gustavowd/FreePMU/Documents/F769-pinout1.jpg

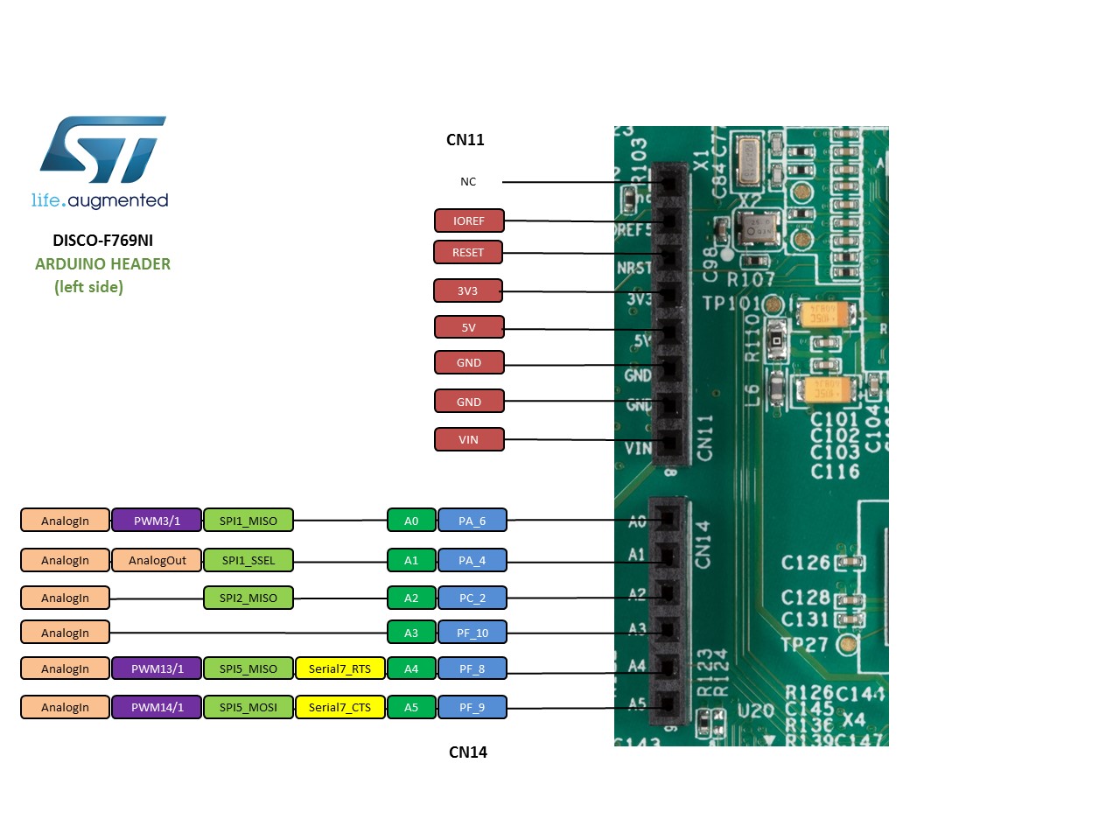
Documents/F769-pinout1.jpg
