gustavowd/FreePMU/Documents/F769-pinout2.jpg

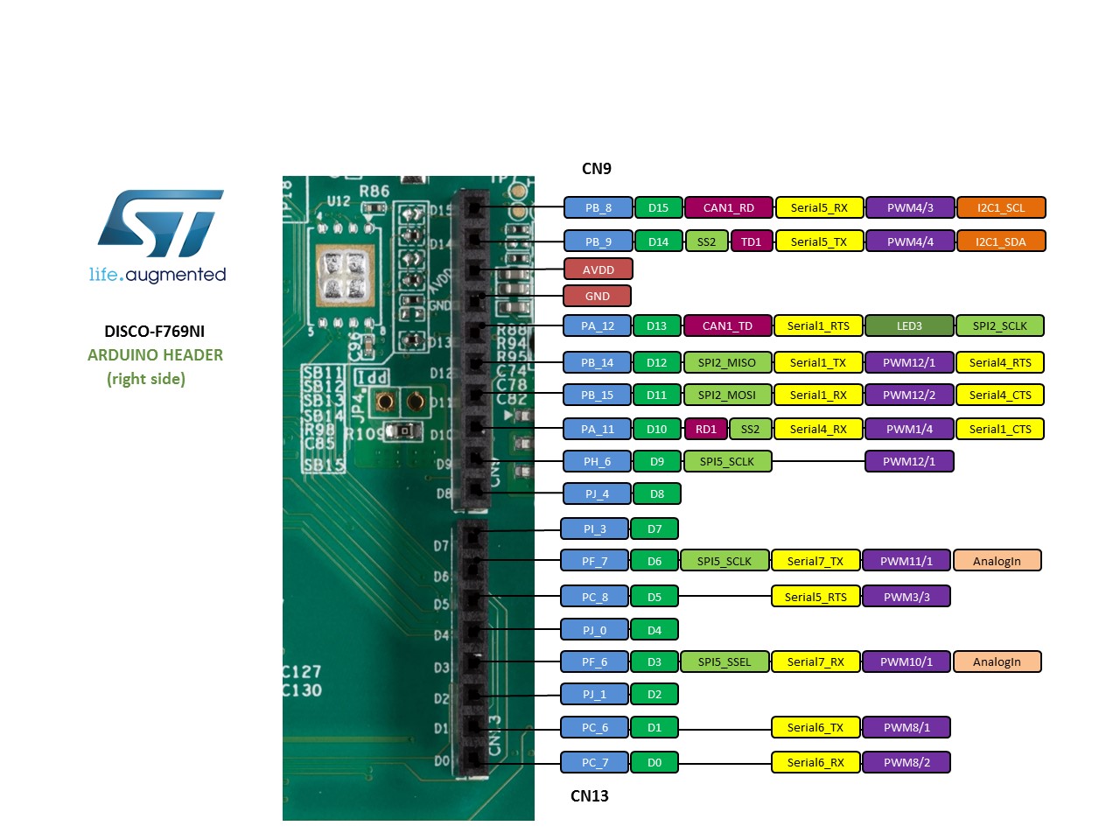
Documents/F769-pinout2.jpg
