gustavowd/FreePMU/Documents/GPS-pinout.jpg

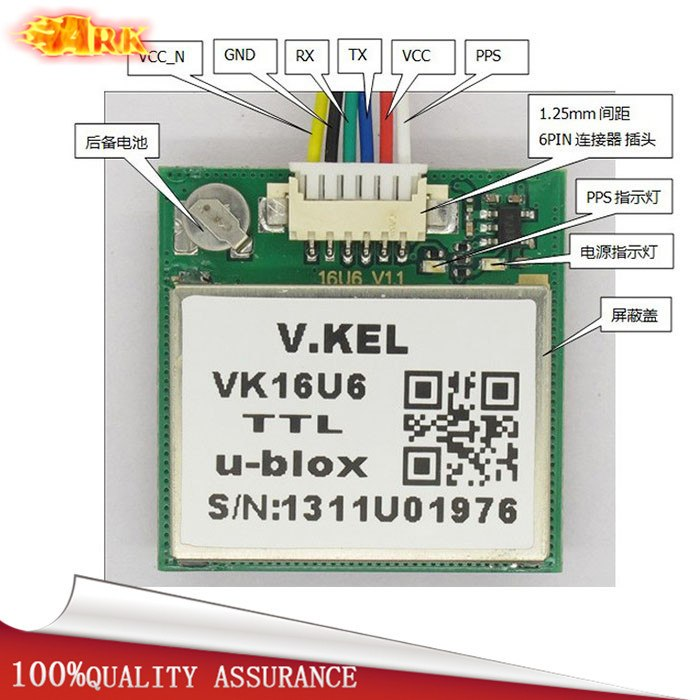
Documents/GPS-pinout.jpg
