gustavowd/FreePMU/Documents/pinout.png

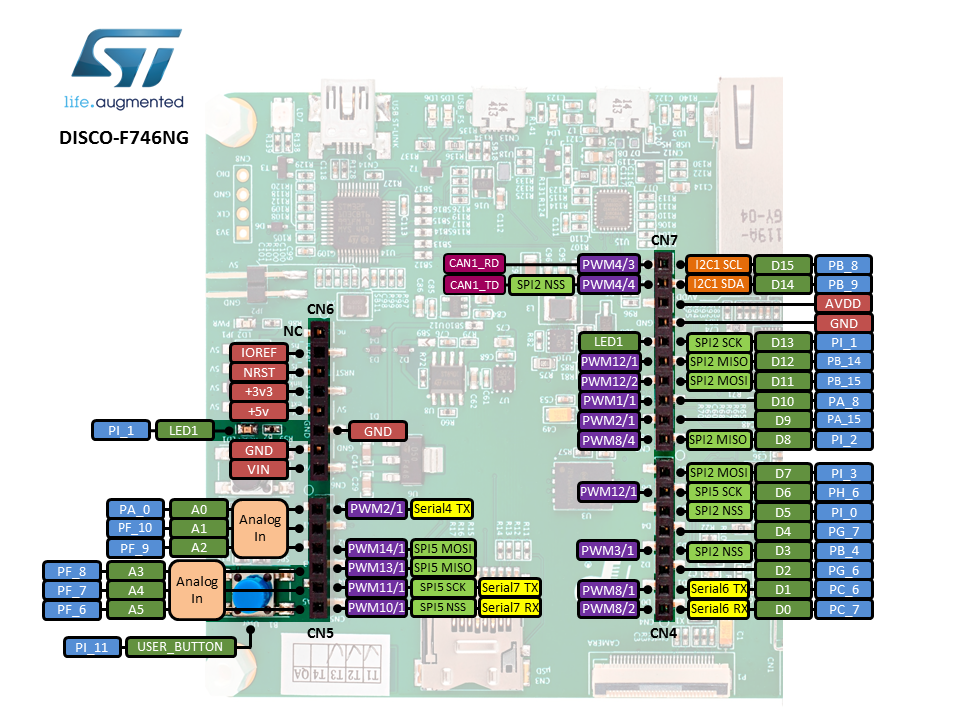
Documents/pinout.png
