gustavowd/FreePMU/Images/prototype.jpg

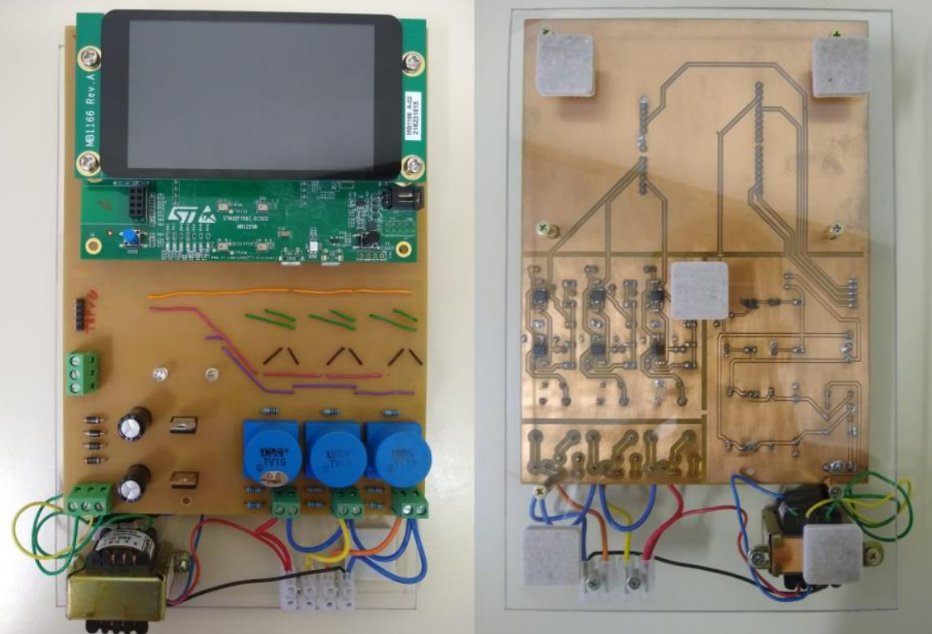
Images/prototype.jpg
