gustavowd/FreePMU/ProjetoEmbWizard/grid_a.bmp

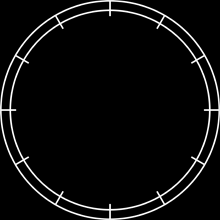
ProjetoEmbWizard/grid_a.bmp
