gustavowd/FreePMU/(threads)

Thread 3 (2022-02-03):

Add a UI switch to turn on/off the sampling rate correction

miguelmoreto, 2022-02-03:
In the Settings screen, it should be useful to add a switch to turn on or off the auto-adjustment of the sampling frequency according to the measured system frequency.  In the current version, this setting is a #define.
