gustavowd/FreePMU/PCB/microPMU-PCB-components.pdf

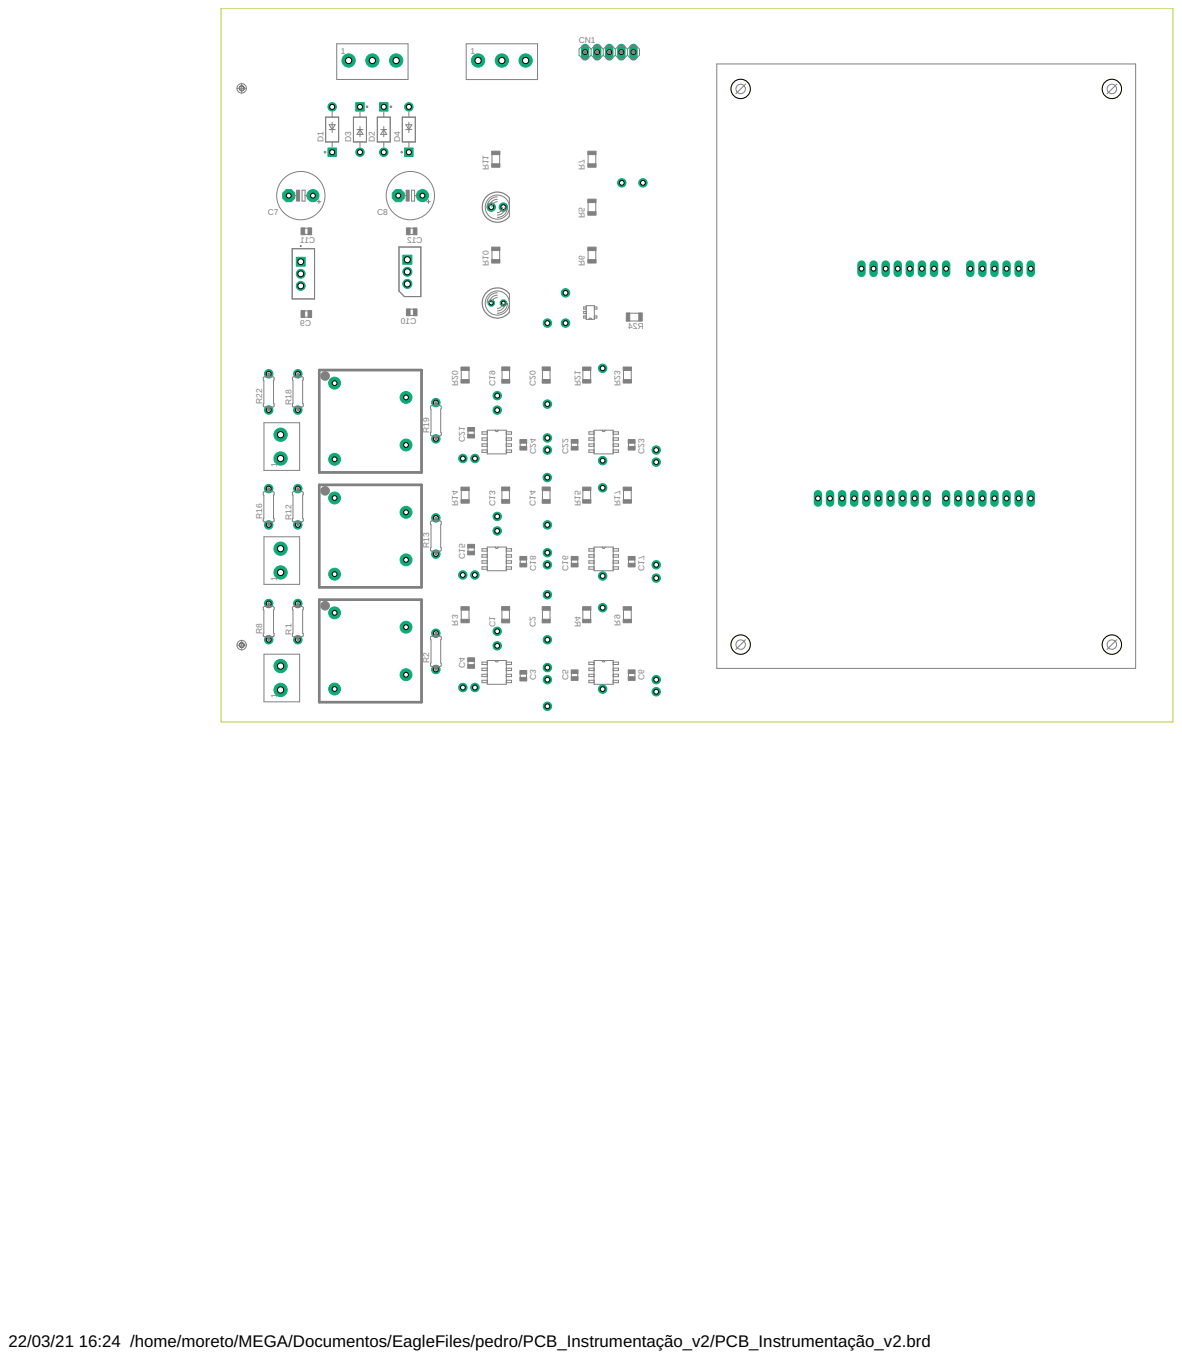
[picture p10: page 1]

22/03/21 16:24 /home/moreto/MEGA/Documentos/EagleFiles/pedro/PCB_Instrumentação_v2/PCB_Instrumentação_v2.brd
