gustavowd/FreePMU/PCB/microPMU-schematic.pdf

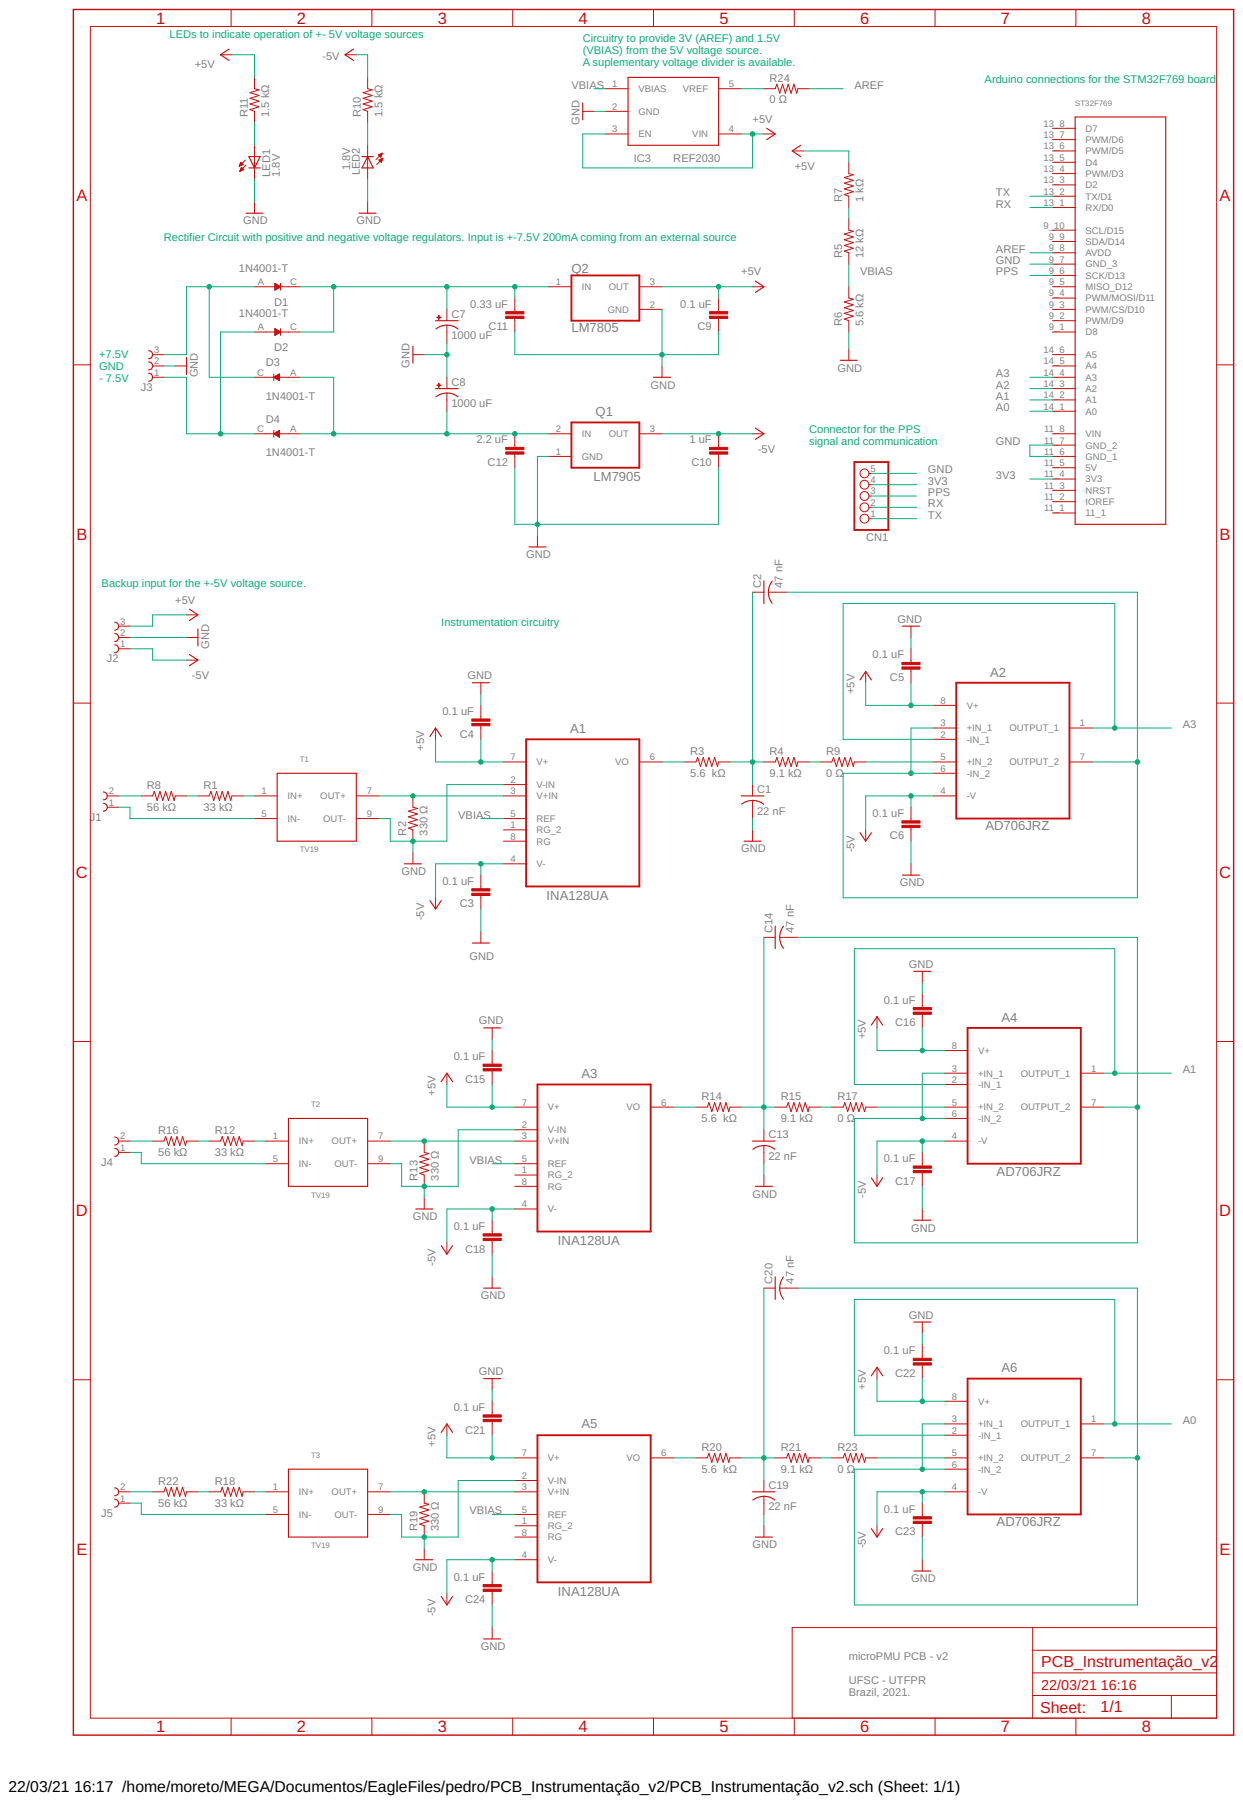
[picture p11: page 1]

LEDs to indicate operation of +- 5V voltage sources

Circuitry to provide 3V (AREF) and 1.5V

Rectifier Circuit with positive and negative voltage regulators. Input is +-7.5V 200mA coming from an external source

Backup input for the +-5V voltage source.

microPMU PCB - v2 UFSC - UTFPR Brazil, 2021.

Sheet: 1/1

22/03/21 16:17 /home/moreto/MEGA/Documentos/EagleFiles/pedro/PCB_Instrumentação_v2/PCB_Instrumentação_v2.sch (Sheet: 1/1)
