gustavowd/FreePMU/PCB/microPMU-PCB-all.pdf

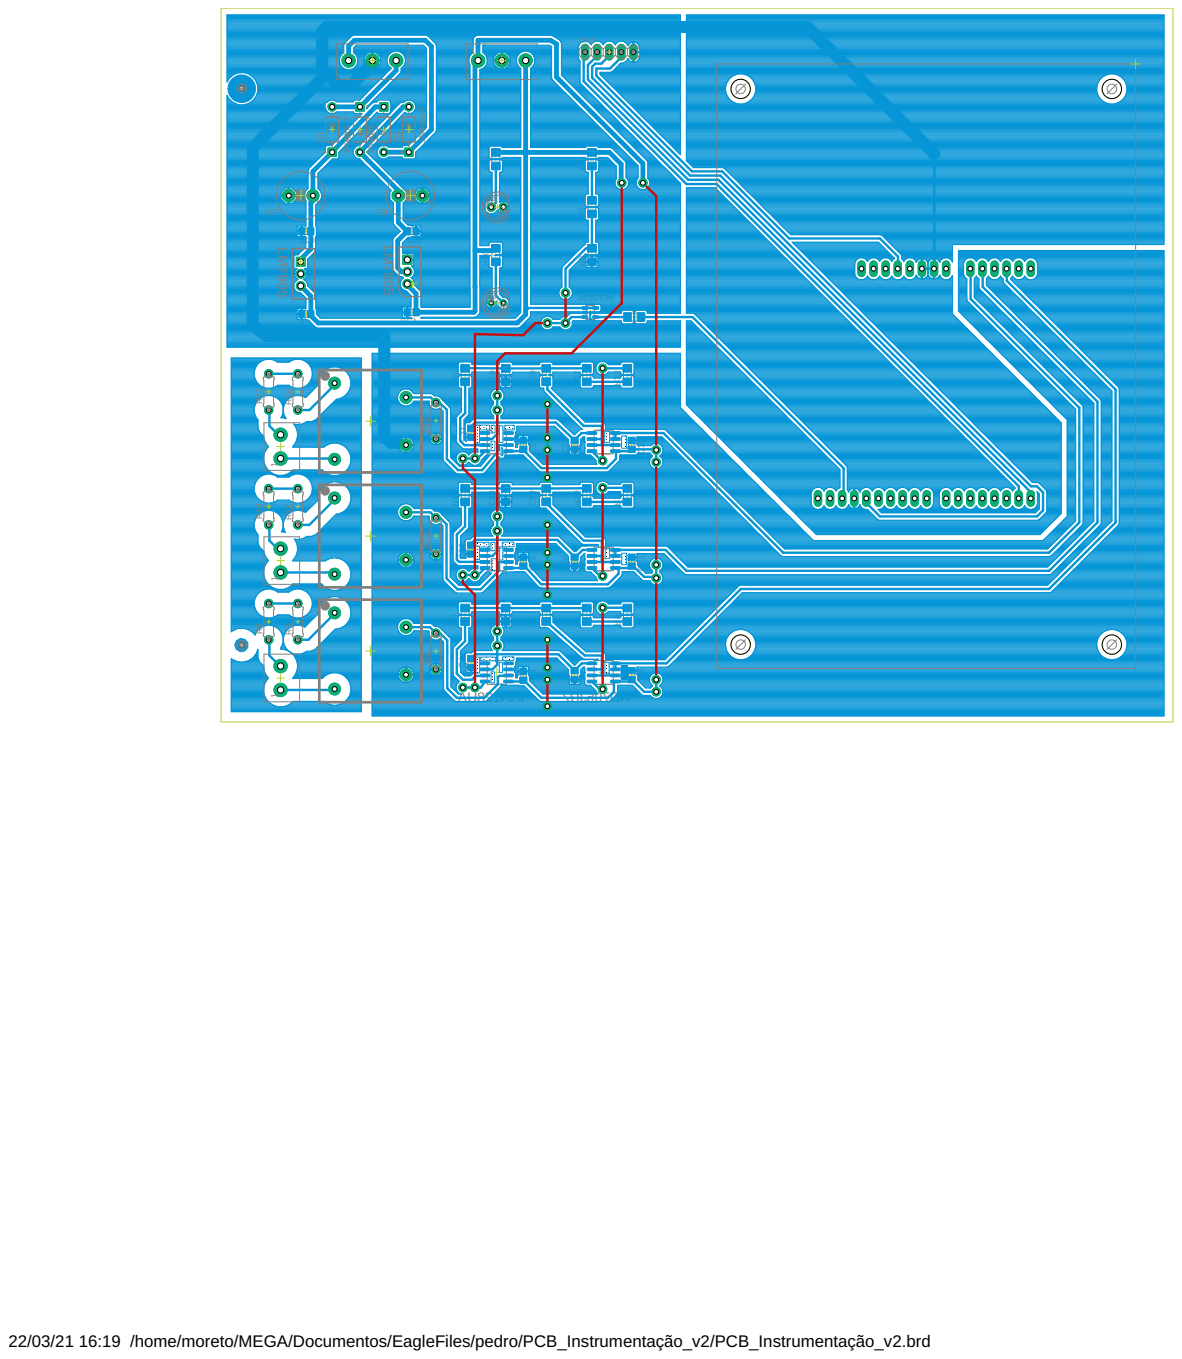
[picture p12: page 1]

22/03/21 16:19 /home/moreto/MEGA/Documentos/EagleFiles/pedro/PCB_Instrumentação_v2/PCB_Instrumentação_v2.brd
