gustavowd/FreePMU/PCB/microPMU-PCB-botton.pdf

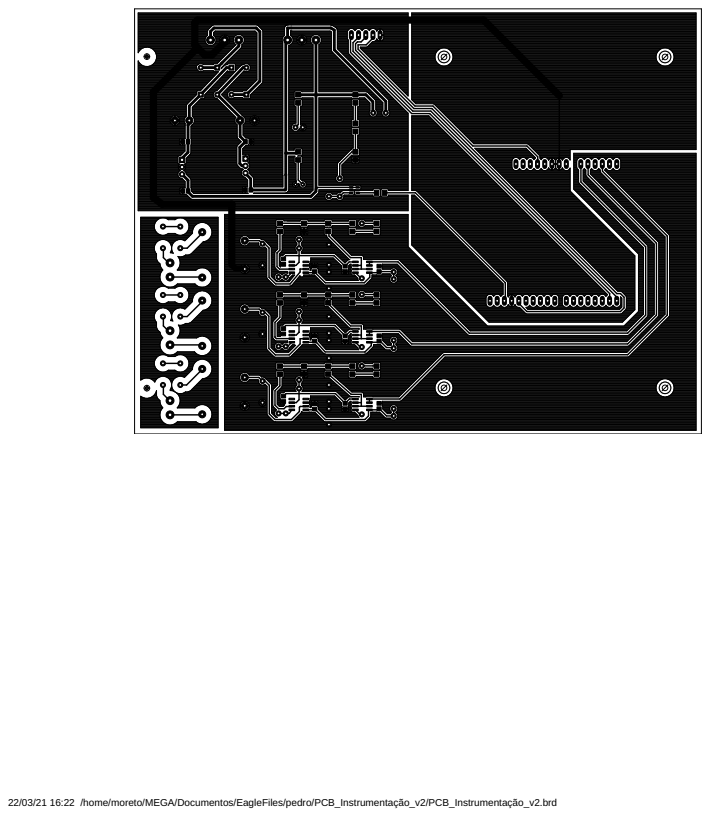
[picture p13: page 1]

22/03/21 16:22 /home/moreto/MEGA/Documentos/EagleFiles/pedro/PCB_Instrumentação_v2/PCB_Instrumentação_v2.brd
