gustavowd/FreePMU/PCB/PCB_Instrumentação_v2.brd

## EAGLE design PCB/PCB_Instrumentação_v2.brd (2021-03-22)

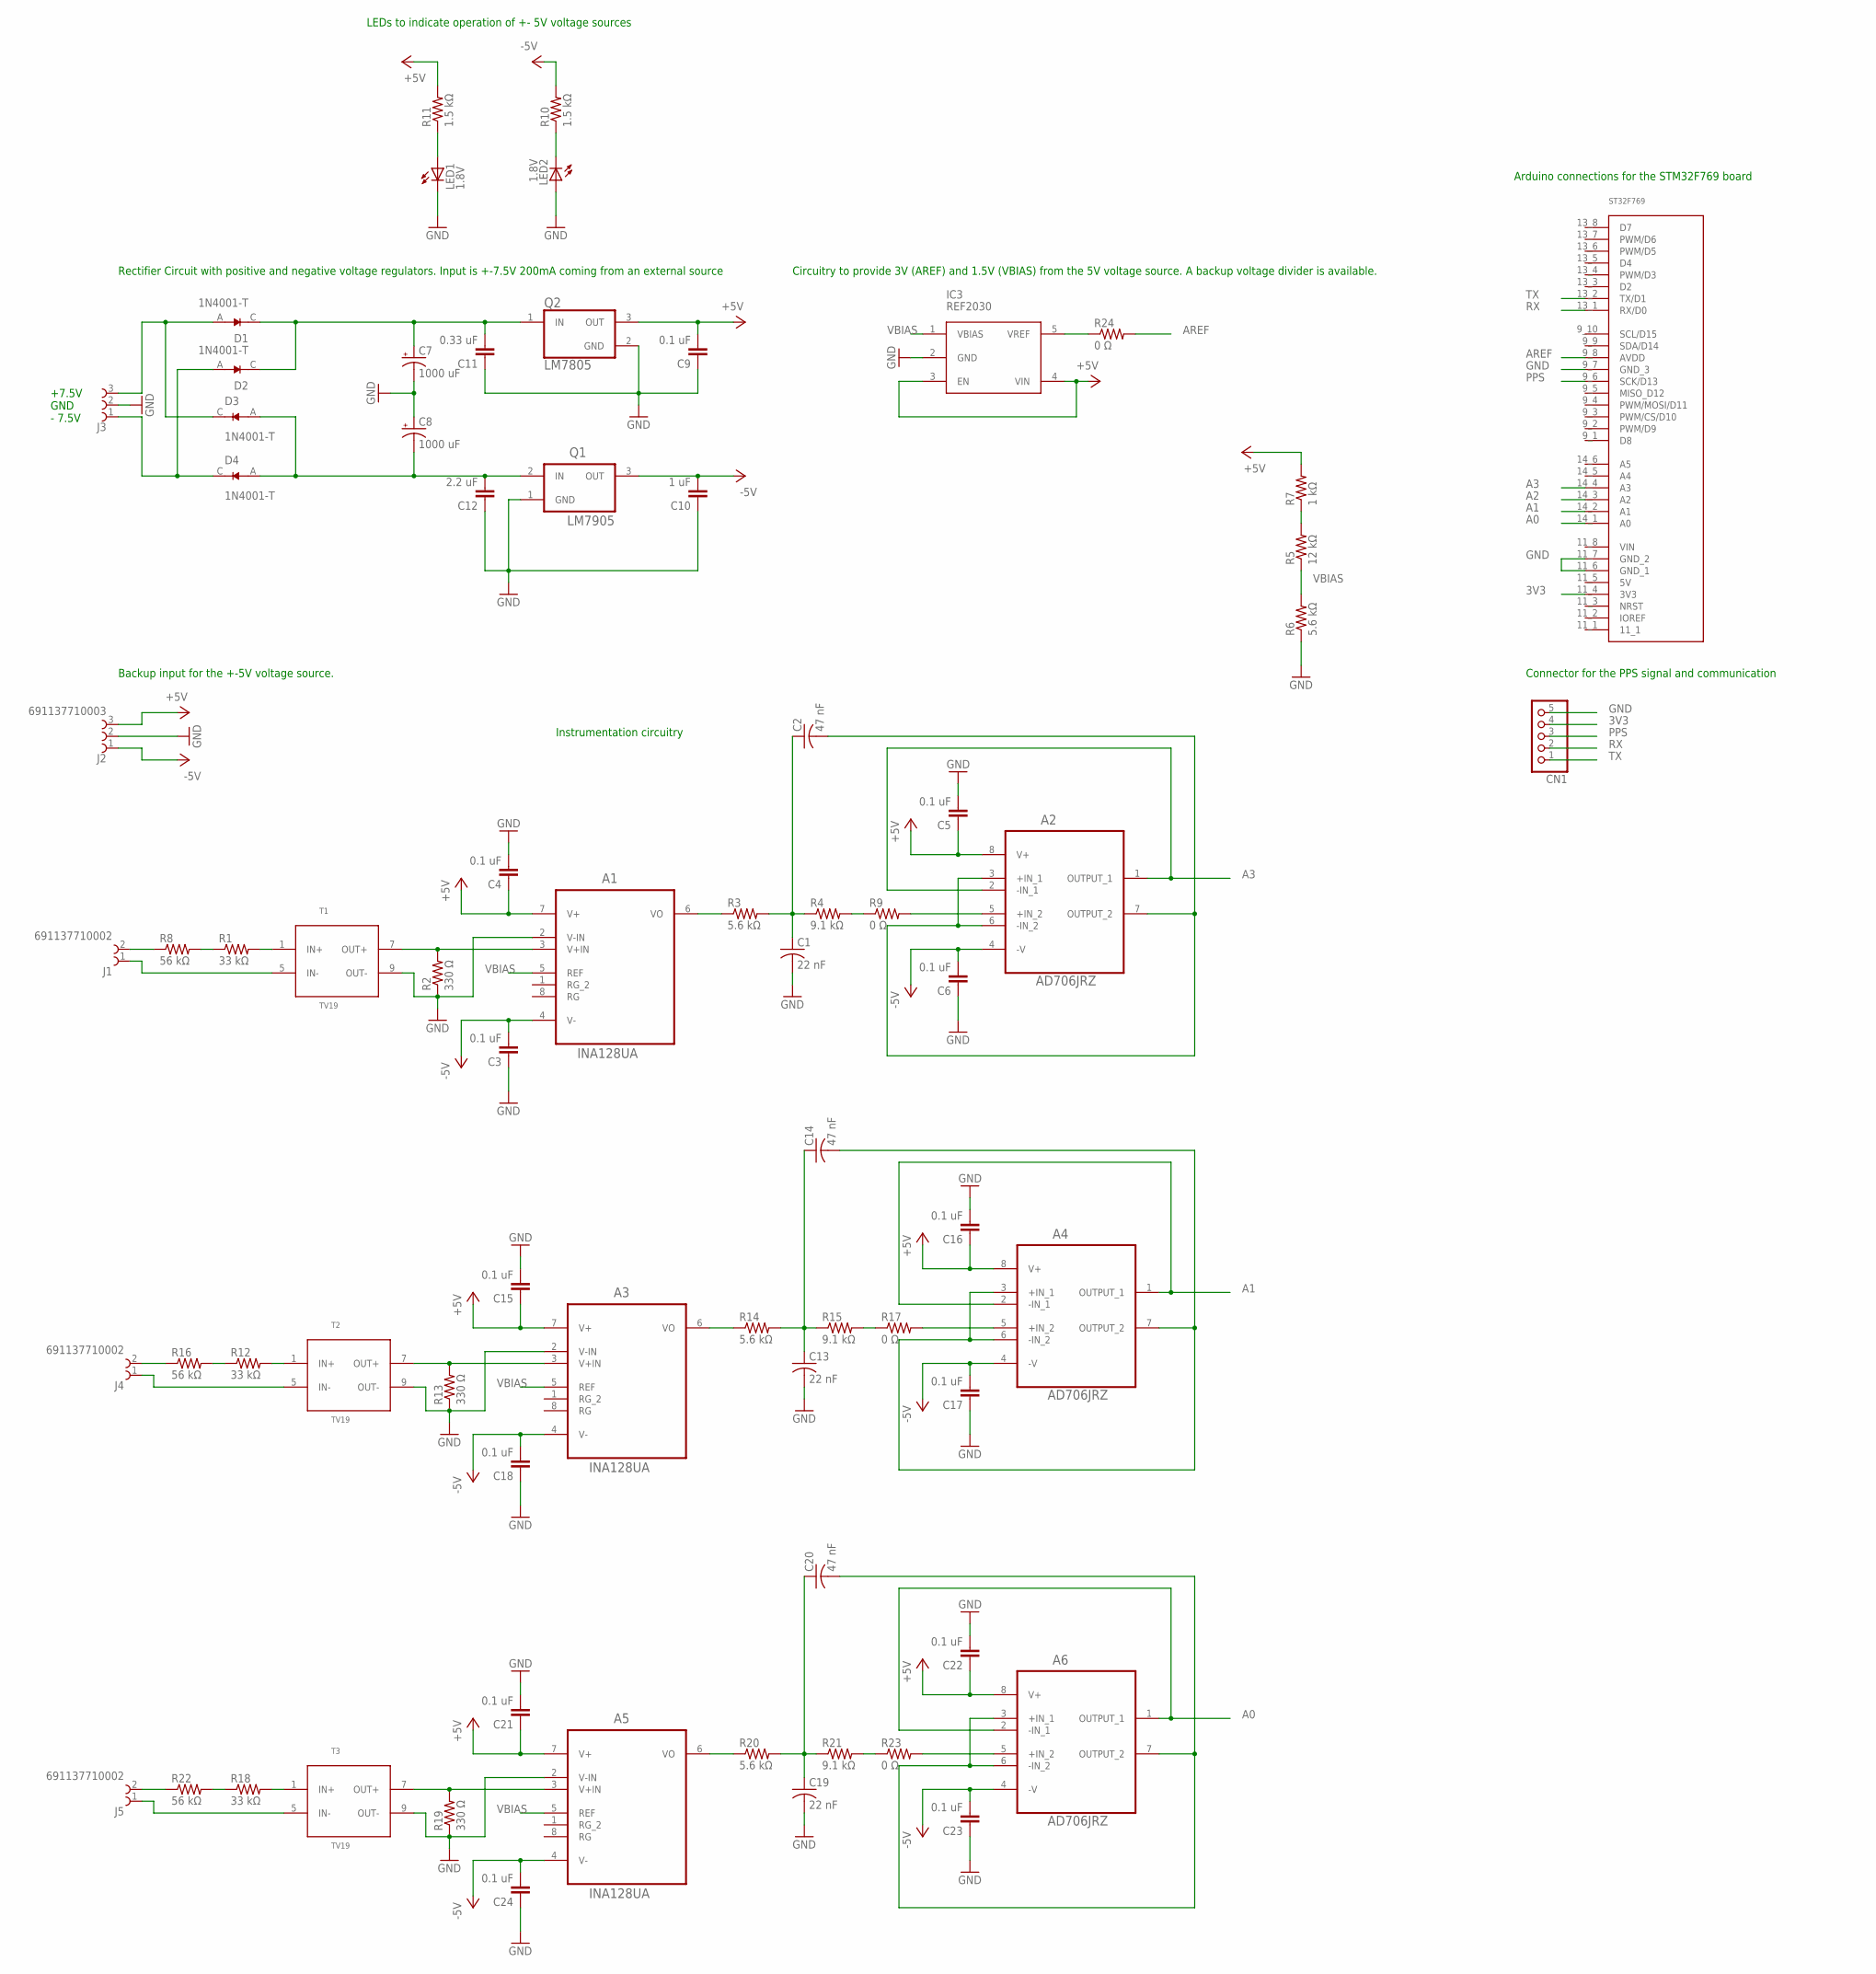
[picture p15: schematic PCB_Instrumentação_v2.sch]

Parts:
A1, A3, A5: INA128UA; SOIC127P600X175-8N
A2, A4, A6: AD706JRZ; SOIC127P600X175-8N
C1, C13, C19: 22 nF; C1206
C2, C14, C20: 47 nF; C1206
C3, C4, C5, C6, C9, C15, C16, C17, C18, C21, C22, C23, C24: 0.1 uF; C0805
C7, C8: 1000 uF; E5-10,5
C10: 1 uF; C0805
C11: 0.33 uF; C0805
C12: 2.2 uF; C0805
CN1: PINHD-1X5; 1X05
D1, D2, D3, D4: 1N4001-T; DIOAD953W69L521D272
IC3: REF2030; TSOT-23_S5
J1, J4, J5: 691137710002
J2, J3: 691137710003
LED1, LED2: 1.8V; LED5MM
Q1: LM7905; TO254P450X1020X1935-3P
Q2: LM7805; TO254P1054X470X2600-3
R1, R12, R18: 33 kΩ; 0207/7
R2, R13, R19: 330 Ω; 0207/7
R3, R6, R14, R20: 5.6 kΩ; R1206
R4, R15, R21: 9.1 kΩ; R1206
R5: 12 kΩ; R1206
R7: 1 kΩ; R1206
R8, R16, R22: 56 kΩ; 0207/7
R9, R17, R23, R24: 0 Ω; R1206
R10, R11: 1.5 kΩ; R1206
T1, T2, T3: TV19
U$1: ST32F769

Connections:
3V3: CN1.4, U$1.11_4 (3V3)
+5V: A1.7 (V+), A2.8 (V+), A3.7 (V+), A4.8 (V+), A5.7 (V+), A6.8 (V+), C4.1, C5.1, C9.2, C15.1, C16.1, C21.1, C22.1, IC3.3 (EN), IC3.4 (VIN), J2.3, Q2.3 (OUT), R7.2, R11.2
-5V: A1.4 (V-), A2.4 (-V), A3.4 (V-), A4.4 (-V), A5.4 (V-), A6.4 (-V), C3.2, C6.2, C10.2, C17.2, C18.2, C23.2, C24.2, J2.1, Q1.3 (OUT), R10.2
A0: A6.1 (OUTPUT_1), A6.2 (-IN_1), U$1.14_1 (A0)
A1: A4.1 (OUTPUT_1), A4.2 (-IN_1), U$1.14_2 (A1)
A2: U$1.14_3 (A2)
A3: A2.1 (OUTPUT_1), A2.2 (-IN_1), U$1.14_4 (A3)
AREF: R24.2, U$1.9_8 (AVDD)
GND: A1.2 (V-IN), A3.2 (V-IN), A5.2 (V-IN), C1.2, C3.1, C4.2, C5.2, C6.1, C7.-, C8.+, C9.1, C10.1, C11.1, C12.1, C13.2, C15.2, C16.2, C17.1, C18.1, C19.2, C21.2, C22.2, C23.1, C24.1, CN1.5, IC3.2 (GND), J2.2, J3.2, LED1.K (C), LED2.A, Q1.1 (GND), Q2.2 (GND), R2.1, R6.1, R13.1, R19.1, T1.9 (OUT-), T2.9 (OUT-), T3.9 (OUT-), U$1.9_7 (GND_3), U$1.11_6 (GND_1), U$1.11_7 (GND_2)
unnamed: R1.2, T1.1 (IN+)
unnamed: A1.3 (V+IN), R2.2, T1.7 (OUT+)
unnamed: A1.6 (VO), R3.1
unnamed: C1.1, C2.1, R3.2, R4.1
unnamed: R4.2, R9.1
unnamed: A2.3 (+IN_1), A2.6 (-IN_2), A2.7 (OUTPUT_2), C2.2
unnamed: R5.2, R7.1
unnamed: J1.2, R8.1
unnamed: J1.1, T1.5 (IN-)
unnamed: R1.1, R8.2
unnamed: C7.+, C11.2, D1.C, D2.C, Q2.1 (IN)
unnamed: C8.-, C12.2, D3.A, D4.A, Q1.2 (IN)
unnamed: D2.A, D4.C, J3.1
unnamed: D1.A, D3.C, J3.3
unnamed: A2.5 (+IN_2), R9.2
unnamed: LED1.A, R11.1
unnamed: LED2.K (C), R10.1
unnamed: R12.2, T2.1 (IN+)
unnamed: A3.3 (V+IN), R13.2, T2.7 (OUT+)
unnamed: A3.6 (VO), R14.1
unnamed: C13.1, C14.1, R14.2, R15.1
unnamed: A4.3 (+IN_1), A4.6 (-IN_2), A4.7 (OUTPUT_2), C14.2
unnamed: J4.1, T2.5 (IN-)
unnamed: J4.2, R16.1
unnamed: R12.1, R16.2
unnamed: R15.2, R17.1
unnamed: A4.5 (+IN_2), R17.2
unnamed: R18.2, T3.1 (IN+)
unnamed: A5.3 (V+IN), R19.2, T3.7 (OUT+)
unnamed: A5.6 (VO), R20.1
unnamed: C19.1, C20.1, R20.2, R21.1
unnamed: A6.3 (+IN_1), A6.6 (-IN_2), A6.7 (OUTPUT_2), C20.2
unnamed: J5.1, T3.5 (IN-)
unnamed: J5.2, R22.1
unnamed: R18.1, R22.2
unnamed: R21.2, R23.1
unnamed: A6.5 (+IN_2), R23.2
unnamed: IC3.5 (VREF), R24.1
PPS: CN1.3, U$1.9_6 (SCK/D13)
RX: CN1.2, U$1.13_1 (RX/D0)
TX: CN1.1, U$1.13_2 (TX/D1)
VBIAS: A1.5 (REF), A3.5 (REF), A5.5 (REF), IC3.1 (VBIAS), R5.1, R6.2

Notes on the sheet:
LEDs to indicate operation of +- 5V voltage sources
Rectifier Circuit with positive and negative voltage regulators. Input is +-7.5V 200mA coming from an external source
Circuitry to provide 3V (AREF) and 1.5V (VBIAS) from the 5V voltage source. A backup voltage divider is available.
Arduino connections for the STM32F769 board
Backup input for the +-5V voltage source.
Connector for the PPS signal and communication
Instrumentation circuitry
+7.5V GND - 7.5V

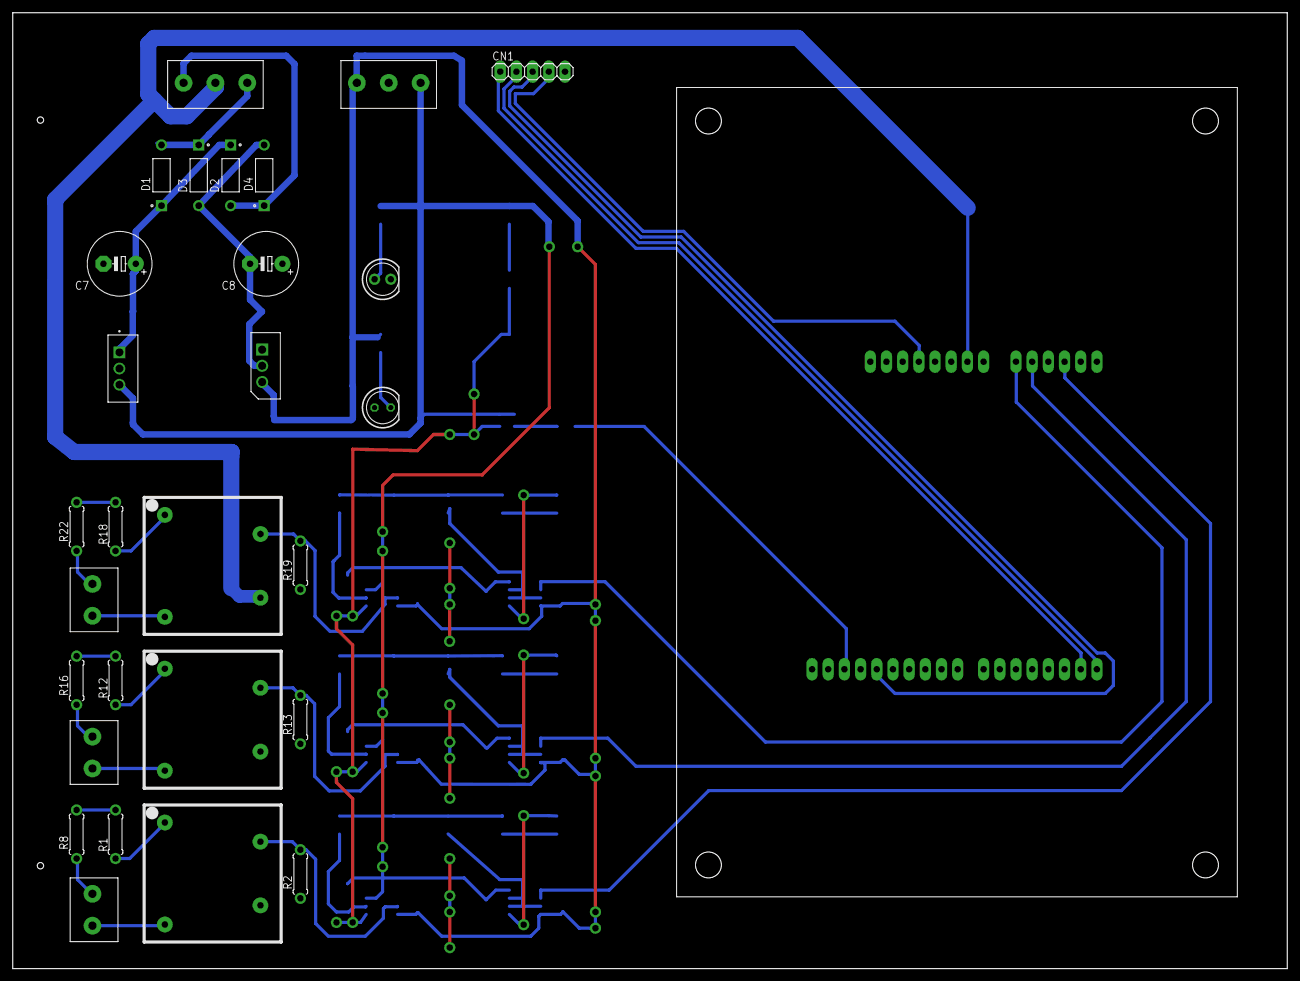
[picture p16: board PCB_Instrumentação_v2.brd from above]

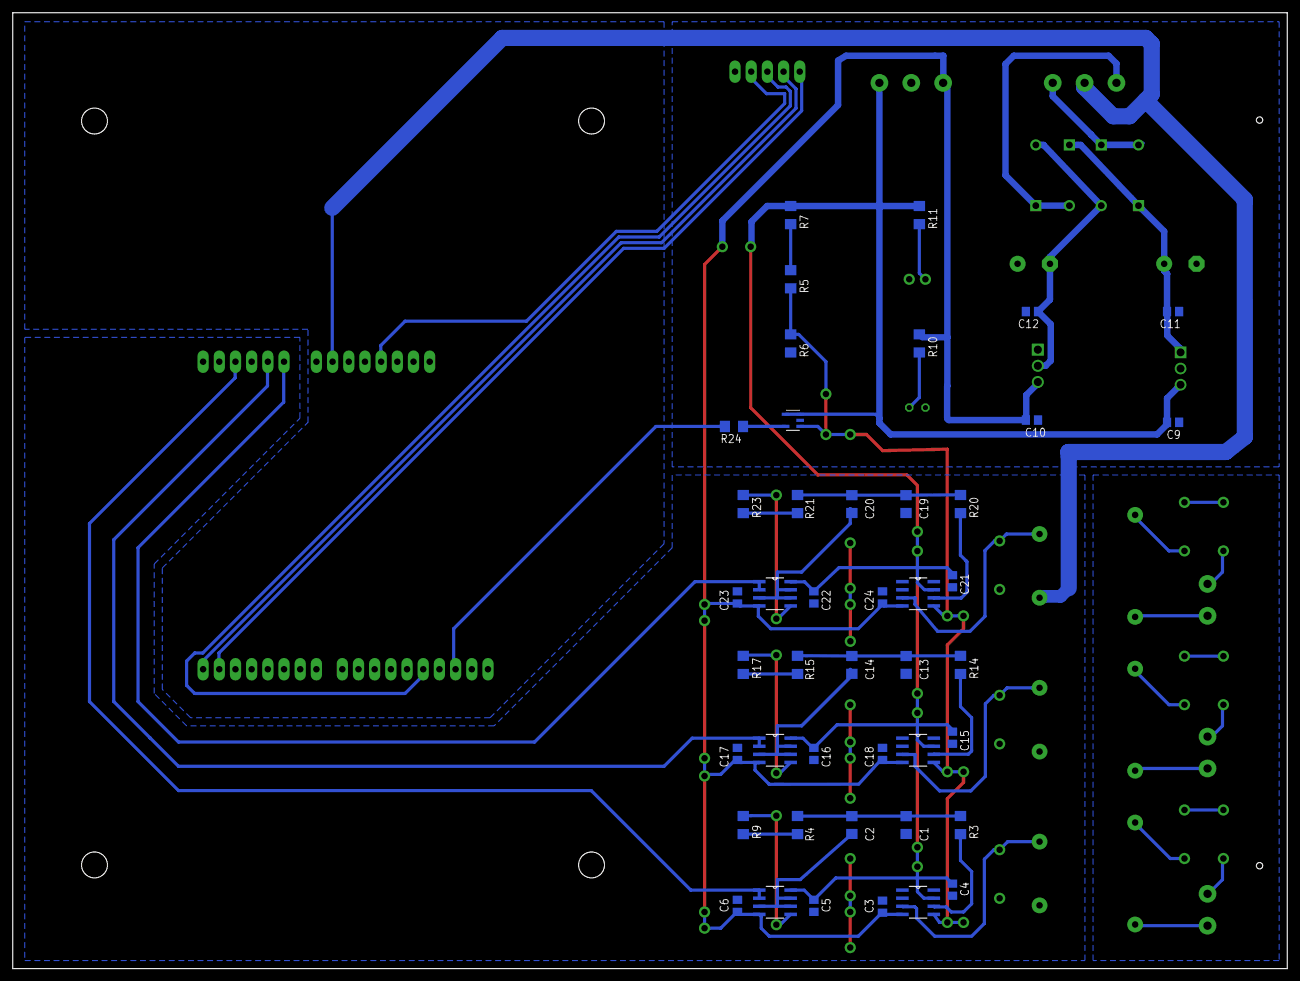
[picture p17: board PCB_Instrumentação_v2.brd from below]

Board: 2 copper layers, 200.0 x 150.0 mm, 73 parts (44 on the bottom side), 50 nets.
