gustavowd/FreePMU/STM32F769_EWizard/Inc/main.h

#define U8    unsigned char
#define I8    signed char
#define U16   unsigned short
#define I16   signed short
#define U32   unsigned
#define I32   int
#define U32   unsigned long
#define I32   signed long
#define PMUID	0x0001
#define NOMINAL_FREQ 60
#define NOMINAL_VOLTAGE 127
#define ENABLE_HARMONICS 1
#define OVERSAMPLING 1
#define GPS_BAUDRATE 115200
#define SIMULATED_GPS 0
#define FRACAO_DE_SEGUNDO_INIT 0
#define FRACAO_DE_SEGUNDO 0x00008235  //Fração de segundo 0,03333
#define LIMITE_FRACAO_DE_SEGUNDO 0xEC00B
#define FRACAO_DE_SEGUNDO 0x00009C40  // Fração de segundo = 0,04
#define LIMITE_FRACAO_DE_SEGUNDO 0xEA600
#define PEAK_GAIN	(float)2.0
#define RMS_GAIN	(float)1.414213562
#define PEAK_OR_RMS	RMS_GAIN
#define TCP_PMU 0
#define UDP_PMU 1
#define TRANSPORT_PROTOCOL TCP_PMU
#define CORR_HTIM1 1
#define NORM_GAIN_127V_R	(float)3.048178533
#define NORM_GAIN_127V_S	(float)3.031196288
#define NORM_GAIN_127V_T	(float)3.047962608
#define NORM_GAIN_220V_R	(float)1.759630335
#define NORM_GAIN_220V_S	(float)1.749826948
#define NORM_GAIN_220V_T	(float)1.759505687
#define MAG_GAIN_R			(float)42.3832
#define MAG_GAIN_S			(float)42.4718
#define MAG_GAIN_T			(float)42.45794
#define FIT_MAG_GAIN_A_R	(float)-0.0016362996
#define FIT_MAG_GAIN_B_R	(float)6.4330443785
#define FIT_MAG_GAIN_C_R	(float)0.0658874232
#define FIT_MAG_GAIN_D_R	(float)0.0351025233
#define FIT_MAG_GAIN_A_S	(float)0.0009628812
#define FIT_MAG_GAIN_B_S	(float)6.3757106266
#define FIT_MAG_GAIN_C_S	(float)0.0686457110
#define FIT_MAG_GAIN_D_S	(float)0.0299965117
#define FIT_MAG_GAIN_A_T	(float)0.0004282697
#define FIT_MAG_GAIN_B_T	(float)6.4019875313
#define FIT_MAG_GAIN_C_T	(float)0.0981472053
#define FIT_MAG_GAIN_D_T	(float)0.0467723654
#define FIT_PHASE_GAIN_A_R	(float)60.256916502
#define FIT_PHASE_GAIN_B_R	(float)0.1863745932
#define FIT_PHASE_GAIN_C_R	(float)0.0076768782
#define FIT_PHASE_GAIN_A_S	(float)60.273407182
#define FIT_PHASE_GAIN_B_S	(float)0.2463213789
#define FIT_PHASE_GAIN_C_S	(float)0.0144579474
#define FIT_PHASE_GAIN_A_T	(float)60.271458135
#define FIT_PHASE_GAIN_B_T	(float)0.1695834628
#define FIT_PHASE_GAIN_C_T	(float)0.0045740754
#define FIT_FREQ_GAIN_A_R		(float)-2.5770186918
#define FIT_FREQ_GAIN_B_R		(float)0.0521374904
#define FIT_FREQ_GAIN_A_S		(float)-2.6741303661
#define FIT_FREQ_GAIN_B_S		(float)0.0537621928
#define FIT_FREQ_GAIN_A_T		(float)-2.3885333996
#define FIT_FREQ_GAIN_B_T		(float)0.0485053178
