gustavowd/FreePMU/STM32F769_EWizard/Src/EmbeddedWizardApp/Core.c

/*******************************************************************************
*
* E M B E D D E D   W I Z A R D   P R O J E C T
*
*                                                Copyright (c) TARA Systems GmbH
*                                    written by Paul Banach and Manfred Schweyer
*
********************************************************************************
*
* This file was generated automatically by Embedded Wizard Studio.
*
* Please do not make any modifications of this file! The modifications are lost
* when the file is generated again by Embedded Wizard Studio!
*
* The template of this heading text can be found in the file 'head.ewt' in the
* directory 'Platforms' of your Embedded Wizard installation directory. If you
* wish to adapt this text, please copy the template file 'head.ewt' into your
* project directory and edit the copy only. Please avoid any modifications of
* the original template file!
*
* Version  : 9.00
* Profile  : STM32F769
* Platform : STM.STM32.RGB565
*
*******************************************************************************/

#include "ewlocale.h"
#include "_ApplicationAplic.h"
#include "_CoreCursorEvent.h"
#include "_CoreCursorGrabEvent.h"
#include "_CoreCursorHit.h"
#include "_CoreDialogContext.h"
#include "_CoreDragEvent.h"
#include "_CoreEvent.h"
#include "_CoreGroup.h"
#include "_CoreKeyEvent.h"
#include "_CoreKeyPressHandler.h"
#include "_CoreLayoutContext.h"
#include "_CoreLayoutLineContext.h"
#include "_CoreLayoutQuadContext.h"
#include "_CoreLineView.h"
#include "_CoreModalContext.h"
#include "_CoreOutline.h"
#include "_CoreQuadView.h"
#include "_CoreRectView.h"
#include "_CoreResource.h"
#include "_CoreRoot.h"
#include "_CoreSimpleTouchHandler.h"
#include "_CoreSystemEvent.h"
#include "_CoreSystemEventHandler.h"
#include "_CoreSystemEventTask.h"
#include "_CoreTask.h"
#include "_CoreTaskQueue.h"
#include "_CoreTimer.h"
#include "_CoreView.h"
#include "_CoreWipeTouchHandler.h"
#include "_GraphicsCanvas.h"
#include "_ResourcesBitmap.h"
#include "Core.h"

/* Compressed strings for the language 'Default'. */
static const unsigned int _StringsDefault0[] =
{
  0x000002E6, /* ratio 50.13 % */
  0xB8005500, 0x00000452, 0x00D0002A, 0x04000328, 0xD2003B00, 0xA770042C, 0x00320021,
  0x639C4CDE, 0x00464DD1, 0x998A2C74, 0xC7A3E6C8, 0x6A431633, 0xA1521874, 0x510E8E44,
  0x0758F9CA, 0x00831C00, 0x082C0C2C, 0x8747C9C0, 0xAC322510, 0x8027F2C8, 0x86390C99,
  0x0C60030C, 0x3B383580, 0x256834EC, 0x56A244E2, 0xA8F00261, 0x8943A431, 0x04BA8B1E,
  0x4D2655A0, 0x4C25389B, 0xE83469ED, 0x994694D5, 0x7068C462, 0x42AADAC3, 0x5A645A29,
  0xB9002912, 0x0458F200, 0x59A2D7BB, 0x1A6F358D, 0xCA56B1A4, 0x6735A744, 0x91089472,
  0x0FADD7E1, 0x292802FF, 0x90D32311, 0x88022F96, 0x6164F56C, 0x4F2921A7, 0xF4589874,
  0x034DD5E7, 0xD0C92EC7, 0x6B2C4E05, 0xBD0C2A11, 0x2860A264, 0x05923747, 0x47B34480,
  0x5F83B48C, 0x0DB0CAD6, 0xE70C9180, 0xB0E8C44E, 0xA596C4A2, 0x38FD870B, 0x9063CD52,
  0x7D7A3F1D, 0x4A30913E, 0xCE191887, 0xA2DD1D54, 0x9D1AE099, 0xD1F21C3B, 0xF7000EAF,
  0x8D1FC08F, 0x1C41B6D6, 0x982705B9, 0x14AD7079, 0x391E531B, 0x0E4950C5, 0x53145531,
  0x10E5411C, 0x0439E057, 0x012666DD, 0x45811280, 0x4BDD8819, 0x1FC1C516, 0x14313543,
  0x04234E02, 0x9880D338, 0x819E079D, 0x6224790C, 0xF6162389, 0x821270E0, 0x266C5D67,
  0x4063E4E2, 0x00000000
};

/* Constant values used in this 'C' module only. */
static const XPoint _Const0000 = { 0, 0 };
static const XRect _Const0001 = {{ 0, 0 }, { 0, 0 }};
static const XStringRes _Const0002 = { _StringsDefault0, 0x0003 };
static const XStringRes _Const0003 = { _StringsDefault0, 0x002D };
static const XStringRes _Const0004 = { _StringsDefault0, 0x0043 };
static const XStringRes _Const0005 = { _StringsDefault0, 0x0060 };
static const XStringRes _Const0006 = { _StringsDefault0, 0x0072 };
static const XColor _Const0007 = { 0x00, 0x00, 0x00, 0x00 };
static const XStringRes _Const0008 = { _StringsDefault0, 0x008D };
static const XStringRes _Const0009 = { _StringsDefault0, 0x00C1 };
static const XStringRes _Const000A = { _StringsDefault0, 0x0119 };
static const XStringRes _Const000B = { _StringsDefault0, 0x0151 };

#ifndef EW_DONT_CHECK_INDEX
  /* This function is used to check the indices when accessing an array.
     If you don't want this verification add the define EW_DONT_CHECK_INDEX
     to your Makefile or project settings. */
  static int EwCheckIndex( int aIndex, int aRange, const char* aFile, int aLine )
  {
    if (( aIndex < 0 ) || ( aIndex >= aRange ))
    {
      EwPrint( "[FATAL ERROR in %s:%d] Array index %d out of bounds %d",
                aFile, aLine, aIndex, aRange );
      EwPanic();
    }
    return aIndex;
  }

  #define EwCheckIndex( aIndex, aRange ) \
    EwCheckIndex( aIndex, aRange, __FILE__, __LINE__ )
#else
  #define EwCheckIndex( aIndex, aRange ) aIndex
#endif

/* Global constant containing the preferred size of the screen in pixel. */
const XPoint EwScreenSize = { 800, 480 };

/* Global constant containing the main application class. */
const XClass EwApplicationClass = EW_CLASS( ApplicationAplic );

/* Global constant containing the user defined application title. */
const char* EwApplicationTitle = "";

/* Initializer for the class 'Core::View' */
void CoreView__Init( CoreView _this, XObject aLink, XHandle aArg )
{
  /* At first initialize the super class ... */
  XObject__Init( &_this->_Super, aLink, aArg );

  /* Setup the VMT pointer */
  _this->_VMT = EW_CLASS( CoreView );

  /* ... and initialize objects, variables, properties, etc. */
  _this->viewState = CoreViewStateAlphaBlended | CoreViewStateFastReshape | CoreViewStateVisible;
  _this->Layout = CoreLayoutAlignToLeft | CoreLayoutAlignToTop;
}

/* Re-Initializer for the class 'Core::View' */
void CoreView__ReInit( CoreView _this )
{
  /* At first re-initialize the super class ... */
  XObject__ReInit( &_this->_Super );
}

/* Finalizer method for the class 'Core::View' */
void CoreView__Done( CoreView _this )
{
  /* Finalize this class */
  _this->_VMT = EW_CLASS( CoreView );

  /* Don't forget to deinitialize the super class ... */
  XObject__Done( &_this->_Super );
}

/* Garbage Collector method for the class 'Core::View' */
void CoreView__Mark( CoreView _this )
{
  EwMarkObject( _this->next );
  EwMarkObject( _this->prev );
  EwMarkObject( _this->Owner );
  EwMarkObject( _this->layoutContext );

  /* Give the super class a chance to mark its objects and references */
  XObject__Mark( &_this->_Super );
}

/* 'C' function for method : 'Core::View.initLayoutContext()' */
void CoreView_initLayoutContext( CoreView _this, XRect aBounds, CoreOutline aOutline )
{
  /* Dummy expressions to avoid the 'C' warning 'unused argument'. */
  EW_UNUSED_ARG( _this );
  EW_UNUSED_ARG( aOutline );
  EW_UNUSED_ARG( aBounds );
}

/* Wrapper function for the virtual method : 'Core::View.initLayoutContext()' */
void CoreView__initLayoutContext( void* _this, XRect aBounds, CoreOutline aOutline )
{
  ((CoreView)_this)->_VMT->initLayoutContext((CoreView)_this, aBounds, aOutline );
}

/* 'C' function for method : 'Core::View.OnSetLayout()' */
void CoreView_OnSetLayout( CoreView _this, XSet value )
{
  XSet delta = value ^ _this->Layout;

  if ( !delta )
    return;

  _this->Layout = value;

  if (( _this->layoutContext != 0 ) && !(( _this->viewState & CoreViewStateEmbedded 
      ) == CoreViewStateEmbedded ))
  {
    _this->Owner->Super2.viewState = _this->Owner->Super2.viewState | ( CoreViewStatePendingLayout 
    | CoreViewStateUpdateLayout );
    EwPostSignal( EwNewSlot( _this->Owner, CoreGroup_updateComponent ), ((XObject)_this 
      ));
    CoreGroup__InvalidateArea( _this->Owner, EwGetRectORect( _this->Owner->Super1.Bounds 
    ));
  }

  if (( _this->layoutContext != 0 ) && (( _this->viewState & CoreViewStateEmbedded 
      ) == CoreViewStateEmbedded ))
  {
    _this->layoutContext->outline->Super2.viewState = _this->layoutContext->outline->Super2.viewState 
    | CoreViewStateUpdateLayout;
    _this->Owner->Super2.viewState = _this->Owner->Super2.viewState | CoreViewStatePendingLayout;
    EwPostSignal( EwNewSlot( _this->Owner, CoreGroup_updateComponent ), ((XObject)_this 
      ));
  }
}

/* The method GetRoot() delivers the application object, this view belongs to. The 
   application object represents the entire screen of the GUI application. Thus 
   in the views hierarchy, the application object serves as the root view.
   This method can fail and return null if the view still doesn't belong to any 
   owner group. */
CoreRoot CoreView_GetRoot( CoreView _this )
{
  CoreGroup grp = _this->Owner;

  while ( grp != 0 )
  {
    CoreRoot root = EwCastObject( grp, CoreRoot );

    if ( root != 0 )
      return root;

    grp = grp->Super2.Owner;
  }

  return 0;
}

/* Wrapper function for the virtual method : 'Core::View.GetRoot()' */
CoreRoot CoreView__GetRoot( void* _this )
{
  return ((CoreView)_this)->_VMT->GetRoot((CoreView)_this );
}

/* The method Draw() is invoked automatically if parts of the view should be redrawn 
   on the screen. This can occur when e.g. the view has been moved or the appearance 
   of the view has changed before.
   Draw() is invoked automatically by the framework, you never will need to invoke 
   this method directly. However you can request an invocation of this method by 
   calling the method InvalidateArea() of the views @Owner. Usually this is also 
   unnecessary unless you are developing your own view.
   The passed parameters determine the drawing destination aCanvas and the area 
   to redraw aClip in the coordinate space of the canvas. The parameter aOffset 
   contains the displacement between the origin of the views owner and the origin 
   of the canvas. You will need it to convert views coordinates into these of the 
   canvas.
   The parameter aOpacity contains the opacity descended from this view's @Owner. 
   It lies in range 0 .. 255. If the view implements its own 'Opacity', 'Color', 
   etc. properties, the Draw() method should calculate the resulting real opacity 
   by mixing the values of these properties with the one passed in aOpacity parameter.
   The parameter aBlend contains the blending mode descended from this view's @Owner. 
   It determines, whether the view should be drawn with alpha-blending active or 
   not. If aBlend is false, the outputs of the view should overwrite the corresponding 
   pixel in the drawing destination aCanvas. If aBlend is true, the outputs should 
   be mixed with the pixel already stored in aCanvas. For this purpose all Graphics 
   Engine functions provide a parameter to specify the mode for the respective drawing 
   operation. If the view implements its own 'Blend' property, the Draw() method 
   should calculate the resulting real blend mode by using logical AND operation 
   of the value of the property and the one passed in aBlend parameter. */
void CoreView_Draw( CoreView _this, GraphicsCanvas aCanvas, XRect aClip, XPoint 
  aOffset, XInt32 aOpacity, XBool aBlend )
{
  /* Dummy expressions to avoid the 'C' warning 'unused argument'. */
  EW_UNUSED_ARG( _this );
  EW_UNUSED_ARG( aBlend );
  EW_UNUSED_ARG( aOpacity );
  EW_UNUSED_ARG( aOffset );
  EW_UNUSED_ARG( aClip );
  EW_UNUSED_ARG( aCanvas );
}

/* Wrapper function for the virtual method : 'Core::View.Draw()' */
void CoreView__Draw( void* _this, GraphicsCanvas aCanvas, XRect aClip, XPoint aOffset, 
  XInt32 aOpacity, XBool aBlend )
{
  ((CoreView)_this)->_VMT->Draw((CoreView)_this, aCanvas, aClip, aOffset, aOpacity
  , aBlend );
}

/* The method HandleEvent() is invoked automatically if the view has received an 
   event. For example, touching the view on the touch screen can cause the view 
   to receive a Core::CursorEvent event. Within this method the view can evaluate 
   the event and react to it.
   Whether the event has been handled by the view or not is determined by the return 
   value. To sign an event as handled HandleEvent() should return a valid object 
   (e.g. 'this'). If the event has not been handled, 'null' should be returned.
   Depending on the kind of the event, the framework can continue dispatching of 
   still unhandled events. For example, keyboard events (Core::KeyEvent class) are 
   automatically delivered to the superior @Owner of the receiver view if this view 
   has ignored the event.
   HandleEvent() is invoked automatically by the framework, so you never should 
   need to invoke it directly. However you can prepare and post new events by using 
   the methods DispatchEvent() and BroadcastEvent() of the application class Core::Root. */
XObject CoreView_HandleEvent( CoreView _this, CoreEvent aEvent )
{
  /* Dummy expressions to avoid the 'C' warning 'unused argument'. */
  EW_UNUSED_ARG( _this );
  EW_UNUSED_ARG( aEvent );

  return 0;
}

/* Wrapper function for the virtual method : 'Core::View.HandleEvent()' */
XObject CoreView__HandleEvent( void* _this, CoreEvent aEvent )
{
  return ((CoreView)_this)->_VMT->HandleEvent((CoreView)_this, aEvent );
}

/* The method CursorHitTest() is invoked automatically in order to determine whether 
   the view is interested in the receipt of cursor events or not. This method will 
   be invoked immediately after the user has tapped the visible area of the view. 
   If the view is not interested in the cursor event, the framework repeats this 
   procedure for the next behind view until a willing view has been found or all 
   views are evaluated.
   In the implementation of the method the view can evaluate the passed aArea parameter. 
   It determines the place where the user has tapped the view with his fingertip 
   expressed in the coordinates of the views @Owner. The method can test e.g. whether 
   the tapped area does intersect any touchable areas within the view, etc. The 
   affected finger is identified in the parameter aFinger. The first finger (or 
   the first mouse device button) has the number 0.
   The parameter aStrikeCount determines how many times the same area has been tapped 
   in series. This is useful to detect series of multiple touches, e.g. in case 
   of the double click, aStrikeCount == 2.
   The parameter aDedicatedView, if it is not 'null', restricts the event to be 
   handled by this view only. If aDedicatedView == null, no special restriction 
   exists.
   This method is also invoked if during an existing grab cycle the current target 
   view has decided to resign and deflect the cursor events to another view. This 
   is usually the case after the user has performed a gesture the current target 
   view is not interested to process. Thereupon, the system looks for another view 
   willing to take over the cursor event processing after the performed gesture. 
   Which gesture has caused the operation, is specified in the parameter aRetargetReason.
   If the view is willing to process the event, the method should create, initialize 
   and return a new Core::CursorHit object. This object identify the willing view. 
   Otherwise the method should return 'null'.
   CursorHitTest() is invoked automatically by the framework, so you never should 
   need to invoke it directly. This method is predetermined for the hit-test only. 
   The proper processing of events should take place in the @HandleEvent() method 
   by reacting to Core::CursorEvent and Core::DragEvent events. */
CoreCursorHit CoreView_CursorHitTest( CoreView _this, XRect aArea, XInt32 aFinger, 
  XInt32 aStrikeCount, CoreView aDedicatedView, XSet aRetargetReason )
{
  /* Dummy expressions to avoid the 'C' warning 'unused argument'. */
  EW_UNUSED_ARG( _this );
  EW_UNUSED_ARG( aRetargetReason );
  EW_UNUSED_ARG( aDedicatedView );
  EW_UNUSED_ARG( aStrikeCount );
  EW_UNUSED_ARG( aFinger );
  EW_UNUSED_ARG( aArea );

  return 0;
}

/* Wrapper function for the virtual method : 'Core::View.CursorHitTest()' */
CoreCursorHit CoreView__CursorHitTest( void* _this, XRect aArea, XInt32 aFinger, 
  XInt32 aStrikeCount, CoreView aDedicatedView, XSet aRetargetReason )
{
  return ((CoreView)_this)->_VMT->CursorHitTest((CoreView)_this, aArea, aFinger, 
  aStrikeCount, aDedicatedView, aRetargetReason );
}

/* The method ArrangeView() is invoked automatically if the superior @Owner group 
   needs to re-arrange its views. For example, the changing of the owners size can 
   cause the enclosed views to adapt their position and size, so all views still 
   fit within the new owners area. This method provides the core functionality for 
   the automatic GUI layout mechanism.
   The arrangement is controlled primarily by the @Layout property of the view. 
   It specifies a set of alignment constraints and determines whether the view can 
   change its size. The bounds area where the view should be arranged, is passed 
   in the parameter aBounds. This is usually the current area of the views owner.
   The parameter aFormation defines the desired arrangement mode. Depending on the 
   value of this parameter, the views can be arranged in rows or columns. If aFormation 
   == Core::Formation.None, no automatic row/column arrangement is performed and 
   the view is moved and scaled only to fit inside the aBounds area.
   ArrangeView() is invoked automatically by the framework, so you never should 
   need to invoke it directly.
   The method returns the size of the view after it has been arranged. */
XPoint CoreView_ArrangeView( CoreView _this, XRect aBounds, XEnum aFormation )
{
  /* Dummy expressions to avoid the 'C' warning 'unused argument'. */
  EW_UNUSED_ARG( _this );
  EW_UNUSED_ARG( aFormation );
  EW_UNUSED_ARG( aBounds );

  return _Const0000;
}

/* Wrapper function for the virtual method : 'Core::View.ArrangeView()' */
XPoint CoreView__ArrangeView( void* _this, XRect aBounds, XEnum aFormation )
{
  return ((CoreView)_this)->_VMT->ArrangeView((CoreView)_this, aBounds, aFormation );
}

/* The method MoveView() changes the position of the view by adding the value aOffset 
   to all corners of the view. For example, in case of a line view the value is 
   added to the both line end points.
   The parameter aFastMove serves for the optimization purpose. If it is 'true', 
   the corners are modified without performing any updates of the view and without 
   redrawing the screen. This is useful, when you wish to move or arrange a lot 
   of views at once. In this case it's up to you to request the finally screen update. 
   To do this you can use the method InvalidateArea() of the views @Owner.
   In the case aFastMove == false, the operation automatically requests the screen 
   redraw of the view areas before and after the movement. You don't need to take 
   care about it. */
void CoreView_MoveView( CoreView _this, XPoint aOffset, XBool aFastMove )
{
  /* Dummy expressions to avoid the 'C' warning 'unused argument'. */
  EW_UNUSED_ARG( _this );
  EW_UNUSED_ARG( aFastMove );
  EW_UNUSED_ARG( aOffset );
}

/* Wrapper function for the virtual method : 'Core::View.MoveView()' */
void CoreView__MoveView( void* _this, XPoint aOffset, XBool aFastMove )
{
  ((CoreView)_this)->_VMT->MoveView((CoreView)_this, aOffset, aFastMove );
}

/* The method GetExtent() returns the position and the size of the view relative 
   to the origin of its @Owner. In case of views with a non rectangular shape the 
   method returns the rectangular boundary area enclosing the entire shape. */
XRect CoreView_GetExtent( CoreView _this )
{
  /* Dummy expressions to avoid the 'C' warning 'unused argument'. */
  EW_UNUSED_ARG( _this );

  return _Const0001;
}

/* Wrapper function for the virtual method : 'Core::View.GetExtent()' */
XRect CoreView__GetExtent( void* _this )
{
  return ((CoreView)_this)->_VMT->GetExtent((CoreView)_this );
}

/* The method ChangeViewState() modifies the current state of the view. The state 
   is a set of switches determining whether a view is visible, whether it can react 
   to user inputs or whether it is just performing some update operations, etc.
   The modification is controlled by the the both parameters. The first aSetState 
   contains the switches to activate within the view state. The second aClearState 
   determines all switches to disable.
   Depending on the state alteration the method will perform different operations, 
   e.g. in response to the clearing of the visible state, the method will request 
   a screen redraw to make disappear the view from the screen.
   ChangeViewState() is invoked automatically by the framework, so you never should 
   need to invoke it directly. All relevant states are available as properties e.g. 
   the property Visible in derived classes reflects the visible state of the view. */
void CoreView_ChangeViewState( CoreView _this, XSet aSetState, XSet aClearState )
{
  XSet newState;
  XSet deltaState;

  if ((( _this->viewState & CoreViewStateIsOutline ) == CoreViewStateIsOutline ))
    aSetState = aSetState & ~CoreViewStateEmbedded;

  newState = ( _this->viewState & ~aClearState ) | aSetState;
  deltaState = newState ^ _this->viewState;
  _this->viewState = newState;

  if (( _this->Owner != 0 ) && !!( deltaState & ( CoreViewStateEnabled | CoreViewStateFocusable 
      )))
  {
    XBool focusable = (( _this->viewState & ( CoreViewStateEnabled | CoreViewStateFocusable 
      )) == ( CoreViewStateEnabled | CoreViewStateFocusable ));

    if ( focusable && ( _this->Owner->Focus == 0 ))
      CoreGroup__OnSetFocus( _this->Owner, _this );

    if ( !focusable && ( _this->Owner->Focus == _this ))
      CoreGroup__OnSetFocus( _this->Owner, CoreGroup_FindSiblingView( _this->Owner, 
      _this, CoreViewStateEnabled | CoreViewStateFocusable ));
  }

  if (( _this->Owner != 0 ) && !!( deltaState & ( CoreViewStateAlphaBlended | CoreViewStateEmbedded 
      | CoreViewStateVisible )))
    CoreGroup__InvalidateArea( _this->Owner, CoreView__GetExtent( _this ));

  if ((( _this->layoutContext != 0 ) && (( newState & CoreViewStateEmbedded ) == 
      CoreViewStateEmbedded )) && (( deltaState & CoreViewStateVisible ) == CoreViewStateVisible 
      ))
  {
    _this->viewState = _this->viewState | CoreViewStateRequestLayout;
    _this->Owner->Super2.viewState = _this->Owner->Super2.viewState | CoreViewStatePendingLayout;
    EwPostSignal( EwNewSlot( _this->Owner, CoreGroup_updateComponent ), ((XObject)_this 
      ));
  }

  if (( _this->Owner != 0 ) && (( deltaState & CoreViewStateEmbedded ) == CoreViewStateEmbedded 
      ))
  {
    _this->layoutContext = 0;
    _this->viewState = _this->viewState | CoreViewStateRequestLayout;
    _this->Owner->Super2.viewState = _this->Owner->Super2.viewState | CoreViewStatePendingLayout;
    EwPostSignal( EwNewSlot( _this->Owner, CoreGroup_updateComponent ), ((XObject)_this 
      ));
  }
}

/* Wrapper function for the virtual method : 'Core::View.ChangeViewState()' */
void CoreView__ChangeViewState( void* _this, XSet aSetState, XSet aClearState )
{
  ((CoreView)_this)->_VMT->ChangeViewState((CoreView)_this, aSetState, aClearState );
}

/* Variants derived from the class : 'Core::View' */
EW_DEFINE_CLASS_VARIANTS( CoreView )
EW_END_OF_CLASS_VARIANTS( CoreView )

/* Virtual Method Table (VMT) for the class : 'Core::View' */
EW_DEFINE_CLASS( CoreView, XObject, "Core::View" )
  CoreView_initLayoutContext,
  CoreView_GetRoot,
  CoreView_Draw,
  CoreView_HandleEvent,
  CoreView_CursorHitTest,
  CoreView_ArrangeView,
  CoreView_MoveView,
  CoreView_GetExtent,
  CoreView_ChangeViewState,
EW_END_OF_CLASS( CoreView )

/* Initializer for the class 'Core::LineView' */
void CoreLineView__Init( CoreLineView _this, XObject aLink, XHandle aArg )
{
  /* At first initialize the super class ... */
  CoreView__Init( &_this->_Super, aLink, aArg );

  /* Setup the VMT pointer */
  _this->_VMT = EW_CLASS( CoreLineView );

  /* ... and initialize objects, variables, properties, etc. */
}

/* Re-Initializer for the class 'Core::LineView' */
void CoreLineView__ReInit( CoreLineView _this )
{
  /* At first re-initialize the super class ... */
  CoreView__ReInit( &_this->_Super );
}

/* Finalizer method for the class 'Core::LineView' */
void CoreLineView__Done( CoreLineView _this )
{
  /* Finalize this class */
  _this->_VMT = EW_CLASS( CoreLineView );

  /* Don't forget to deinitialize the super class ... */
  CoreView__Done( &_this->_Super );
}

/* Garbage Collector method for the class 'Core::LineView' */
void CoreLineView__Mark( CoreLineView _this )
{
  /* Give the super class a chance to mark its objects and references */
  CoreView__Mark( &_this->_Super );
}

/* 'C' function for method : 'Core::LineView.initLayoutContext()' */
void CoreLineView_initLayoutContext( CoreLineView _this, XRect aBounds, CoreOutline 
  aOutline )
{
  CoreLayoutLineContext context = EwNewObject( CoreLayoutLineContext, 0 );

  _this->Super1.layoutContext = 0;
  context->Super1.extent = CoreLineView_getExtent( _this );
  context->Super1.bounds = aBounds;
  context->Super1.outline = aOutline;
  context->point1 = _this->Point1;
  context->point2 = _this->Point2;
  _this->Super1.layoutContext = ((CoreLayoutContext)context );
}

/* The method ArrangeView() is invoked automatically if the superior @Owner group 
   needs to re-arrange its views. For example, the changing of the owners size can 
   cause the enclosed views to adapt their position and size, so all views still 
   fit within the new owners area. This method provides the core functionality for 
   the automatic GUI layout mechanism.
   The arrangement is controlled primarily by the @Layout property of the view. 
   It specifies a set of alignment constraints and determines whether the view can 
   change its size. The bounds area where the view should be arranged, is passed 
   in the parameter aBounds. This is usually the current area of the views owner.
   The parameter aFormation defines the desired arrangement mode. Depending on the 
   value of this parameter, the views can be arranged in rows or columns. If aFormation 
   == Core::Formation.None, no automatic row/column arrangement is performed and 
   the view is moved and scaled only to fit inside the aBounds area.
   ArrangeView() is invoked automatically by the framework, so you never should 
   need to invoke it directly.
   The method returns the size of the view after it has been arranged. */
XPoint CoreLineView_ArrangeView( CoreLineView _this, XRect aBounds, XEnum aFormation )
{
  XSet layout = _this->Super1.Layout;
  CoreLayoutLineContext context = EwCastObject( _this->Super1.layoutContext, CoreLayoutLineContext 
    );
  XInt32 x1 = context->Super1.extent.Point1.X;
  XInt32 y1 = context->Super1.extent.Point1.Y;
  XInt32 x2 = context->Super1.extent.Point2.X;
  XInt32 y2 = context->Super1.extent.Point2.Y;
  XPoint dstSize = EwGetRectSize( aBounds );
  XInt32 w = x2 - x1;
  XInt32 h = y2 - y1;
  XInt32 tmp;

  if ( aFormation == CoreFormationNone )
  {
    XPoint srcSize = EwGetRectSize( context->Super1.bounds );
    x1 = x1 - context->Super1.bounds.Point1.X;
    y1 = y1 - context->Super1.bounds.Point1.Y;

    if ( srcSize.X != dstSize.X )
    {
      XBool alignToLeft = (( layout & CoreLayoutAlignToLeft ) == CoreLayoutAlignToLeft 
        );
      XBool alignToRight = (( layout & CoreLayoutAlignToRight ) == CoreLayoutAlignToRight 
        );
      XBool resizeHorz = (( layout & CoreLayoutResizeHorz ) == CoreLayoutResizeHorz 
        );

      if ( !alignToLeft && ( resizeHorz || !alignToRight ))
        x1 = ( x1 * dstSize.X ) / srcSize.X;

      if ( !alignToRight && ( resizeHorz || !alignToLeft ))
      {
        x2 = x2 - context->Super1.bounds.Point1.X;
        x2 = ( x2 * dstSize.X ) / srcSize.X;
        x2 = x2 - dstSize.X;
      }
      else
        x2 = x2 - context->Super1.bounds.Point2.X;

      x1 = x1 + aBounds.Point1.X;
      x2 = x2 + aBounds.Point2.X;

      if ( !resizeHorz )
      {
        if ( alignToLeft && !alignToRight )
          x2 = x1 + w;
        else
          if ( !alignToLeft && alignToRight )
            x1 = x2 - w;
          else
          {
            x1 = x1 + ((( x2 - x1 ) - w ) / 2 );
            x2 = x1 + w;
          }
      }
    }
    else
    {
      x2 = x2 - context->Super1.bounds.Point2.X;
      x1 = x1 + aBounds.Point1.X;
      x2 = x2 + aBounds.Point2.X;
    }

    if ( srcSize.Y != dstSize.Y )
    {
      XBool alignToTop = (( layout & CoreLayoutAlignToTop ) == CoreLayoutAlignToTop 
        );
      XBool alignToBottom = (( layout & CoreLayoutAlignToBottom ) == CoreLayoutAlignToBottom 
        );
      XBool resizeVert = (( layout & CoreLayoutResizeVert ) == CoreLayoutResizeVert 
        );

      if ( !alignToTop && ( resizeVert || !alignToBottom ))
        y1 = ( y1 * dstSize.Y ) / srcSize.Y;

      if ( !alignToBottom && ( resizeVert || !alignToTop ))
      {
        y2 = y2 - context->Super1.bounds.Point1.Y;
        y2 = ( y2 * dstSize.Y ) / srcSize.Y;
        y2 = y2 - dstSize.Y;
      }
      else
        y2 = y2 - context->Super1.bounds.Point2.Y;

      y1 = y1 + aBounds.Point1.Y;
      y2 = y2 + aBounds.Point2.Y;

      if ( !resizeVert )
      {
        if ( alignToTop && !alignToBottom )
          y2 = y1 + h;
        else
          if ( !alignToTop && alignToBottom )
            y1 = y2 - h;
          else
          {
            y1 = y1 + ((( y2 - y1 ) - h ) / 2 );
            y2 = y1 + h;
          }
      }
    }
    else
    {
      y2 = y2 - context->Super1.bounds.Point2.Y;
      y1 = y1 + aBounds.Point1.Y;
      y2 = y2 + aBounds.Point2.Y;
    }
  }
  else
  {
    switch ( aFormation )
    {
      case CoreFormationLeftToRight :
      {
        x1 = aBounds.Point1.X;
        x2 = x1 + w;
      }
      break;

      case CoreFormationRightToLeft :
      {
        x2 = aBounds.Point2.X;
        x1 = x2 - w;
      }
      break;

      case CoreFormationTopToBottom :
      {
        y1 = aBounds.Point1.Y;
        y2 = y1 + h;
      }
      break;

      case CoreFormationBottomToTop :
      {
        y2 = aBounds.Point2.Y;
        y1 = y2 - h;
      }
      break;

      default : 
        ;
    }

    if (( aFormation == CoreFormationLeftToRight ) || ( aFormation == CoreFormationRightToLeft 
        ))
    {
      XBool alignToTop = (( layout & CoreLayoutAlignToTop ) == CoreLayoutAlignToTop 
        );
      XBool alignToBottom = (( layout & CoreLayoutAlignToBottom ) == CoreLayoutAlignToBottom 
        );
      XBool resizeVert = (( layout & CoreLayoutResizeVert ) == CoreLayoutResizeVert 
        );

      if ( resizeVert )
      {
        y1 = aBounds.Point1.Y;
        y2 = aBounds.Point2.Y;
      }
      else
        if ( alignToTop && !alignToBottom )
        {
          y1 = aBounds.Point1.Y;
          y2 = y1 + h;
        }
        else
          if ( alignToBottom && !alignToTop )
          {
            y2 = aBounds.Point2.Y;
            y1 = y2 - h;
          }
          else
          {
            y1 = aBounds.Point1.Y + (( EwGetRectH( aBounds ) - h ) / 2 );
            y2 = y1 + h;
          }
    }

    if (( aFormation == CoreFormationTopToBottom ) || ( aFormation == CoreFormationBottomToTop 
        ))
    {
      XBool alignToLeft = (( layout & CoreLayoutAlignToLeft ) == CoreLayoutAlignToLeft 
        );
      XBool alignToRight = (( layout & CoreLayoutAlignToRight ) == CoreLayoutAlignToRight 
        );
      XBool resizeHorz = (( layout & CoreLayoutResizeHorz ) == CoreLayoutResizeHorz 
        );

      if ( resizeHorz )
      {
        x1 = aBounds.Point1.X;
        x2 = aBounds.Point2.X;
      }
      else
        if ( alignToLeft && !alignToRight )
        {
          x1 = aBounds.Point1.X;
          x2 = x1 + w;
        }
        else
          if ( alignToRight && !alignToLeft )
          {
            x2 = aBounds.Point2.X;
            x1 = x2 - w;
          }
          else
          {
            x1 = aBounds.Point1.X + (( EwGetRectW( aBounds ) - w ) / 2 );
            x2 = x1 + w;
          }
    }
  }

  context->Super1.isEmpty = (XBool)(( x1 >= x2 ) || ( y1 >= y2 ));
  w = x2 - x1;
  h = y2 - y1;

  if ( context->point2.X < context->point1.X )
  {
    tmp = x1;
    x1 = x2 - 1;
    x2 = tmp - 1;
  }

  if ( context->point2.Y < context->point1.Y )
  {
    tmp = y1;
    y1 = y2 - 1;
    y2 = tmp - 1;
  }

  if (( x2 - x1 ) == 1 )
    x2 = x1;

  if (( y2 - y1 ) == 1 )
    y2 = y1;

  if ((( _this->Super1.viewState & CoreViewStateFastReshape ) == CoreViewStateFastReshape 
      ))
  {
    _this->Point1 = EwNewPoint( x1, y1 );
    _this->Point2 = EwNewPoint( x2, y2 );
  }
  else
  {
    CoreLineView_OnSetPoint1( _this, EwNewPoint( x1, y1 ));
    CoreLineView_OnSetPoint2( _this, EwNewPoint( x2, y2 ));
    _this->Super1.layoutContext = ((CoreLayoutContext)context );
  }

  return EwNewPoint( w, h );
}

/* The method MoveView() changes the position of the view by adding the value aOffset 
   to all corners of the view. For example, in case of a line view the value is 
   added to the both line end points.
   The parameter aFastMove serves for the optimization purpose. If it is 'true', 
   the corners are modified without performing any updates of the view and without 
   redrawing the screen. This is useful, when you wish to move or arrange a lot 
   of views at once. In this case it's up to you to request the finally screen update. 
   To do this you can use the method InvalidateArea() of the views @Owner.
   In the case aFastMove == false, the operation automatically requests the screen 
   redraw of the view areas before and after the movement. You don't need to take 
   care about it. */
void CoreLineView_MoveView( CoreLineView _this, XPoint aOffset, XBool aFastMove )
{
  if ( aFastMove )
  {
    _this->Point1 = EwMovePointPos( _this->Point1, aOffset );
    _this->Point2 = EwMovePointPos( _this->Point2, aOffset );
  }
  else
  {
    CoreLineView_OnSetPoint1( _this, EwMovePointPos( _this->Point1, aOffset ));
    CoreLineView_OnSetPoint2( _this, EwMovePointPos( _this->Point2, aOffset ));
  }
}

/* The method GetExtent() returns the position and the size of the view relative 
   to the origin of its @Owner. In case of views with a non rectangular shape the 
   method returns the rectangular boundary area enclosing the entire shape. */
XRect CoreLineView_GetExtent( CoreLineView _this )
{
  if (( _this->Super1.layoutContext != 0 ) && _this->Super1.layoutContext->isEmpty )
    return _Const0001;

  return CoreLineView_getExtent( _this );
}

/* 'C' function for method : 'Core::LineView.getExtent()' */
XRect CoreLineView_getExtent( CoreLineView _this )
{
  XInt32 x1 = _this->Point1.X;
  XInt32 y1 = _this->Point1.Y;
  XInt32 x2 = _this->Point2.X;
  XInt32 y2 = _this->Point2.Y;
  XInt32 w = x2 - x1;
  XInt32 h = y2 - y1;
  XInt32 tmp;

  if ( w < 0 )
    w = -w;

  if ( h < 0 )
    h = -h;

  if ( w >= h )
  {
    if ( x2 > x1 )
      x2 = x2 - 1;

    if ( x2 < x1 )
      x2 = x2 + 1;
  }

  if ( h >= w )
  {
    if ( y2 > y1 )
      y2 = y2 - 1;

    if ( y2 < y1 )
      y2 = y2 + 1;
  }

  if ( x2 < x1 )
  {
    tmp = x1;
    x1 = x2;
    x2 = tmp;
  }

  if ( y2 < y1 )
  {
    tmp = y1;
    y1 = y2;
    y2 = tmp;
  }

  return EwNewRect( x1, y1, x2 + 1, y2 + 1 );
}

/* Wrapper function for the non virtual method : 'Core::LineView.getExtent()' */
XRect CoreLineView__getExtent( void* _this )
{
  return CoreLineView_getExtent((CoreLineView)_this );
}

/* 'C' function for method : 'Core::LineView.OnSetPoint2()' */
void CoreLineView_OnSetPoint2( CoreLineView _this, XPoint value )
{
  if ( !EwCompPoint( value, _this->Point2 ))
    return;

  if (( _this->Super1.Owner != 0 ) && (( _this->Super1.viewState & CoreViewStateVisible 
      ) == CoreViewStateVisible ))
    CoreGroup__InvalidateArea( _this->Super1.Owner, CoreView__GetExtent( _this ));

  _this->Super1.layoutContext = 0;
  _this->Point2 = value;

  if (( _this->Super1.Owner != 0 ) && (( _this->Super1.viewState & CoreViewStateVisible 
      ) == CoreViewStateVisible ))
    CoreGroup__InvalidateArea( _this->Super1.Owner, CoreView__GetExtent( _this ));

  if ((( _this->Super1.Owner != 0 ) && (( _this->Super1.viewState & CoreViewStateEmbedded 
      ) == CoreViewStateEmbedded )) && !(( _this->Super1.Owner->Super2.viewState 
      & CoreViewStateUpdatingLayout ) == CoreViewStateUpdatingLayout ))
  {
    _this->Super1.viewState = _this->Super1.viewState | CoreViewStateRequestLayout;
    _this->Super1.Owner->Super2.viewState = _this->Super1.Owner->Super2.viewState 
    | CoreViewStatePendingLayout;
    EwPostSignal( EwNewSlot( _this->Super1.Owner, CoreGroup_updateComponent ), ((XObject)_this 
      ));
  }
}

/* 'C' function for method : 'Core::LineView.OnSetPoint1()' */
void CoreLineView_OnSetPoint1( CoreLineView _this, XPoint value )
{
  if ( !EwCompPoint( value, _this->Point1 ))
    return;

  if (( _this->Super1.Owner != 0 ) && (( _this->Super1.viewState & CoreViewStateVisible 
      ) == CoreViewStateVisible ))
    CoreGroup__InvalidateArea( _this->Super1.Owner, CoreView__GetExtent( _this ));

  _this->Super1.layoutContext = 0;
  _this->Point1 = value;

  if (( _this->Super1.Owner != 0 ) && (( _this->Super1.viewState & CoreViewStateVisible 
      ) == CoreViewStateVisible ))
    CoreGroup__InvalidateArea( _this->Super1.Owner, CoreView__GetExtent( _this ));

  if ((( _this->Super1.Owner != 0 ) && (( _this->Super1.viewState & CoreViewStateEmbedded 
      ) == CoreViewStateEmbedded )) && !(( _this->Super1.Owner->Super2.viewState 
      & CoreViewStateUpdatingLayout ) == CoreViewStateUpdatingLayout ))
  {
    _this->Super1.viewState = _this->Super1.viewState | CoreViewStateRequestLayout;
    _this->Super1.Owner->Super2.viewState = _this->Super1.Owner->Super2.viewState 
    | CoreViewStatePendingLayout;
    EwPostSignal( EwNewSlot( _this->Super1.Owner, CoreGroup_updateComponent ), ((XObject)_this 
      ));
  }
}

/* Variants derived from the class : 'Core::LineView' */
EW_DEFINE_CLASS_VARIANTS( CoreLineView )
EW_END_OF_CLASS_VARIANTS( CoreLineView )

/* Virtual Method Table (VMT) for the class : 'Core::LineView' */
EW_DEFINE_CLASS( CoreLineView, CoreView, "Core::LineView" )
  CoreLineView_initLayoutContext,
  CoreView_GetRoot,
  CoreView_Draw,
  CoreView_HandleEvent,
  CoreView_CursorHitTest,
  CoreLineView_ArrangeView,
  CoreLineView_MoveView,
  CoreLineView_GetExtent,
  CoreView_ChangeViewState,
EW_END_OF_CLASS( CoreLineView )

/* Initializer for the class 'Core::QuadView' */
void CoreQuadView__Init( CoreQuadView _this, XObject aLink, XHandle aArg )
{
  /* At first initialize the super class ... */
  CoreView__Init( &_this->_Super, aLink, aArg );

  /* Setup the VMT pointer */
  _this->_VMT = EW_CLASS( CoreQuadView );

  /* ... and initialize objects, variables, properties, etc. */
}

/* Re-Initializer for the class 'Core::QuadView' */
void CoreQuadView__ReInit( CoreQuadView _this )
{
  /* At first re-initialize the super class ... */
  CoreView__ReInit( &_this->_Super );
}

/* Finalizer method for the class 'Core::QuadView' */
void CoreQuadView__Done( CoreQuadView _this )
{
  /* Finalize this class */
  _this->_VMT = EW_CLASS( CoreQuadView );

  /* Don't forget to deinitialize the super class ... */
  CoreView__Done( &_this->_Super );
}

/* Garbage Collector method for the class 'Core::QuadView' */
void CoreQuadView__Mark( CoreQuadView _this )
{
  /* Give the super class a chance to mark its objects and references */
  CoreView__Mark( &_this->_Super );
}

/* 'C' function for method : 'Core::QuadView.initLayoutContext()' */
void CoreQuadView_initLayoutContext( CoreQuadView _this, XRect aBounds, CoreOutline 
  aOutline )
{
  CoreLayoutQuadContext context = EwNewObject( CoreLayoutQuadContext, 0 );

  _this->Super1.layoutContext = 0;
  context->Super1.extent = CoreView__GetExtent( _this );
  context->Super1.bounds = aBounds;
  context->Super1.outline = aOutline;
  context->point1 = _this->Point1;
  context->point2 = _this->Point2;
  context->point3 = _this->Point3;
  context->point4 = _this->Point4;
  _this->Super1.layoutContext = ((CoreLayoutContext)context );
}

/* The method ArrangeView() is invoked automatically if the superior @Owner group 
   needs to re-arrange its views. For example, the changing of the owners size can 
   cause the enclosed views to adapt their position and size, so all views still 
   fit within the new owners area. This method provides the core functionality for 
   the automatic GUI layout mechanism.
   The arrangement is controlled primarily by the @Layout property of the view. 
   It specifies a set of alignment constraints and determines whether the view can 
   change its size. The bounds area where the view should be arranged, is passed 
   in the parameter aBounds. This is usually the current area of the views owner.
   The parameter aFormation defines the desired arrangement mode. Depending on the 
   value of this parameter, the views can be arranged in rows or columns. If aFormation 
   == Core::Formation.None, no automatic row/column arrangement is performed and 
   the view is moved and scaled only to fit inside the aBounds area.
   ArrangeView() is invoked automatically by the framework, so you never should 
   need to invoke it directly.
   The method returns the size of the view after it has been arranged. */
XPoint CoreQuadView_ArrangeView( CoreQuadView _this, XRect aBounds, XEnum aFormation )
{
  XSet layout = _this->Super1.Layout;
  CoreLayoutQuadContext context = EwCastObject( _this->Super1.layoutContext, CoreLayoutQuadContext 
    );
  XInt32 x1 = context->Super1.extent.Point1.X;
  XInt32 y1 = context->Super1.extent.Point1.Y;
  XInt32 x2 = context->Super1.extent.Point2.X;
  XInt32 y2 = context->Super1.extent.Point2.Y;
  XPoint dstSize = EwGetRectSize( aBounds );
  XInt32 w = x2 - x1;
  XInt32 h = y2 - y1;
  XInt32 ex;
  XInt32 ey;
  XInt32 ew;
  XInt32 eh;

  if ( aFormation == CoreFormationNone )
  {
    XPoint srcSize = EwGetRectSize( context->Super1.bounds );
    x1 = x1 - context->Super1.bounds.Point1.X;
    y1 = y1 - context->Super1.bounds.Point1.Y;

    if ( srcSize.X != dstSize.X )
    {
      XBool alignToLeft = (( layout & CoreLayoutAlignToLeft ) == CoreLayoutAlignToLeft 
        );
      XBool alignToRight = (( layout & CoreLayoutAlignToRight ) == CoreLayoutAlignToRight 
        );
      XBool resizeHorz = (( layout & CoreLayoutResizeHorz ) == CoreLayoutResizeHorz 
        );

      if ( !alignToLeft && ( resizeHorz || !alignToRight ))
        x1 = ( x1 * dstSize.X ) / srcSize.X;

      if ( !alignToRight && ( resizeHorz || !alignToLeft ))
      {
        x2 = x2 - context->Super1.bounds.Point1.X;
        x2 = ( x2 * dstSize.X ) / srcSize.X;
        x2 = x2 - dstSize.X;
      }
      else
        x2 = x2 - context->Super1.bounds.Point2.X;

      x1 = x1 + aBounds.Point1.X;
      x2 = x2 + aBounds.Point2.X;

      if ( !resizeHorz )
      {
        if ( alignToLeft && !alignToRight )
          x2 = x1 + w;
        else
          if ( !alignToLeft && alignToRight )
            x1 = x2 - w;
          else
          {
            x1 = x1 + ((( x2 - x1 ) - w ) / 2 );
            x2 = x1 + w;
          }
      }
    }
    else
    {
      x2 = x2 - context->Super1.bounds.Point2.X;
      x1 = x1 + aBounds.Point1.X;
      x2 = x2 + aBounds.Point2.X;
    }

    if ( srcSize.Y != dstSize.Y )
    {
      XBool alignToTop = (( layout & CoreLayoutAlignToTop ) == CoreLayoutAlignToTop 
        );
      XBool alignToBottom = (( layout & CoreLayoutAlignToBottom ) == CoreLayoutAlignToBottom 
        );
      XBool resizeVert = (( layout & CoreLayoutResizeVert ) == CoreLayoutResizeVert 
        );

      if ( !alignToTop && ( resizeVert || !alignToBottom ))
        y1 = ( y1 * dstSize.Y ) / srcSize.Y;

      if ( !alignToBottom && ( resizeVert || !alignToTop ))
      {
        y2 = y2 - context->Super1.bounds.Point1.Y;
        y2 = ( y2 * dstSize.Y ) / srcSize.Y;
        y2 = y2 - dstSize.Y;
      }
      else
        y2 = y2 - context->Super1.bounds.Point2.Y;

      y1 = y1 + aBounds.Point1.Y;
      y2 = y2 + aBounds.Point2.Y;

      if ( !resizeVert )
      {
        if ( alignToTop && !alignToBottom )
          y2 = y1 + h;
        else
          if ( !alignToTop && alignToBottom )
            y1 = y2 - h;
          else
          {
            y1 = y1 + ((( y2 - y1 ) - h ) / 2 );
            y2 = y1 + h;
          }
      }
    }
    else
    {
      y2 = y2 - context->Super1.bounds.Point2.Y;
      y1 = y1 + aBounds.Point1.Y;
      y2 = y2 + aBounds.Point2.Y;
    }
  }
  else
  {
    switch ( aFormation )
    {
      case CoreFormationLeftToRight :
      {
        x1 = aBounds.Point1.X;
        x2 = x1 + w;
      }
      break;

      case CoreFormationRightToLeft :
      {
        x2 = aBounds.Point2.X;
        x1 = x2 - w;
      }
      break;

      case CoreFormationTopToBottom :
      {
        y1 = aBounds.Point1.Y;
        y2 = y1 + h;
      }
      break;

      case CoreFormationBottomToTop :
      {
        y2 = aBounds.Point2.Y;
        y1 = y2 - h;
      }
      break;

      default : 
        ;
    }

    if (( aFormation == CoreFormationLeftToRight ) || ( aFormation == CoreFormationRightToLeft 
        ))
    {
      XBool alignToTop = (( layout & CoreLayoutAlignToTop ) == CoreLayoutAlignToTop 
        );
      XBool alignToBottom = (( layout & CoreLayoutAlignToBottom ) == CoreLayoutAlignToBottom 
        );
      XBool resizeVert = (( layout & CoreLayoutResizeVert ) == CoreLayoutResizeVert 
        );

      if ( resizeVert )
      {
        y1 = aBounds.Point1.Y;
        y2 = aBounds.Point2.Y;
      }
      else
        if ( alignToTop && !alignToBottom )
        {
          y1 = aBounds.Point1.Y;
          y2 = y1 + h;
        }
        else
          if ( alignToBottom && !alignToTop )
          {
            y2 = aBounds.Point2.Y;
            y1 = y2 - h;
          }
          else
          {
            y1 = aBounds.Point1.Y + (( EwGetRectH( aBounds ) - h ) / 2 );
            y2 = y1 + h;
          }
    }

    if (( aFormation == CoreFormationTopToBottom ) || ( aFormation == CoreFormationBottomToTop 
        ))
    {
      XBool alignToLeft = (( layout & CoreLayoutAlignToLeft ) == CoreLayoutAlignToLeft 
        );
      XBool alignToRight = (( layout & CoreLayoutAlignToRight ) == CoreLayoutAlignToRight 
        );
      XBool resizeHorz = (( layout & CoreLayoutResizeHorz ) == CoreLayoutResizeHorz 
        );

      if ( resizeHorz )
      {
        x1 = aBounds.Point1.X;
        x2 = aBounds.Point2.X;
      }
      else
        if ( alignToLeft && !alignToRight )
        {
          x1 = aBounds.Point1.X;
          x2 = x1 + w;
        }
        else
          if ( alignToRight && !alignToLeft )
          {
            x2 = aBounds.Point2.X;
            x1 = x2 - w;
          }
          else
          {
            x1 = aBounds.Point1.X + (( EwGetRectW( aBounds ) - w ) / 2 );
            x2 = x1 + w;
          }
    }
  }

  context->Super1.isEmpty = (XBool)(( x1 >= x2 ) || ( y1 >= y2 ));
  w = ( x2 - x1 ) - 1;
  h = ( y2 - y1 ) - 1;
  ex = context->Super1.extent.Point1.X;
  ey = context->Super1.extent.Point1.Y;
  ew = ( context->Super1.extent.Point2.X - ex ) - 1;
  eh = ( context->Super1.extent.Point2.Y - ey ) - 1;

  if ( ew == 0 )
    ew = 1;

  if ( eh == 0 )
    eh = 1;

  if ((( _this->Super1.viewState & CoreViewStateFastReshape ) == CoreViewStateFastReshape 
      ))
  {
    _this->Point1 = EwNewPoint( x1 + ((( context->point1.X - ex ) * w ) / ew ), 
    y1 + ((( context->point1.Y - ey ) * h ) / eh ));
    _this->Point2 = EwNewPoint( x1 + ((( context->point2.X - ex ) * w ) / ew ), 
    y1 + ((( context->point2.Y - ey ) * h ) / eh ));
    _this->Point3 = EwNewPoint( x1 + ((( context->point3.X - ex ) * w ) / ew ), 
    y1 + ((( context->point3.Y - ey ) * h ) / eh ));
    _this->Point4 = EwNewPoint( x1 + ((( context->point4.X - ex ) * w ) / ew ), 
    y1 + ((( context->point4.Y - ey ) * h ) / eh ));
  }
  else
  {
    CoreQuadView__OnSetPoint1( _this, EwNewPoint( x1 + ((( context->point1.X - ex 
    ) * w ) / ew ), y1 + ((( context->point1.Y - ey ) * h ) / eh )));
    CoreQuadView__OnSetPoint2( _this, EwNewPoint( x1 + ((( context->point2.X - ex 
    ) * w ) / ew ), y1 + ((( context->point2.Y - ey ) * h ) / eh )));
    CoreQuadView__OnSetPoint3( _this, EwNewPoint( x1 + ((( context->point3.X - ex 
    ) * w ) / ew ), y1 + ((( context->point3.Y - ey ) * h ) / eh )));
    CoreQuadView__OnSetPoint4( _this, EwNewPoint( x1 + ((( context->point4.X - ex 
    ) * w ) / ew ), y1 + ((( context->point4.Y - ey ) * h ) / eh )));
    _this->Super1.layoutContext = ((CoreLayoutContext)context );
  }

  return EwNewPoint( w + 1, h + 1 );
}

/* The method MoveView() changes the position of the view by adding the value aOffset 
   to all corners of the view. For example, in case of a line view the value is 
   added to the both line end points.
   The parameter aFastMove serves for the optimization purpose. If it is 'true', 
   the corners are modified without performing any updates of the view and without 
   redrawing the screen. This is useful, when you wish to move or arrange a lot 
   of views at once. In this case it's up to you to request the finally screen update. 
   To do this you can use the method InvalidateArea() of the views @Owner.
   In the case aFastMove == false, the operation automatically requests the screen 
   redraw of the view areas before and after the movement. You don't need to take 
   care about it. */
void CoreQuadView_MoveView( CoreQuadView _this, XPoint aOffset, XBool aFastMove )
{
  if ( aFastMove )
  {
    _this->Point1 = EwMovePointPos( _this->Point1, aOffset );
    _this->Point2 = EwMovePointPos( _this->Point2, aOffset );
    _this->Point3 = EwMovePointPos( _this->Point3, aOffset );
    _this->Point4 = EwMovePointPos( _this->Point4, aOffset );
  }
  else
  {
    CoreQuadView__OnSetPoint1( _this, EwMovePointPos( _this->Point1, aOffset ));
    CoreQuadView__OnSetPoint2( _this, EwMovePointPos( _this->Point2, aOffset ));
    CoreQuadView__OnSetPoint3( _this, EwMovePointPos( _this->Point3, aOffset ));
    CoreQuadView__OnSetPoint4( _this, EwMovePointPos( _this->Point4, aOffset ));
  }
}

/* The method GetExtent() returns the position and the size of the view relative 
   to the origin of its @Owner. In case of views with a non rectangular shape the 
   method returns the rectangular boundary area enclosing the entire shape. */
XRect CoreQuadView_GetExtent( CoreQuadView _this )
{
  XInt32 x1;
  XInt32 y1;
  XInt32 x2;
  XInt32 y2;

  if (( _this->Super1.layoutContext != 0 ) && _this->Super1.layoutContext->isEmpty )
    return _Const0001;

  x1 = _this->Point1.X;
  y1 = _this->Point1.Y;
  x2 = _this->Point3.X;
  y2 = _this->Point3.Y;

  if (((( _this->Point4.X != x1 ) || ( _this->Point2.Y != y1 )) || ( _this->Point2.X 
      != x2 )) || ( _this->Point4.Y != y2 ))
  {
    if ( _this->Point2.X < x1 )
      x1 = _this->Point2.X;

    if ( _this->Point3.X < x1 )
      x1 = _this->Point3.X;

    if ( _this->Point4.X < x1 )
      x1 = _this->Point4.X;

    if ( _this->Point2.Y < y1 )
      y1 = _this->Point2.Y;

    if ( _this->Point3.Y < y1 )
      y1 = _this->Point3.Y;

    if ( _this->Point4.Y < y1 )
      y1 = _this->Point4.Y;

    if ( _this->Point1.X > x2 )
      x2 = _this->Point1.X;

    if ( _this->Point2.X > x2 )
      x2 = _this->Point2.X;

    if ( _this->Point4.X > x2 )
      x2 = _this->Point4.X;

    if ( _this->Point1.Y > y2 )
      y2 = _this->Point1.Y;

    if ( _this->Point2.Y > y2 )
      y2 = _this->Point2.Y;

    if ( _this->Point4.Y > y2 )
      y2 = _this->Point4.Y;
  }
  else
  {
    XInt32 tmp;

    if ( x2 < x1 )
    {
      tmp = x1;
      x1 = x2;
      x2 = tmp;
    }

    if ( y2 < y1 )
    {
      tmp = y1;
      y1 = y2;
      y2 = tmp;
    }
  }

  return EwNewRect( x1, y1, x2 + 1, y2 + 1 );
}

/* 'C' function for method : 'Core::QuadView.OnSetPoint4()' */
void CoreQuadView_OnSetPoint4( CoreQuadView _this, XPoint value )
{
  if ( !EwCompPoint( value, _this->Point4 ))
    return;

  if (( _this->Super1.Owner != 0 ) && (( _this->Super1.viewState & CoreViewStateVisible 
      ) == CoreViewStateVisible ))
    CoreGroup__InvalidateArea( _this->Super1.Owner, CoreView__GetExtent( _this ));

  _this->Super1.layoutContext = 0;
  _this->Point4 = value;

  if (( _this->Super1.Owner != 0 ) && (( _this->Super1.viewState & CoreViewStateVisible 
      ) == CoreViewStateVisible ))
    CoreGroup__InvalidateArea( _this->Super1.Owner, CoreView__GetExtent( _this ));

  if ((( _this->Super1.Owner != 0 ) && (( _this->Super1.viewState & CoreViewStateEmbedded 
      ) == CoreViewStateEmbedded )) && !(( _this->Super1.Owner->Super2.viewState 
      & CoreViewStateUpdatingLayout ) == CoreViewStateUpdatingLayout ))
  {
    _this->Super1.viewState = _this->Super1.viewState | CoreViewStateRequestLayout;
    _this->Super1.Owner->Super2.viewState = _this->Super1.Owner->Super2.viewState 
    | CoreViewStatePendingLayout;
    EwPostSignal( EwNewSlot( _this->Super1.Owner, CoreGroup_updateComponent ), ((XObject)_this 
      ));
  }
}

/* Wrapper function for the virtual method : 'Core::QuadView.OnSetPoint4()' */
void CoreQuadView__OnSetPoint4( void* _this, XPoint value )
{
  ((CoreQuadView)_this)->_VMT->OnSetPoint4((CoreQuadView)_this, value );
}

/* 'C' function for method : 'Core::QuadView.OnSetPoint3()' */
void CoreQuadView_OnSetPoint3( CoreQuadView _this, XPoint value )
{
  if ( !EwCompPoint( value, _this->Point3 ))
    return;

  if (( _this->Super1.Owner != 0 ) && (( _this->Super1.viewState & CoreViewStateVisible 
      ) == CoreViewStateVisible ))
    CoreGroup__InvalidateArea( _this->Super1.Owner, CoreView__GetExtent( _this ));

  _this->Super1.layoutContext = 0;
  _this->Point3 = value;

  if (( _this->Super1.Owner != 0 ) && (( _this->Super1.viewState & CoreViewStateVisible 
      ) == CoreViewStateVisible ))
    CoreGroup__InvalidateArea( _this->Super1.Owner, CoreView__GetExtent( _this ));

  if ((( _this->Super1.Owner != 0 ) && (( _this->Super1.viewState & CoreViewStateEmbedded 
      ) == CoreViewStateEmbedded )) && !(( _this->Super1.Owner->Super2.viewState 
      & CoreViewStateUpdatingLayout ) == CoreViewStateUpdatingLayout ))
  {
    _this->Super1.viewState = _this->Super1.viewState | CoreViewStateRequestLayout;
    _this->Super1.Owner->Super2.viewState = _this->Super1.Owner->Super2.viewState 
    | CoreViewStatePendingLayout;
    EwPostSignal( EwNewSlot( _this->Super1.Owner, CoreGroup_updateComponent ), ((XObject)_this 
      ));
  }
}

/* Wrapper function for the virtual method : 'Core::QuadView.OnSetPoint3()' */
void CoreQuadView__OnSetPoint3( void* _this, XPoint value )
{
  ((CoreQuadView)_this)->_VMT->OnSetPoint3((CoreQuadView)_this, value );
}

/* 'C' function for method : 'Core::QuadView.OnSetPoint2()' */
void CoreQuadView_OnSetPoint2( CoreQuadView _this, XPoint value )
{
  if ( !EwCompPoint( value, _this->Point2 ))
    return;

  if (( _this->Super1.Owner != 0 ) && (( _this->Super1.viewState & CoreViewStateVisible 
      ) == CoreViewStateVisible ))
    CoreGroup__InvalidateArea( _this->Super1.Owner, CoreView__GetExtent( _this ));

  _this->Super1.layoutContext = 0;
  _this->Point2 = value;

  if (( _this->Super1.Owner != 0 ) && (( _this->Super1.viewState & CoreViewStateVisible 
      ) == CoreViewStateVisible ))
    CoreGroup__InvalidateArea( _this->Super1.Owner, CoreView__GetExtent( _this ));

  if ((( _this->Super1.Owner != 0 ) && (( _this->Super1.viewState & CoreViewStateEmbedded 
      ) == CoreViewStateEmbedded )) && !(( _this->Super1.Owner->Super2.viewState 
      & CoreViewStateUpdatingLayout ) == CoreViewStateUpdatingLayout ))
  {
    _this->Super1.viewState = _this->Super1.viewState | CoreViewStateRequestLayout;
    _this->Super1.Owner->Super2.viewState = _this->Super1.Owner->Super2.viewState 
    | CoreViewStatePendingLayout;
    EwPostSignal( EwNewSlot( _this->Super1.Owner, CoreGroup_updateComponent ), ((XObject)_this 
      ));
  }
}

/* Wrapper function for the virtual method : 'Core::QuadView.OnSetPoint2()' */
void CoreQuadView__OnSetPoint2( void* _this, XPoint value )
{
  ((CoreQuadView)_this)->_VMT->OnSetPoint2((CoreQuadView)_this, value );
}

/* 'C' function for method : 'Core::QuadView.OnSetPoint1()' */
void CoreQuadView_OnSetPoint1( CoreQuadView _this, XPoint value )
{
  if ( !EwCompPoint( value, _this->Point1 ))
    return;

  if (( _this->Super1.Owner != 0 ) && (( _this->Super1.viewState & CoreViewStateVisible 
      ) == CoreViewStateVisible ))
    CoreGroup__InvalidateArea( _this->Super1.Owner, CoreView__GetExtent( _this ));

  _this->Super1.layoutContext = 0;
  _this->Point1 = value;

  if (( _this->Super1.Owner != 0 ) && (( _this->Super1.viewState & CoreViewStateVisible 
      ) == CoreViewStateVisible ))
    CoreGroup__InvalidateArea( _this->Super1.Owner, CoreView__GetExtent( _this ));

  if ((( _this->Super1.Owner != 0 ) && (( _this->Super1.viewState & CoreViewStateEmbedded 
      ) == CoreViewStateEmbedded )) && !(( _this->Super1.Owner->Super2.viewState 
      & CoreViewStateUpdatingLayout ) == CoreViewStateUpdatingLayout ))
  {
    _this->Super1.viewState = _this->Super1.viewState | CoreViewStateRequestLayout;
    _this->Super1.Owner->Super2.viewState = _this->Super1.Owner->Super2.viewState 
    | CoreViewStatePendingLayout;
    EwPostSignal( EwNewSlot( _this->Super1.Owner, CoreGroup_updateComponent ), ((XObject)_this 
      ));
  }
}

/* Wrapper function for the virtual method : 'Core::QuadView.OnSetPoint1()' */
void CoreQuadView__OnSetPoint1( void* _this, XPoint value )
{
  ((CoreQuadView)_this)->_VMT->OnSetPoint1((CoreQuadView)_this, value );
}

/* The method IsPointInside() verifies whether the specified position aPoint lies 
   within the quad and returns 'true' if this is the case. If aPoint lies outside 
   the quad, the method returns 'false'. */
XBool CoreQuadView_IsPointInside( CoreQuadView _this, XPoint aPoint )
{
  XPoint points[ 4 ];
  XInt32 i = 0;
  XInt32 j = 3;
  XBool inside1 = 0;
  XBool inside2 = 0;

  points[ 0 ] = _this->Point1;
  points[ 1 ] = _this->Point2;
  points[ 2 ] = _this->Point3;
  points[ 3 ] = _this->Point4;

  while ( i < 4 )
  {
    XInt32 vert1X = points[ EwCheckIndex( i, 4 )].X;
    XInt32 vert1Y = points[ EwCheckIndex( i, 4 )].Y;
    XInt32 vert2X = points[ EwCheckIndex( j, 4 )].X;
    XInt32 vert2Y = points[ EwCheckIndex( j, 4 )].Y;

    if ((( vert1Y > aPoint.Y ) != ( vert2Y > aPoint.Y )) || (( vert1Y < aPoint.Y 
        ) != ( vert2Y < aPoint.Y )))
    {
      XInt32 x = ((( vert2X - vert1X ) * ( aPoint.Y - vert1Y )) / ( vert2Y - vert1Y 
        )) + vert1X;

      if ( aPoint.X > x )
        inside1 = (XBool)!inside1;

      if ( aPoint.X < x )
        inside2 = (XBool)!inside2;
    }

    j = i;
    i = i + 1;
  }

  return (XBool)( inside1 || inside2 );
}

/* The method HasRectShape() evaluates the shape of the quad and returns 'true' 
   if the quad has the shape of a rectangle. Otherwise 'false' is returned. */
XBool CoreQuadView_HasRectShape( CoreQuadView _this )
{
  return (XBool)((((( _this->Point1.X == _this->Point4.X ) && ( _this->Point2.X 
    == _this->Point3.X )) && ( _this->Point1.Y == _this->Point2.Y )) && ( _this->Point3.Y 
    == _this->Point4.Y )) || (((( _this->Point1.X == _this->Point2.X ) && ( _this->Point3.X 
    == _this->Point4.X )) && ( _this->Point1.Y == _this->Point4.Y )) && ( _this->Point2.Y 
    == _this->Point3.Y )));
}

/* Variants derived from the class : 'Core::QuadView' */
EW_DEFINE_CLASS_VARIANTS( CoreQuadView )
EW_END_OF_CLASS_VARIANTS( CoreQuadView )

/* Virtual Method Table (VMT) for the class : 'Core::QuadView' */
EW_DEFINE_CLASS( CoreQuadView, CoreView, "Core::QuadView" )
  CoreQuadView_initLayoutContext,
  CoreView_GetRoot,
  CoreView_Draw,
  CoreView_HandleEvent,
  CoreView_CursorHitTest,
  CoreQuadView_ArrangeView,
  CoreQuadView_MoveView,
  CoreQuadView_GetExtent,
  CoreView_ChangeViewState,
  CoreQuadView_OnSetPoint4,
  CoreQuadView_OnSetPoint3,
  CoreQuadView_OnSetPoint2,
  CoreQuadView_OnSetPoint1,
EW_END_OF_CLASS( CoreQuadView )

/* Initializer for the class 'Core::RectView' */
void CoreRectView__Init( CoreRectView _this, XObject aLink, XHandle aArg )
{
  /* At first initialize the super class ... */
  CoreView__Init( &_this->_Super, aLink, aArg );

  /* Setup the VMT pointer */
  _this->_VMT = EW_CLASS( CoreRectView );

  /* ... and initialize objects, variables, properties, etc. */
}

/* Re-Initializer for the class 'Core::RectView' */
void CoreRectView__ReInit( CoreRectView _this )
{
  /* At first re-initialize the super class ... */
  CoreView__ReInit( &_this->_Super );
}

/* Finalizer method for the class 'Core::RectView' */
void CoreRectView__Done( CoreRectView _this )
{
  /* Finalize this class */
  _this->_VMT = EW_CLASS( CoreRectView );

  /* Don't forget to deinitialize the super class ... */
  CoreView__Done( &_this->_Super );
}

/* Garbage Collector method for the class 'Core::RectView' */
void CoreRectView__Mark( CoreRectView _this )
{
  /* Give the super class a chance to mark its objects and references */
  CoreView__Mark( &_this->_Super );
}

/* 'C' function for method : 'Core::RectView.initLayoutContext()' */
void CoreRectView_initLayoutContext( CoreRectView _this, XRect aBounds, CoreOutline 
  aOutline )
{
  CoreLayoutContext context = EwNewObject( CoreLayoutContext, 0 );

  context->extent = _this->Bounds;
  context->bounds = aBounds;
  context->outline = aOutline;
  _this->Super1.layoutContext = context;
}

/* The method ArrangeView() is invoked automatically if the superior @Owner group 
   needs to re-arrange its views. For example, the changing of the owners size can 
   cause the enclosed views to adapt their position and size, so all views still 
   fit within the new owners area. This method provides the core functionality for 
   the automatic GUI layout mechanism.
   The arrangement is controlled primarily by the @Layout property of the view. 
   It specifies a set of alignment constraints and determines whether the view can 
   change its size. The bounds area where the view should be arranged, is passed 
   in the parameter aBounds. This is usually the current area of the views owner.
   The parameter aFormation defines the desired arrangement mode. Depending on the 
   value of this parameter, the views can be arranged in rows or columns. If aFormation 
   == Core::Formation.None, no automatic row/column arrangement is performed and 
   the view is moved and scaled only to fit inside the aBounds area.
   ArrangeView() is invoked automatically by the framework, so you never should 
   need to invoke it directly.
   The method returns the size of the view after it has been arranged. */
XPoint CoreRectView_ArrangeView( CoreRectView _this, XRect aBounds, XEnum aFormation )
{
  XSet layout = _this->Super1.Layout;
  CoreLayoutContext context = _this->Super1.layoutContext;
  XInt32 x1 = context->extent.Point1.X;
  XInt32 y1 = context->extent.Point1.Y;
  XInt32 x2 = context->extent.Point2.X;
  XInt32 y2 = context->extent.Point2.Y;
  XPoint dstSize = EwGetRectSize( aBounds );
  XInt32 w = x2 - x1;
  XInt32 h = y2 - y1;

  if ( aFormation == CoreFormationNone )
  {
    XPoint srcSize = EwGetRectSize( context->bounds );
    x1 = x1 - context->bounds.Point1.X;
    y1 = y1 - context->bounds.Point1.Y;

    if ( srcSize.X != dstSize.X )
    {
      XBool alignToLeft = (( layout & CoreLayoutAlignToLeft ) == CoreLayoutAlignToLeft 
        );
      XBool alignToRight = (( layout & CoreLayoutAlignToRight ) == CoreLayoutAlignToRight 
        );
      XBool resizeHorz = (( layout & CoreLayoutResizeHorz ) == CoreLayoutResizeHorz 
        );

      if ( !alignToLeft && ( resizeHorz || !alignToRight ))
        x1 = ( x1 * dstSize.X ) / srcSize.X;

      if ( !alignToRight && ( resizeHorz || !alignToLeft ))
      {
        x2 = x2 - context->bounds.Point1.X;
        x2 = ( x2 * dstSize.X ) / srcSize.X;
        x2 = x2 - dstSize.X;
      }
      else
        x2 = x2 - context->bounds.Point2.X;

      x1 = x1 + aBounds.Point1.X;
      x2 = x2 + aBounds.Point2.X;

      if ( !resizeHorz )
      {
        if ( alignToLeft && !alignToRight )
          x2 = x1 + w;
        else
          if ( !alignToLeft && alignToRight )
            x1 = x2 - w;
          else
          {
            x1 = x1 + ((( x2 - x1 ) - w ) / 2 );
            x2 = x1 + w;
          }
      }
    }
    else
    {
      x2 = x2 - context->bounds.Point2.X;
      x1 = x1 + aBounds.Point1.X;
      x2 = x2 + aBounds.Point2.X;
    }

    if ( srcSize.Y != dstSize.Y )
    {
      XBool alignToTop = (( layout & CoreLayoutAlignToTop ) == CoreLayoutAlignToTop 
        );
      XBool alignToBottom = (( layout & CoreLayoutAlignToBottom ) == CoreLayoutAlignToBottom 
        );
      XBool resizeVert = (( layout & CoreLayoutResizeVert ) == CoreLayoutResizeVert 
        );

      if ( !alignToTop && ( resizeVert || !alignToBottom ))
        y1 = ( y1 * dstSize.Y ) / srcSize.Y;

      if ( !alignToBottom && ( resizeVert || !alignToTop ))
      {
        y2 = y2 - context->bounds.Point1.Y;
        y2 = ( y2 * dstSize.Y ) / srcSize.Y;
        y2 = y2 - dstSize.Y;
      }
      else
        y2 = y2 - context->bounds.Point2.Y;

      y1 = y1 + aBounds.Point1.Y;
      y2 = y2 + aBounds.Point2.Y;

      if ( !resizeVert )
      {
        if ( alignToTop && !alignToBottom )
          y2 = y1 + h;
        else
          if ( !alignToTop && alignToBottom )
            y1 = y2 - h;
          else
          {
            y1 = y1 + ((( y2 - y1 ) - h ) / 2 );
            y2 = y1 + h;
          }
      }
    }
    else
    {
      y2 = y2 - context->bounds.Point2.Y;
      y1 = y1 + aBounds.Point1.Y;
      y2 = y2 + aBounds.Point2.Y;
    }
  }
  else
  {
    switch ( aFormation )
    {
      case CoreFormationLeftToRight :
      {
        x1 = aBounds.Point1.X;
        x2 = x1 + w;
      }
      break;

      case CoreFormationRightToLeft :
      {
        x2 = aBounds.Point2.X;
        x1 = x2 - w;
      }
      break;

      case CoreFormationTopToBottom :
      {
        y1 = aBounds.Point1.Y;
        y2 = y1 + h;
      }
      break;

      case CoreFormationBottomToTop :
      {
        y2 = aBounds.Point2.Y;
        y1 = y2 - h;
      }
      break;

      default : 
        ;
    }

    if (( aFormation == CoreFormationLeftToRight ) || ( aFormation == CoreFormationRightToLeft 
        ))
    {
      XBool alignToTop = (( layout & CoreLayoutAlignToTop ) == CoreLayoutAlignToTop 
        );
      XBool alignToBottom = (( layout & CoreLayoutAlignToBottom ) == CoreLayoutAlignToBottom 
        );
      XBool resizeVert = (( layout & CoreLayoutResizeVert ) == CoreLayoutResizeVert 
        );

      if ( resizeVert )
      {
        y1 = aBounds.Point1.Y;
        y2 = aBounds.Point2.Y;
      }
      else
        if ( alignToTop && !alignToBottom )
        {
          y1 = aBounds.Point1.Y;
          y2 = y1 + h;
        }
        else
          if ( alignToBottom && !alignToTop )
          {
            y2 = aBounds.Point2.Y;
            y1 = y2 - h;
          }
          else
          {
            y1 = aBounds.Point1.Y + (( EwGetRectH( aBounds ) - h ) / 2 );
            y2 = y1 + h;
          }
    }

    if (( aFormation == CoreFormationTopToBottom ) || ( aFormation == CoreFormationBottomToTop 
        ))
    {
      XBool alignToLeft = (( layout & CoreLayoutAlignToLeft ) == CoreLayoutAlignToLeft 
        );
      XBool alignToRight = (( layout & CoreLayoutAlignToRight ) == CoreLayoutAlignToRight 
        );
      XBool resizeHorz = (( layout & CoreLayoutResizeHorz ) == CoreLayoutResizeHorz 
        );

      if ( resizeHorz )
      {
        x1 = aBounds.Point1.X;
        x2 = aBounds.Point2.X;
      }
      else
        if ( alignToLeft && !alignToRight )
        {
          x1 = aBounds.Point1.X;
          x2 = x1 + w;
        }
        else
          if ( alignToRight && !alignToLeft )
          {
            x2 = aBounds.Point2.X;
            x1 = x2 - w;
          }
          else
          {
            x1 = aBounds.Point1.X + (( EwGetRectW( aBounds ) - w ) / 2 );
            x2 = x1 + w;
          }
    }
  }

  context->isEmpty = (XBool)(( x1 >= x2 ) || ( y1 >= y2 ));

  if ((( _this->Super1.viewState & CoreViewStateFastReshape ) == CoreViewStateFastReshape 
      ))
  {
    _this->Bounds = EwNewRect( x1, y1, x2, y2 );
  }
  else
  {
    CoreRectView__OnSetBounds( _this, EwNewRect( x1, y1, x2, y2 ));
    _this->Super1.layoutContext = context;
  }

  return EwNewPoint( x2 - x1, y2 - y1 );
}

/* The method MoveView() changes the position of the view by adding the value aOffset 
   to all corners of the view. For example, in case of a line view the value is 
   added to the both line end points.
   The parameter aFastMove serves for the optimization purpose. If it is 'true', 
   the corners are modified without performing any updates of the view and without 
   redrawing the screen. This is useful, when you wish to move or arrange a lot 
   of views at once. In this case it's up to you to request the finally screen update. 
   To do this you can use the method InvalidateArea() of the views @Owner.
   In the case aFastMove == false, the operation automatically requests the screen 
   redraw of the view areas before and after the movement. You don't need to take 
   care about it. */
void CoreRectView_MoveView( CoreRectView _this, XPoint aOffset, XBool aFastMove )
{
  if ( aFastMove )
    _this->Bounds = EwMoveRectPos( _this->Bounds, aOffset );
  else
    CoreRectView__OnSetBounds( _this, EwMoveRectPos( _this->Bounds, aOffset ));
}

/* The method GetExtent() returns the position and the size of the view relative 
   to the origin of its @Owner. In case of views with a non rectangular shape the 
   method returns the rectangular boundary area enclosing the entire shape. */
XRect CoreRectView_GetExtent( CoreRectView _this )
{
  return _this->Bounds;
}

/* 'C' function for method : 'Core::RectView.OnSetBounds()' */
void CoreRectView_OnSetBounds( CoreRectView _this, XRect value )
{
  if ( !EwCompRect( value, _this->Bounds ))
    return;

  if (( _this->Super1.Owner != 0 ) && (( _this->Super1.viewState & CoreViewStateVisible 
      ) == CoreViewStateVisible ))
    CoreGroup__InvalidateArea( _this->Super1.Owner, _this->Bounds );

  _this->Super1.layoutContext = 0;
  _this->Bounds = value;

  if (( _this->Super1.Owner != 0 ) && (( _this->Super1.viewState & CoreViewStateVisible 
      ) == CoreViewStateVisible ))
    CoreGroup__InvalidateArea( _this->Super1.Owner, _this->Bounds );

  if ((( _this->Super1.Owner != 0 ) && (( _this->Super1.viewState & CoreViewStateEmbedded 
      ) == CoreViewStateEmbedded )) && !(( _this->Super1.Owner->Super2.viewState 
      & CoreViewStateUpdatingLayout ) == CoreViewStateUpdatingLayout ))
  {
    _this->Super1.viewState = _this->Super1.viewState | CoreViewStateRequestLayout;
    _this->Super1.Owner->Super2.viewState = _this->Super1.Owner->Super2.viewState 
    | CoreViewStatePendingLayout;
    EwPostSignal( EwNewSlot( _this->Super1.Owner, CoreGroup_updateComponent ), ((XObject)_this 
      ));
  }
}

/* Wrapper function for the virtual method : 'Core::RectView.OnSetBounds()' */
void CoreRectView__OnSetBounds( void* _this, XRect value )
{
  ((CoreRectView)_this)->_VMT->OnSetBounds((CoreRectView)_this, value );
}

/* Variants derived from the class : 'Core::RectView' */
EW_DEFINE_CLASS_VARIANTS( CoreRectView )
EW_END_OF_CLASS_VARIANTS( CoreRectView )

/* Virtual Method Table (VMT) for the class : 'Core::RectView' */
EW_DEFINE_CLASS( CoreRectView, CoreView, "Core::RectView" )
  CoreRectView_initLayoutContext,
  CoreView_GetRoot,
  CoreView_Draw,
  CoreView_HandleEvent,
  CoreView_CursorHitTest,
  CoreRectView_ArrangeView,
  CoreRectView_MoveView,
  CoreRectView_GetExtent,
  CoreView_ChangeViewState,
  CoreRectView_OnSetBounds,
EW_END_OF_CLASS( CoreRectView )

/* Initializer for the class 'Core::Group' */
void CoreGroup__Init( CoreGroup _this, XObject aLink, XHandle aArg )
{
  /* At first initialize the super class ... */
  CoreRectView__Init( &_this->_Super, aLink, aArg );

  /* Setup the VMT pointer */
  _this->_VMT = EW_CLASS( CoreGroup );

  /* ... and initialize objects, variables, properties, etc. */
  _this->Super2.viewState = CoreViewStateAlphaBlended | CoreViewStateEnabled | CoreViewStateFocusable 
  | CoreViewStateTouchable | CoreViewStateVisible;
  _this->Opacity = 255;

  /* Call the user defined constructor */
  CoreGroup_Init( _this, aArg );
}

/* Re-Initializer for the class 'Core::Group' */
void CoreGroup__ReInit( CoreGroup _this )
{
  /* At first re-initialize the super class ... */
  CoreRectView__ReInit( &_this->_Super );
}

/* Finalizer method for the class 'Core::Group' */
void CoreGroup__Done( CoreGroup _this )
{
  /* Finalize this class */
  _this->_VMT = EW_CLASS( CoreGroup );

  /* Don't forget to deinitialize the super class ... */
  CoreRectView__Done( &_this->_Super );
}

/* Garbage Collector method for the class 'Core::Group' */
void CoreGroup__Mark( CoreGroup _this )
{
  EwMarkObject( _this->first );
  EwMarkObject( _this->last );
  EwMarkObject( _this->keyHandlers );
  EwMarkObject( _this->buffer );
  EwMarkObject( _this->dialogStack );
  EwMarkObject( _this->fadersQueue );
  EwMarkObject( _this->Focus );

  /* Give the super class a chance to mark its objects and references */
  CoreRectView__Mark( &_this->_Super );
}

/* The method Draw() is invoked automatically if parts of the view should be redrawn 
   on the screen. This can occur when e.g. the view has been moved or the appearance 
   of the view has changed before.
   Draw() is invoked automatically by the framework, you never will need to invoke 
   this method directly. However you can request an invocation of this method by 
   calling the method InvalidateArea() of the views @Owner. Usually this is also 
   unnecessary unless you are developing your own view.
   The passed parameters determine the drawing destination aCanvas and the area 
   to redraw aClip in the coordinate space of the canvas. The parameter aOffset 
   contains the displacement between the origin of the views owner and the origin 
   of the canvas. You will need it to convert views coordinates into these of the 
   canvas.
   The parameter aOpacity contains the opacity descended from this view's @Owner. 
   It lies in range 0 .. 255. If the view implements its own 'Opacity', 'Color', 
   etc. properties, the Draw() method should calculate the resulting real opacity 
   by mixing the values of these properties with the one passed in aOpacity parameter.
   The parameter aBlend contains the blending mode descended from this view's @Owner. 
   It determines, whether the view should be drawn with alpha-blending active or 
   not. If aBlend is false, the outputs of the view should overwrite the corresponding 
   pixel in the drawing destination aCanvas. If aBlend is true, the outputs should 
   be mixed with the pixel already stored in aCanvas. For this purpose all Graphics 
   Engine functions provide a parameter to specify the mode for the respective drawing 
   operation. If the view implements its own 'Blend' property, the Draw() method 
   should calculate the resulting real blend mode by using logical AND operation 
   of the value of the property and the one passed in aBlend parameter. */
void CoreGroup_Draw( CoreGroup _this, GraphicsCanvas aCanvas, XRect aClip, XPoint 
  aOffset, XInt32 aOpacity, XBool aBlend )
{
  aOpacity = (( aOpacity + 1 ) * _this->Opacity ) >> 8;
  aBlend = (XBool)( aBlend && (( _this->Super2.viewState & CoreViewStateAlphaBlended 
  ) == CoreViewStateAlphaBlended ));

  if ( _this->buffer == 0 )
    CoreGroup_drawContent( _this, aCanvas, aClip, EwMovePointPos( aOffset, _this->Super1.Bounds.Point1 
    ), aOpacity, aBlend );
  else
  {
    XColor c = EwNewColor( 255, 255, 255, (XUInt8)aOpacity );
    ResourcesBitmap__Update( _this->buffer );
    GraphicsCanvas_CopyBitmap( aCanvas, aClip, ((ResourcesBitmap)_this->buffer ), 
    0, EwMoveRectPos( _this->Super1.Bounds, aOffset ), _Const0000, c, c, c, c, aBlend 
    );
  }
}

/* The method CursorHitTest() is invoked automatically in order to determine whether 
   the view is interested in the receipt of cursor events or not. This method will 
   be invoked immediately after the user has tapped the visible area of the view. 
   If the view is not interested in the cursor event, the framework repeats this 
   procedure for the next behind view until a willing view has been found or all 
   views are evaluated.
   In the implementation of the method the view can evaluate the passed aArea parameter. 
   It determines the place where the user has tapped the view with his fingertip 
   expressed in the coordinates of the views @Owner. The method can test e.g. whether 
   the tapped area does intersect any touchable areas within the view, etc. The 
   affected finger is identified in the parameter aFinger. The first finger (or 
   the first mouse device button) has the number 0.
   The parameter aStrikeCount determines how many times the same area has been tapped 
   in series. This is useful to detect series of multiple touches, e.g. in case 
   of the double click, aStrikeCount == 2.
   The parameter aDedicatedView, if it is not 'null', restricts the event to be 
   handled by this view only. If aDedicatedView == null, no special restriction 
   exists.
   This method is also invoked if during an existing grab cycle the current target 
   view has decided to resign and deflect the cursor events to another view. This 
   is usually the case after the user has performed a gesture the current target 
   view is not interested to process. Thereupon, the system looks for another view 
   willing to take over the cursor event processing after the performed gesture. 
   Which gesture has caused the operation, is specified in the parameter aRetargetReason.
   If the view is willing to process the event, the method should create, initialize 
   and return a new Core::CursorHit object. This object identify the willing view. 
   Otherwise the method should return 'null'.
   CursorHitTest() is invoked automatically by the framework, so you never should 
   need to invoke it directly. This method is predetermined for the hit-test only. 
   The proper processing of events should take place in the @HandleEvent() method 
   by reacting to Core::CursorEvent and Core::DragEvent events. */
CoreCursorHit CoreGroup_CursorHitTest( CoreGroup _this, XRect aArea, XInt32 aFinger, 
  XInt32 aStrikeCount, CoreView aDedicatedView, XSet aRetargetReason )
{
  CoreView view = _this->last;
  CoreCursorHit found = 0;
  XRect area = _Const0001;
  CoreView form = 0;
  XBool lock = (XBool)(( _this->fadersQueue != 0 ) && (( _this->fadersQueue->current 
    != 0 ) || ( _this->fadersQueue->first != 0 )));

  if ( EwIsRectEmpty( EwIntersectRect( aArea, _this->Super1.Bounds )))
    return 0;

  aArea = EwMoveRectNeg( aArea, _this->Super1.Bounds.Point1 );

  while ( view != 0 )
  {
    if ((( view->viewState & CoreViewStateEmbedded ) == CoreViewStateEmbedded ) 
        && ( form == 0 ))
    {
      form = view->prev;

      while (( form != 0 ) && !(( form->viewState & CoreViewStateIsOutline ) == 
             CoreViewStateIsOutline ))
        form = form->prev;

      if ( form != 0 )
        area = EwIntersectRect( aArea, CoreView__GetExtent( form ));
      else
        area = _Const0001;
    }

    if ( form == view )
    {
      form = 0;
      area = _Const0001;
    }

    if (((((( view->viewState & CoreViewStateTouchable ) == CoreViewStateTouchable 
        ) && (( view->viewState & CoreViewStateEnabled ) == CoreViewStateEnabled 
        )) && !(( view->viewState & CoreViewStateRunningFader ) == CoreViewStateRunningFader 
        )) && !(( view->viewState & CoreViewStatePendingFader ) == CoreViewStatePendingFader 
        )) && ( !(( view->viewState & CoreViewStateDialog ) == CoreViewStateDialog 
        ) || (((CoreView)_this->dialogStack->group == view ) && !lock )))
    {
      XRect extent = CoreView__GetExtent( view );
      CoreView dedicatedView = aDedicatedView;
      CoreCursorHit cursorHit = 0;

      if ( dedicatedView == view )
        dedicatedView = 0;

      if ((( view->viewState & CoreViewStateEmbedded ) == CoreViewStateEmbedded 
          ))
      {
        if ( !EwIsRectEmpty( EwIntersectRect( extent, area )))
          cursorHit = CoreView__CursorHitTest( view, area, aFinger, aStrikeCount, 
          dedicatedView, aRetargetReason );
      }
      else
      {
        if ( !EwIsRectEmpty( EwIntersectRect( extent, aArea )) || ( aDedicatedView 
            == view ))
          cursorHit = CoreView__CursorHitTest( view, aArea, aFinger, aStrikeCount, 
          dedicatedView, aRetargetReason );
      }

      view = view->prev;

      if ( cursorHit != 0 )
      {
        if (( found == 0 ) || (( cursorHit->Deviation < found->Deviation ) && ( 
            cursorHit->Deviation >= 0 )))
          found = cursorHit;

        if ( cursorHit->Deviation == 0 )
          view = 0;
      }
    }
    else
      view = view->prev;
  }

  return found;
}

/* The method ChangeViewState() modifies the current state of the view. The state 
   is a set of switches determining whether a view is visible, whether it can react 
   to user inputs or whether it is just performing some update operations, etc.
   The modification is controlled by the the both parameters. The first aSetState 
   contains the switches to activate within the view state. The second aClearState 
   determines all switches to disable.
   Depending on the state alteration the method will perform different operations, 
   e.g. in response to the clearing of the visible state, the method will request 
   a screen redraw to make disappear the view from the screen.
   ChangeViewState() is invoked automatically by the framework, so you never should 
   need to invoke it directly. All relevant states are available as properties e.g. 
   the property Visible in derived classes reflects the visible state of the view. */
void CoreGroup_ChangeViewState( CoreGroup _this, XSet aSetState, XSet aClearState )
{
  XSet oldState = _this->Super2.viewState;
  XSet deltaState;

  CoreView_ChangeViewState((CoreView)_this, aSetState, aClearState );
  deltaState = _this->Super2.viewState ^ oldState;

  if (( _this->Focus != 0 ) && (( deltaState & CoreViewStateFocused ) == CoreViewStateFocused 
      ))
  {
    if ((( _this->Super2.viewState & CoreViewStateFocused ) == CoreViewStateFocused 
        ))
      CoreView__ChangeViewState( _this->Focus, CoreViewStateFocused, 0 );
    else
      CoreView__ChangeViewState( _this->Focus, 0, CoreViewStateFocused );
  }

  if (( _this->dialogStack != 0 ) && (( deltaState & CoreViewStateFocused ) == CoreViewStateFocused 
      ))
  {
    if ((( _this->Super2.viewState & CoreViewStateFocused ) == CoreViewStateFocused 
        ) && (( _this->dialogStack->group->Super2.viewState & ( CoreViewStateEnabled 
        | CoreViewStateFocusable )) == ( CoreViewStateEnabled | CoreViewStateFocusable 
        )))
      CoreView__ChangeViewState( _this->dialogStack->group, CoreViewStateFocused, 
      0 );
    else
      CoreView__ChangeViewState( _this->dialogStack->group, 0, CoreViewStateFocused 
      );
  }

  if ( !!deltaState )
  {
    _this->Super2.viewState = _this->Super2.viewState | CoreViewStatePendingViewState;
    EwPostSignal( EwNewSlot( _this, CoreGroup_updateComponent ), ((XObject)_this 
      ));
  }
}

/* 'C' function for method : 'Core::Group.OnSetBounds()' */
void CoreGroup_OnSetBounds( CoreGroup _this, XRect value )
{
  XPoint oldSize;
  XPoint newSize;
  XBool resize;

  if ( !EwCompRect( value, _this->Super1.Bounds ))
    return;

  oldSize = EwGetRectSize( _this->Super1.Bounds );
  newSize = EwGetRectSize( value );
  resize = (XBool)EwCompPoint( oldSize, newSize );

  if ( resize && ( _this->buffer != 0 ))
  {
    ResourcesBitmap__OnSetFrameSize( _this->buffer, newSize );
    EwNotifyObjObservers((XObject)_this, 0 );
    EwNotifyObjObservers((XObject)_this->buffer, 0 );
  }

  CoreRectView_OnSetBounds((CoreRectView)_this, value );

  if (( resize && ( oldSize.X > 0 )) && ( oldSize.Y > 0 ))
  {
    XRect bounds = EwNewRect2Point( _Const0000, oldSize );
    CoreView view = _this->first;
    XSet fixed = CoreLayoutAlignToLeft | CoreLayoutAlignToTop;

    while ( view != 0 )
    {
      if ((( view->layoutContext == 0 ) && ( view->Layout != fixed )) && !(( view->viewState 
          & CoreViewStateEmbedded ) == CoreViewStateEmbedded ))
        CoreView__initLayoutContext( view, bounds, 0 );

      view = view->next;
    }
  }

  if ( resize )
  {
    _this->Super2.viewState = _this->Super2.viewState | ( CoreViewStatePendingLayout 
    | CoreViewStateUpdateLayout );
    EwPostSignal( EwNewSlot( _this, CoreGroup_updateComponent ), ((XObject)_this 
      ));
  }
}

/* 'C' function for method : 'Core::Group.processKeyHandlers()' */
XObject CoreGroup_processKeyHandlers( CoreGroup _this, CoreEvent aEvent )
{
  CoreKeyEvent keyEvent = EwCastObject( aEvent, CoreKeyEvent );
  CoreKeyPressHandler handler = _this->keyHandlers;

  if ( keyEvent == 0 )
    return 0;

  while (( handler != 0 ) && ( !handler->Enabled || !CoreKeyPressHandler_HandleEvent( 
         handler, keyEvent )))
    handler = handler->next;

  return ((XObject)handler );
}

/* 'C' function for method : 'Core::Group.drawContent()' */
void CoreGroup_drawContent( CoreGroup _this, GraphicsCanvas aCanvas, XRect aClip, 
  XPoint aOffset, XInt32 aOpacity, XBool aBlend )
{
  CoreView view = _this->first;
  XRect clip = _Const0001;
  XBool outlineVisible = 1;

  while ( view != 0 )
  {
    if ((( view->viewState & CoreViewStateIsOutline ) == CoreViewStateIsOutline 
        ))
    {
      CoreOutline outlineView = EwCastObject( view, CoreOutline );
      clip = EwIntersectRect( aClip, EwMoveRectPos( outlineView->Super1.Bounds, 
      aOffset ));
      outlineVisible = (( outlineView->Super2.viewState & CoreViewStateVisible ) 
      == CoreViewStateVisible );
    }

    if ((( view->viewState & CoreViewStateVisible ) == CoreViewStateVisible ))
    {
      if ((( view->viewState & CoreViewStateEmbedded ) == CoreViewStateEmbedded 
          ))
      {
        if ( outlineVisible )
        {
          XRect area = EwIntersectRect( EwMoveRectPos( CoreView__GetExtent( view 
            ), aOffset ), clip );

          if ( !EwIsRectEmpty( area ))
            CoreView__Draw( view, aCanvas, area, aOffset, aOpacity, aBlend );
        }
      }
      else
      {
        XRect area = EwIntersectRect( EwMoveRectPos( CoreView__GetExtent( view ), 
          aOffset ), aClip );

        if ( !EwIsRectEmpty( area ))
          CoreView__Draw( view, aCanvas, area, aOffset, aOpacity, aBlend );
      }
    }

    view = view->next;
  }
}

/* 'C' function for method : 'Core::Group.recalculateLayout()' */
void CoreGroup_recalculateLayout( CoreGroup _this )
{
  XBool groupLayout = (( _this->Super2.viewState & CoreViewStateUpdateLayout ) == 
    CoreViewStateUpdateLayout );
  XRect groupBounds = EwGetRectORect( _this->Super1.Bounds );
  XBool formLayout = 0;
  XRect formBounds = _Const0001;
  XPoint formOffset = _Const0000;
  XInt32 formSpace = 0;
  XEnum formMode = CoreFormationNone;
  CoreView view = _this->last;
  CoreOutline form = 0;
  XSet fixed = CoreLayoutAlignToLeft | CoreLayoutAlignToTop;

  while ( view != 0 )
  {
    if ((( view->viewState & CoreViewStateRequestLayout ) == CoreViewStateRequestLayout 
        ))
    {
      formLayout = 1;
      view->viewState = view->viewState & ~CoreViewStateRequestLayout;
    }

    if ( formLayout && (( view->viewState & CoreViewStateIsOutline ) == CoreViewStateIsOutline 
        ))
    {
      formLayout = 0;

      if ( EwCastObject( view, CoreOutline )->Formation != CoreFormationNone )
        view->viewState = view->viewState | CoreViewStateUpdateLayout;
    }

    view = view->prev;
  }

  formLayout = 0;
  view = _this->first;

  if ( groupLayout )
  {
    _this->Super2.viewState = _this->Super2.viewState & ~CoreViewStateUpdateLayout;
    groupLayout = (XBool)!EwIsRectEmpty( groupBounds );
  }

  _this->Super2.viewState = _this->Super2.viewState | CoreViewStateUpdatingLayout;

  while ( view != 0 )
  {
    if ((( view->viewState & CoreViewStateEmbedded ) == CoreViewStateEmbedded ))
    {
      if (( view->layoutContext != 0 ) && ( view->layoutContext->outline != form 
          ))
        view->layoutContext = 0;

      if ((( view->layoutContext == 0 ) && formLayout ) && (( view->Layout != fixed 
          ) || ( formMode != CoreFormationNone )))
        CoreView__initLayoutContext( view, formBounds, form );
    }

    if ( view->layoutContext != 0 )
    {
      if ( groupLayout && !(( view->viewState & CoreViewStateEmbedded ) == CoreViewStateEmbedded 
          ))
        CoreView__ArrangeView( view, groupBounds, CoreFormationNone );

      if ( formLayout && (( view->viewState & CoreViewStateEmbedded ) == CoreViewStateEmbedded 
          ))
      {
        XPoint size = CoreView__ArrangeView( view, EwMoveRectPos( formBounds, formOffset 
          ), formMode );

        if ((( view->viewState & CoreViewStateVisible ) == CoreViewStateVisible 
            ))
        {
          XPoint ofs = _Const0000;

          switch ( formMode )
          {
            case CoreFormationLeftToRight :
              ofs.X = ( size.X + formSpace );
            break;

            case CoreFormationRightToLeft :
              ofs.X = ( -size.X - formSpace );
            break;

            case CoreFormationTopToBottom :
              ofs.Y = ( size.Y + formSpace );
            break;

            case CoreFormationBottomToTop :
              ofs.Y = ( -size.Y - formSpace );
            break;

            default : 
              ;
          }

          formOffset = EwMovePointPos( formOffset, ofs );
        }
      }
    }

    if ((( view->viewState & CoreViewStateIsOutline ) == CoreViewStateIsOutline 
        ))
    {
      formLayout = (( view->viewState & CoreViewStateUpdateLayout ) == CoreViewStateUpdateLayout 
      );
      form = EwCastObject( view, CoreOutline );

      if ( formLayout )
      {
        view->viewState = view->viewState & ~CoreViewStateUpdateLayout;
        formBounds = EwMoveRectPos( form->Super1.Bounds, form->ScrollOffset );
        formOffset = _Const0000;
        formMode = form->Formation;
        formSpace = form->Space;
        formLayout = (XBool)!EwIsRectEmpty( formBounds );
      }

      if ( formLayout )
      {
        CoreGroup__InvalidateArea( _this, form->Super1.Bounds );
      }
    }

    view = view->next;
  }

  _this->Super2.viewState = _this->Super2.viewState & ~CoreViewStateUpdatingLayout;
  CoreGroup__UpdateLayout( _this, EwGetRectSize( groupBounds ));
}

/* 'C' function for method : 'Core::Group.updateComponent()' */
void CoreGroup_updateComponent( CoreGroup _this, XObject sender )
{
  XBool updateLayout;

  /* Dummy expressions to avoid the 'C' warning 'unused argument'. */
  EW_UNUSED_ARG( sender );

  updateLayout = (( _this->Super2.viewState & CoreViewStateUpdateLayout ) == CoreViewStateUpdateLayout 
  );

  if ((( _this->Super2.viewState & CoreViewStatePendingLayout ) == CoreViewStatePendingLayout 
      ))
  {
    _this->Super2.viewState = _this->Super2.viewState & ~CoreViewStatePendingLayout;
    CoreGroup_recalculateLayout( _this );
  }

  if ((( _this->Super2.viewState & CoreViewStatePendingViewState ) == CoreViewStatePendingViewState 
      ) || updateLayout )
  {
    _this->Super2.viewState = _this->Super2.viewState & ~CoreViewStatePendingViewState;
    CoreGroup__UpdateViewState( _this, _this->Super2.viewState );
  }
}

/* 'C' function for method : 'Core::Group.OnSetFocus()' */
void CoreGroup_OnSetFocus( CoreGroup _this, CoreView value )
{
  if (( value != 0 ) && ( value->Owner != _this ))
  {
    EwThrow( EwLoadString( &_Const0002 ));
    return;
  }

  if (( value != 0 ) && !(( value->viewState & ( CoreViewStateEnabled | CoreViewStateFocusable 
      )) == ( CoreViewStateEnabled | CoreViewStateFocusable )))
    value = 0;

  if (( value != 0 ) && (( value->viewState & CoreViewStateDialog ) == CoreViewStateDialog 
      ))
    value = 0;

  if ( value == _this->Focus )
    return;

  if ( _this->Focus != 0 )
    CoreView__ChangeViewState( _this->Focus, 0, CoreViewStateFocused | CoreViewStateSelected 
    );

  _this->Focus = value;

  if ( value != 0 )
  {
    if ((( _this->Super2.viewState & CoreViewStateFocused ) == CoreViewStateFocused 
        ))
      CoreView__ChangeViewState( value, CoreViewStateFocused | CoreViewStateSelected, 
      0 );
    else
      CoreView__ChangeViewState( value, CoreViewStateSelected, 0 );
  }
}

/* Wrapper function for the virtual method : 'Core::Group.OnSetFocus()' */
void CoreGroup__OnSetFocus( void* _this, CoreView value )
{
  ((CoreGroup)_this)->_VMT->OnSetFocus((CoreGroup)_this, value );
}

/* 'C' function for method : 'Core::Group.OnSetEnabled()' */
void CoreGroup_OnSetEnabled( CoreGroup _this, XBool value )
{
  if ( value )
    CoreView__ChangeViewState( _this, CoreViewStateEnabled, 0 );
  else
    CoreView__ChangeViewState( _this, 0, CoreViewStateEnabled );
}

/* 'C' function for method : 'Core::Group.OnSetOpacity()' */
void CoreGroup_OnSetOpacity( CoreGroup _this, XInt32 value )
{
  if ( value > 255 )
    value = 255;

  if ( value < 0 )
    value = 0;

  if ( value == _this->Opacity )
    return;

  _this->Opacity = value;

  if (( _this->Super2.Owner != 0 ) && (( _this->Super2.viewState & CoreViewStateVisible 
      ) == CoreViewStateVisible ))
    CoreGroup__InvalidateArea( _this->Super2.Owner, _this->Super1.Bounds );
}

/* Wrapper function for the virtual method : 'Core::Group.OnSetOpacity()' */
void CoreGroup__OnSetOpacity( void* _this, XInt32 value )
{
  ((CoreGroup)_this)->_VMT->OnSetOpacity((CoreGroup)_this, value );
}

/* 'C' function for method : 'Core::Group.OnSetEmbedded()' */
void CoreGroup_OnSetEmbedded( CoreGroup _this, XBool value )
{
  if ( value )
    CoreView__ChangeViewState( _this, CoreViewStateEmbedded, 0 );
  else
    CoreView__ChangeViewState( _this, 0, CoreViewStateEmbedded );
}

/* 'C' function for method : 'Core::Group.OnSetVisible()' */
void CoreGroup_OnSetVisible( CoreGroup _this, XBool value )
{
  if ( value )
    CoreView__ChangeViewState( _this, CoreViewStateVisible, 0 );
  else
    CoreView__ChangeViewState( _this, 0, CoreViewStateVisible );
}

/* The method LocalPosition() converts the given position aPoint from the screen 
   coordinate space to the coordinate space of this component and returns the calculated 
   position. In the case the component isn't visible within the application, the 
   method can fail and return a wrong position. */
XPoint CoreGroup_LocalPosition( CoreGroup _this, XPoint aPoint )
{
  CoreGroup tmp = _this;

  while ( tmp != 0 )
  {
    aPoint = EwMovePointNeg( aPoint, tmp->Super1.Bounds.Point1 );
    tmp = tmp->Super2.Owner;
  }

  return aPoint;
}

/* The method DispatchEvent() feeds the component with the event passed in the parameter 
   aEvent and propagates it along the so-called focus path. This focus path leads 
   to the currently selected keyboard event receiver view. If the event is rejected 
   by the view, the same operation is repeated for the next superior view. This 
   permits the hierarchical event dispatching until a willing view has handled the 
   event or all views in the focus path have been evaluated. If the event remains 
   still unhandled, it will be passed to the component itself.
   The focus path is established by the property @Focus. 
   DispatchEvent() returns the value returned by the @HandleEvent() method of the 
   view which has handled the event. In the case, the event was not handled, the 
   method returns 'null'. */
XObject CoreGroup_DispatchEvent( CoreGroup _this, CoreEvent aEvent )
{
  CoreView view = _this->Focus;
  CoreGroup grp = EwCastObject( view, CoreGroup );
  XObject handled = 0;
  XBool lock = (XBool)(( _this->fadersQueue != 0 ) && (( _this->fadersQueue->current 
    != 0 ) || ( _this->fadersQueue->first != 0 )));

  if (( view != 0 ) && (((( view->viewState & CoreViewStateDialog ) == CoreViewStateDialog 
      ) || (( view->viewState & CoreViewStateRunningFader ) == CoreViewStateRunningFader 
      )) || (( view->viewState & CoreViewStatePendingFader ) == CoreViewStatePendingFader 
      )))
  {
    view = 0;
    grp = 0;
  }

  if (( _this->dialogStack != 0 ) && !lock )
    handled = CoreGroup__DispatchEvent( _this->dialogStack->group, aEvent );

  if (( handled == 0 ) && ( grp != 0 ))
    handled = CoreGroup__DispatchEvent( grp, aEvent );
  else
    if (( handled == 0 ) && ( view != 0 ))
      handled = CoreView__HandleEvent( view, aEvent );

  if ( handled == 0 )
    handled = CoreView__HandleEvent( _this, aEvent );

  if ( handled == 0 )
    handled = CoreGroup_processKeyHandlers( _this, aEvent );

  return handled;
}

/* Wrapper function for the virtual method : 'Core::Group.DispatchEvent()' */
XObject CoreGroup__DispatchEvent( void* _this, CoreEvent aEvent )
{
  return ((CoreGroup)_this)->_VMT->DispatchEvent((CoreGroup)_this, aEvent );
}

/* The method BroadcastEventAtPosition() feeds the component with the event passed 
   in the parameter aEvent and propagates it to all views, which do exist within 
   the component and do enclose the given position aPosition until the event has 
   been handled or all affected views are evaluated. If the event remains still 
   unhandled, it will be passed to the component itself.
   Beside the position, the additional parameter aFilter can be used to limit the 
   operation to special views only, e.g. to visible and touchable views.
   BroadcastEventAtPosition() is very useful to provide views with one and the same 
   event in order e.g. to inform the views about an important global state alteration. 
   The parameters aPosition and aFilter limit the operation to particular views. 
   To send events to all views regardless of their position use the method @BroadcastEvent().
   BroadcastEventAtPosition() returns the value returned by the @HandleEvent() method 
   of the view which has handled the event. In the case, the event was not handled, 
   the method returns 'null'. */
XObject CoreGroup_BroadcastEventAtPosition( CoreGroup _this, CoreEvent aEvent, XPoint 
  aPosition, XSet aFilter )
{
  CoreView view = _this->last;
  XObject handled = 0;

  while (( view != 0 ) && ( handled == 0 ))
  {
    if (( !aFilter || EwSetContains( view->viewState, aFilter )) && EwIsPointInRect( 
        CoreView__GetExtent( view ), aPosition ))
    {
      CoreGroup grp = EwCastObject( view, CoreGroup );

      if ( grp != 0 )
        handled = CoreGroup_BroadcastEventAtPosition( grp, aEvent, EwMovePointNeg( 
        aPosition, grp->Super1.Bounds.Point1 ), aFilter );
      else
        handled = CoreView__HandleEvent( view, aEvent );
    }

    view = view->prev;
  }

  if ( handled == 0 )
    handled = CoreView__HandleEvent( _this, aEvent );

  return handled;
}

/* Wrapper function for the non virtual method : 'Core::Group.BroadcastEventAtPosition()' */
XObject CoreGroup__BroadcastEventAtPosition( void* _this, CoreEvent aEvent, XPoint 
  aPosition, XSet aFilter )
{
  return CoreGroup_BroadcastEventAtPosition((CoreGroup)_this, aEvent, aPosition, 
  aFilter );
}

/* The method BroadcastEvent() feeds the component with the event passed in the 
   parameter aEvent and propagates it to all views enclosed within the component 
   until the event has been handled or all views are evaluated. If the event remains 
   still unhandled, it will be passed to the component itself.
   The additional parameter aFilter can be used to limit the operation to special 
   views only, e.g. to visible and touchable views. To broadcast the event to all 
   views pass in the parameter aFilter the value 'Core::ViewState[]'.
   BroadcastEvent() is very useful to provide all views with one and the same event 
   in order e.g. to inform all views about an important global state alteration. 
   To send events to views enclosing a given position use the method @BroadcastEventAtPosition().
   BroadcastEvent() returns the value returned by the @HandleEvent() method of the 
   view which has handled the event. In the case, the event was not handled, the 
   method returns 'null'. */
XObject CoreGroup_BroadcastEvent( CoreGroup _this, CoreEvent aEvent, XSet aFilter )
{
  CoreView view = _this->last;
  XObject handled = 0;

  while (( view != 0 ) && ( handled == 0 ))
  {
    if ( !aFilter || EwSetContains( view->viewState, aFilter ))
    {
      CoreGroup grp = EwCastObject( view, CoreGroup );

      if ( grp != 0 )
        handled = CoreGroup__BroadcastEvent( grp, aEvent, aFilter );
      else
        handled = CoreView__HandleEvent( view, aEvent );
    }

    view = view->prev;
  }

  if ( handled == 0 )
    handled = CoreView__HandleEvent( _this, aEvent );

  if ( handled == 0 )
    handled = CoreGroup_processKeyHandlers( _this, aEvent );

  return handled;
}

/* Wrapper function for the virtual method : 'Core::Group.BroadcastEvent()' */
XObject CoreGroup__BroadcastEvent( void* _this, CoreEvent aEvent, XSet aFilter )
{
  return ((CoreGroup)_this)->_VMT->BroadcastEvent((CoreGroup)_this, aEvent, aFilter );
}

/* The method UpdateLayout() is invoked automatically after the size of the component 
   has been changed. This method can be overridden and filled with logic to perform 
   a sophisticated arrangement calculation for one or more enclosed views. In this 
   case the parameter aSize can be used. It contains the current size of the component. 
   Usually, all enclosed views are arranged automatically accordingly to their @Layout 
   property. UpdateLayout() gives the derived components a chance to extend this 
   automatism by a user defined algorithm. */
void CoreGroup_UpdateLayout( CoreGroup _this, XPoint aSize )
{
  /* Dummy expressions to avoid the 'C' warning 'unused argument'. */
  EW_UNUSED_ARG( _this );
  EW_UNUSED_ARG( aSize );
}

/* Wrapper function for the virtual method : 'Core::Group.UpdateLayout()' */
void CoreGroup__UpdateLayout( void* _this, XPoint aSize )
{
  ((CoreGroup)_this)->_VMT->UpdateLayout((CoreGroup)_this, aSize );
}

/* The method UpdateViewState() is invoked automatically after the state of the 
   component has been changed. This method can be overridden and filled with logic 
   to ensure the visual aspect of the component does reflect its current state. 
   For example, the 'enabled' state of the component can affect its colors (disabled 
   components may appear pale). In this case the logic of the method should modify 
   the respective color properties accordingly to the current 'enabled' state. 
   The current state of the component is passed as a set in the parameter aState. 
   It reflects the very basic component state like its visibility or the ability 
   to react to user inputs. Beside this common state, the method can also involve 
   any other variables used in the component as long as they reflect its current 
   state. For example, the toggle switch component can take in account its toggle 
   state 'on' or 'off' and change accordingly the location of the slider, etc.
   Usually, this method will be invoked automatically by the framework. Optionally 
   you can request its invocation by using the method @InvalidateViewState(). */
void CoreGroup_UpdateViewState( CoreGroup _this, XSet aState )
{
  /* Dummy expressions to avoid the 'C' warning 'unused argument'. */
  EW_UNUSED_ARG( _this );
  EW_UNUSED_ARG( aState );
}

/* Wrapper function for the virtual method : 'Core::Group.UpdateViewState()' */
void CoreGroup__UpdateViewState( void* _this, XSet aState )
{
  ((CoreGroup)_this)->_VMT->UpdateViewState((CoreGroup)_this, aState );
}

/* The method InvalidateViewState() declares the state of this component as changed, 
   so its visual aspect possibly doesn't reflect its current state anymore. To update 
   the visual aspect, the framework will invoke the @UpdateViewState() method. */
void CoreGroup_InvalidateViewState( CoreGroup _this )
{
  _this->Super2.viewState = _this->Super2.viewState | CoreViewStatePendingViewState;
  EwPostSignal( EwNewSlot( _this, CoreGroup_updateComponent ), ((XObject)_this ));
}

/* The method InvalidateArea() declares the given area of the component as invalid, 
   this means this area should be redrawn at the next screen update. */
void CoreGroup_InvalidateArea( CoreGroup _this, XRect aArea )
{
  CoreGroup grp = _this;

  while (( grp != 0 ) && !EwIsRectEmpty( aArea ))
  {
    GraphicsCanvas buf = grp->buffer;

    if (( grp->Super2.Owner == 0 ) && ( grp != _this ))
    {
      CoreGroup__InvalidateArea( grp, aArea );
      return;
    }

    if ( buf != 0 )
    {
      XBool fullOffScreenBufferUpdate;

      if ( EwIsRectEmpty( buf->InvalidArea ))
      {
        EwNotifyObjObservers((XObject)grp, 0 );
        EwNotifyObjObservers((XObject)buf, 0 );
      }

      fullOffScreenBufferUpdate = 0;
      fullOffScreenBufferUpdate = EwFullOffScreenBufferUpdate;

      if ( fullOffScreenBufferUpdate )
        buf->InvalidArea = EwGetRectORect( grp->Super1.Bounds );
      else
        buf->InvalidArea = EwUnionRect( buf->InvalidArea, aArea );
    }

    if ( !(( grp->Super2.viewState & CoreViewStateVisible ) == CoreViewStateVisible 
        ))
      return;

    aArea = EwIntersectRect( EwMoveRectPos( aArea, grp->Super1.Bounds.Point1 ), 
    grp->Super1.Bounds );
    grp = grp->Super2.Owner;
  }
}

/* Wrapper function for the virtual method : 'Core::Group.InvalidateArea()' */
void CoreGroup__InvalidateArea( void* _this, XRect aArea )
{
  ((CoreGroup)_this)->_VMT->InvalidateArea((CoreGroup)_this, aArea );
}

/* The method Init() is invoked automatically after the component has been created. 
   This method can be overridden and filled with logic containing additional initialization 
   statements. */
void CoreGroup_Init( CoreGroup _this, XHandle aArg )
{
  /* Dummy expressions to avoid the 'C' warning 'unused argument'. */
  EW_UNUSED_ARG( aArg );

  CoreGroup_InvalidateViewState( _this );
}

/* The method FindSiblingView() searches for a sibling view of the view specified 
   in the parameter aView - aView itself will be excluded from the search operation.
   The method combines the functionality of @FindNextView() and @FindPrevView() 
   and tries to find any neighbor view (regarding the Z-order not the position).
   The additional parameter aFilter can be used to limit the search operation to 
   special views only, e.g. to visible and touchable views.
   If there are no other views complying the filter condition, the method returns 
   'null'. In contrast to other find methods, FindSiblingView() will fail, if it 
   has been invoked with aView == 'null'. */
CoreView CoreGroup_FindSiblingView( CoreGroup _this, CoreView aView, XSet aFilter )
{
  CoreView nextView;
  CoreView prevView;
  XSet notFilter;

  if (( aView == 0 ) || ( aView->Owner != _this ))
    return 0;

  nextView = aView->next;
  prevView = aView->prev;
  notFilter = CoreViewStateDialog;

  if ((( aFilter & CoreViewStateDialog ) == CoreViewStateDialog ))
    notFilter = 0;

  while (( nextView != 0 ) || ( prevView != 0 ))
  {
    if ((( nextView != 0 ) && ( !aFilter || EwSetContains( nextView->viewState, 
        aFilter ))) && ( !notFilter || !EwSetContains( nextView->viewState, notFilter 
        )))
      return nextView;

    if ((( prevView != 0 ) && ( !aFilter || EwSetContains( prevView->viewState, 
        aFilter ))) && ( !notFilter || !EwSetContains( prevView->viewState, notFilter 
        )))
      return prevView;

    if ( nextView != 0 )
      nextView = nextView->next;

    if ( prevView != 0 )
      prevView = prevView->prev;
  }

  return 0;
}

/* The method Restack() changes the Z-order of views in the component. Depending 
   on the parameter aOrder the method will elevate or lower the given view aView. 
   If aOrder is negative, the view will be lowered to the background. If aOrder 
   is positive, the view will be elevated to the foreground. If aOrder == 0, no 
   modification will take place.
   The absolute value of aOrder determines the number of sibling views the view 
   has to skip over in order to reach its new Z-order.
   Please note, changing the Z-order of views within a component containing a Core::Outline 
   view can cause this outline to update its automatic row or column formation. */
void CoreGroup_Restack( CoreGroup _this, CoreView aView, XInt32 aOrder )
{
  CoreView after;
  CoreView before;

  if ( aView == 0 )
  {
    EwThrow( EwLoadString( &_Const0003 ));
    return;
  }

  if ( aView->Owner != _this )
  {
    EwThrow( EwLoadString( &_Const0004 ));
    return;
  }

  after = aView;
  before = aView;

  while (( aOrder > 0 ) && ( after->next != 0 ))
  {
    after = after->next;
    aOrder = aOrder - 1;
  }

  while (( aOrder < 0 ) && ( before->prev != 0 ))
  {
    before = before->prev;
    aOrder = aOrder + 1;
  }

  if (( after == aView ) && ( before == aView ))
    return;

  if ((( aView->viewState & ( CoreViewStateEmbedded | CoreViewStateVisible )) == 
      ( CoreViewStateEmbedded | CoreViewStateVisible )))
  {
    if (( aView->prev != 0 ) && ( aView->layoutContext != 0 ))
      aView->prev->viewState = aView->prev->viewState | CoreViewStateRequestLayout;

    aView->viewState = aView->viewState | CoreViewStateRequestLayout;
    _this->Super2.viewState = _this->Super2.viewState | CoreViewStatePendingLayout;
    EwPostSignal( EwNewSlot( _this, CoreGroup_updateComponent ), ((XObject)_this 
      ));
  }

  if ((( aView->viewState & CoreViewStateIsOutline ) == CoreViewStateIsOutline ))
  {
    if ( aView->prev != 0 )
      aView->prev->viewState = aView->prev->viewState | CoreViewStateRequestLayout;

    aView->viewState = aView->viewState | CoreViewStateRequestLayout;
    _this->Super2.viewState = _this->Super2.viewState | CoreViewStatePendingLayout;
    EwPostSignal( EwNewSlot( _this, CoreGroup_updateComponent ), ((XObject)_this 
      ));
  }

  if ( aView->prev != 0 )
    aView->prev->next = aView->next;

  if ( aView->next != 0 )
    aView->next->prev = aView->prev;

  if ( _this->first == aView )
    _this->first = aView->next;

  if ( _this->last == aView )
    _this->last = aView->prev;

  if ( after != aView )
  {
    aView->next = after->next;
    aView->prev = after;
    after->next = aView;

    if ( aView->next != 0 )
      aView->next->prev = aView;
  }

  if ( before != aView )
  {
    aView->next = before;
    aView->prev = before->prev;
    before->prev = aView;

    if ( aView->prev != 0 )
      aView->prev->next = aView;
  }

  if ( aView->next == 0 )
    _this->last = aView;

  if ( aView->prev == 0 )
    _this->first = aView;

  if ((( aView->viewState & CoreViewStateVisible ) == CoreViewStateVisible ))
    CoreGroup__InvalidateArea( _this, CoreView__GetExtent( aView ));
}

/* Wrapper function for the virtual method : 'Core::Group.Restack()' */
void CoreGroup__Restack( void* _this, CoreView aView, XInt32 aOrder )
{
  ((CoreGroup)_this)->_VMT->Restack((CoreGroup)_this, aView, aOrder );
}

/* The method Add() inserts the given view aView into this component and places 
   it at a Z-order position resulting from the parameter aOrder. The parameter determines 
   the number of sibling views the view has to skip over starting with the top most 
   view. If aOrder == 0, the newly added view will obtain the top most position. 
   If the value is negative, the view will be lowered to the background accordingly 
   to the absolute value of aOrder. After this operation the view belongs to the 
   component - the view can appear on the screen and it can receive events.
   Please note, adding of views to a component containing a Core::Outline view can 
   cause this outline to update its automatic row or column formation. */
void CoreGroup_Add( CoreGroup _this, CoreView aView, XInt32 aOrder )
{
  if ( aView == 0 )
  {
    EwThrow( EwLoadString( &_Const0005 ));
    return;
  }

  if ( aView->Owner != 0 )
  {
    EwThrow( EwLoadString( &_Const0006 ));
    return;
  }

  aView->Owner = _this;
  aView->prev = _this->last;

  if ( _this->last != 0 )
    _this->last->next = aView;

  _this->last = aView;

  if ( _this->first == 0 )
    _this->first = aView;

  if ( aOrder != 0 )
    CoreGroup__Restack( _this, aView, aOrder );

  if ((( aView->viewState & CoreViewStateVisible ) == CoreViewStateVisible ))
    CoreGroup__InvalidateArea( _this, CoreView__GetExtent( aView ));

  if (((( _this->Focus == 0 ) && (( aView->viewState & CoreViewStateFocusable ) 
      == CoreViewStateFocusable )) && (( aView->viewState & CoreViewStateEnabled 
      ) == CoreViewStateEnabled )) && !(( aView->viewState & CoreViewStateDialog 
      ) == CoreViewStateDialog ))
    CoreGroup__OnSetFocus( _this, aView );

  if ((( aView->viewState & ( CoreViewStateEmbedded | CoreViewStateVisible )) == 
      ( CoreViewStateEmbedded | CoreViewStateVisible )))
  {
    aView->viewState = aView->viewState | CoreViewStateRequestLayout;
    _this->Super2.viewState = _this->Super2.viewState | CoreViewStatePendingLayout;
    EwPostSignal( EwNewSlot( _this, CoreGroup_updateComponent ), ((XObject)_this 
      ));
  }

  if ((( aView->viewState & CoreViewStateIsOutline ) == CoreViewStateIsOutline ))
  {
    aView->viewState = aView->viewState | CoreViewStateRequestLayout;
    _this->Super2.viewState = _this->Super2.viewState | CoreViewStatePendingLayout;
    EwPostSignal( EwNewSlot( _this, CoreGroup_updateComponent ), ((XObject)_this 
      ));
  }
}

/* Wrapper function for the virtual method : 'Core::Group.Add()' */
void CoreGroup__Add( void* _this, CoreView aView, XInt32 aOrder )
{
  ((CoreGroup)_this)->_VMT->Add((CoreGroup)_this, aView, aOrder );
}

/* Default onget method for the property 'Opacity' */
XInt32 CoreGroup_OnGetOpacity( CoreGroup _this )
{
  return _this->Opacity;
}

/* Variants derived from the class : 'Core::Group' */
EW_DEFINE_CLASS_VARIANTS( CoreGroup )
EW_END_OF_CLASS_VARIANTS( CoreGroup )

/* Virtual Method Table (VMT) for the class : 'Core::Group' */
EW_DEFINE_CLASS( CoreGroup, CoreRectView, "Core::Group" )
  CoreRectView_initLayoutContext,
  CoreView_GetRoot,
  CoreGroup_Draw,
  CoreView_HandleEvent,
  CoreGroup_CursorHitTest,
  CoreRectView_ArrangeView,
  CoreRectView_MoveView,
  CoreRectView_GetExtent,
  CoreGroup_ChangeViewState,
  CoreGroup_OnSetBounds,
  CoreGroup_OnSetFocus,
  CoreGroup_OnSetOpacity,
  CoreGroup_DispatchEvent,
  CoreGroup_BroadcastEvent,
  CoreGroup_UpdateLayout,
  CoreGroup_UpdateViewState,
  CoreGroup_InvalidateArea,
  CoreGroup_Restack,
  CoreGroup_Add,
EW_END_OF_CLASS( CoreGroup )

/* Initializer for the class 'Core::Root' */
void CoreRoot__Init( CoreRoot _this, XObject aLink, XHandle aArg )
{
  /* At first initialize the super class ... */
  CoreGroup__Init( &_this->_Super, aLink, aArg );

  /* ... then construct all embedded objects */
  CoreTimer__Init( &_this->cursorHoldTimer, &_this->_XObject, 0 );

  /* Setup the VMT pointer */
  _this->_VMT = EW_CLASS( CoreRoot );

  /* ... and initialize objects, variables, properties, etc. */
  _this->Super3.viewState = CoreViewStateAlphaBlended | CoreViewStateEnabled | CoreViewStateFocusable 
  | CoreViewStateFocused | CoreViewStateSelected | CoreViewStateTouchable | CoreViewStateVisible;
  _this->hasRootFocus = 1;
  CoreTimer_OnSetPeriod( &_this->cursorHoldTimer, 50 );
  _this->CursorDragLimit = 8;
  _this->CursorSequelDelay = 250;
  _this->cursorHoldTimer.OnTrigger = EwNewSlot( _this, CoreRoot_cursorHoldTimerProc 
  );
}

/* Re-Initializer for the class 'Core::Root' */
void CoreRoot__ReInit( CoreRoot _this )
{
  /* At first re-initialize the super class ... */
  CoreGroup__ReInit( &_this->_Super );

  /* ... then re-construct all embedded objects */
  CoreTimer__ReInit( &_this->cursorHoldTimer );
}

/* Finalizer method for the class 'Core::Root' */
void CoreRoot__Done( CoreRoot _this )
{
  /* Finalize this class */
  _this->_VMT = EW_CLASS( CoreRoot );

  /* Finalize all embedded objects */
  CoreTimer__Done( &_this->cursorHoldTimer );

  /* Don't forget to deinitialize the super class ... */
  CoreGroup__Done( &_this->_Super );
}

/* Garbage Collector method for the class 'Core::Root' */
void CoreRoot__Mark( CoreRoot _this )
{
  EwMarkObject( _this->keyLastTarget );
  EwMarkObject( _this->modalGroups );
  EwMarkObject( &_this->cursorHoldTimer );
  EwMarkObject( _this->cursorCaptureView );
  EwMarkObjects( _this->cursorTargetView );
  EwMarkObject( _this->canvas );
  EwMarkObject( _this->VirtualKeyboard );

  /* Give the super class a chance to mark its objects and references */
  CoreGroup__Mark( &_this->_Super );
}

/* The method GetRoot() delivers the application object, this view belongs to. The 
   application object represents the entire screen of the GUI application. Thus 
   in the views hierarchy, the application object serves as the root view.
   This method can fail and return null if the view still doesn't belong to any 
   owner group. */
CoreRoot CoreRoot_GetRoot( CoreRoot _this )
{
  return _this;
}

/* The method Draw() is invoked automatically if parts of the view should be redrawn 
   on the screen. This can occur when e.g. the view has been moved or the appearance 
   of the view has changed before.
   Draw() is invoked automatically by the framework, you never will need to invoke 
   this method directly. However you can request an invocation of this method by 
   calling the method InvalidateArea() of the views @Owner. Usually this is also 
   unnecessary unless you are developing your own view.
   The passed parameters determine the drawing destination aCanvas and the area 
   to redraw aClip in the coordinate space of the canvas. The parameter aOffset 
   contains the displacement between the origin of the views owner and the origin 
   of the canvas. You will need it to convert views coordinates into these of the 
   canvas.
   The parameter aOpacity contains the opacity descended from this view's @Owner. 
   It lies in range 0 .. 255. If the view implements its own 'Opacity', 'Color', 
   etc. properties, the Draw() method should calculate the resulting real opacity 
   by mixing the values of these properties with the one passed in aOpacity parameter.
   The parameter aBlend contains the blending mode descended from this view's @Owner. 
   It determines, whether the view should be drawn with alpha-blending active or 
   not. If aBlend is false, the outputs of the view should overwrite the corresponding 
   pixel in the drawing destination aCanvas. If aBlend is true, the outputs should 
   be mixed with the pixel already stored in aCanvas. For this purpose all Graphics 
   Engine functions provide a parameter to specify the mode for the respective drawing 
   operation. If the view implements its own 'Blend' property, the Draw() method 
   should calculate the resulting real blend mode by using logical AND operation 
   of the value of the property and the one passed in aBlend parameter. */
void CoreRoot_Draw( CoreRoot _this, GraphicsCanvas aCanvas, XRect aClip, XPoint 
  aOffset, XInt32 aOpacity, XBool aBlend )
{
  XBool fullScreenUpdate = 0;

  fullScreenUpdate = (XBool)EwFullScreenUpdate;

  if ( !fullScreenUpdate )
    GraphicsCanvas_FillRectangle( aCanvas, aClip, EwMoveRectPos( EwMoveRectPos( 
    aClip, aOffset ), _this->Super2.Bounds.Point1 ), _Const0007, _Const0007, _Const0007, 
    _Const0007, 0 );

  CoreGroup_Draw((CoreGroup)_this, aCanvas, aClip, aOffset, aOpacity, aBlend );
}
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
