gustavowd/FreePMU/STM32F769_EWizard/Src/RGB565/ewextgfx.h

/*******************************************************************************
*
* E M B E D D E D   W I Z A R D   P R O J E C T
*
*                                                Copyright (c) TARA Systems GmbH
*                                    written by Paul Banach and Manfred Schweyer
*
********************************************************************************
*
* This software and related documentation ("Software") are intellectual
* property owned by TARA Systems and are copyright of TARA Systems.
* Any modification, copying, reproduction or redistribution of the Software in
* whole or in part by any means not in accordance with the End-User License
* Agreement for Embedded Wizard is expressly prohibited. The removal of this
* preamble is expressly prohibited.
*
********************************************************************************
*
* DESCRIPTION:
*   This header file contains Graphics Engine configuration parameters and the
*   adaptation for the STM32 graphics subsystem.
*
*******************************************************************************/

#ifndef EWEXTGFX_H
#define EWEXTGFX_H

#ifdef __UVISION_VERSION
#include "RTE_Components.h"
#endif


#ifdef __cplusplus
  extern "C"
  {
#endif

/* Defines for different framebuffer color formats */
#define EW_FRAME_BUFFER_COLOR_FORMAT_Index8   1
#define EW_FRAME_BUFFER_COLOR_FORMAT_LumA44   2
#define EW_FRAME_BUFFER_COLOR_FORMAT_RGB565   3
#define EW_FRAME_BUFFER_COLOR_FORMAT_RGB888   4
#define EW_FRAME_BUFFER_COLOR_FORMAT_RGBA4444 5
#define EW_FRAME_BUFFER_COLOR_FORMAT_RGBA8888 6


/*
   The color format of the framebuffer has to correspond to color format of the
   Graphics Engine - otherwise the Graphics Engine cannot draw directly into
   this framebuffer, because the Graphics engine is prepared and optimized for
   one dedicated color format.

   The color format of the LCD / framebuffer can be defined within the makefile
   by setting the macro EW_FRAME_BUFFER_COLOR_FORMAT.

   According your makefile settings, the resulting color depth is determined.
*/
#if ( EW_FRAME_BUFFER_COLOR_FORMAT == EW_FRAME_BUFFER_COLOR_FORMAT_RGB565 )
  #define FRAME_BUFFER_DEPTH    2
#else
  #error The given EW_FRAME_BUFFER_COLOR_FORMAT is not supported! Use RGB565 within your makefile!
#endif


/*
  EW_USE_DOUBLE_BUFFER - Flag to switch on/off the usage of an additional
  framebuffer, so that the screen is operated in double-buffering mode.
  Per default, the usage of double-buffering is disabled. To activate the
  double-buffering mode, please set the macro EW_USE_DOUBLE_BUFFER to 1
  within your makefile. This can be achieved by using the compiler flag
  -DEW_USE_DOUBLE_BUFFER=1
  If double-buffering is activated, the exchange between front-buffer and
  back-buffer has to be done at V-sync. This has to be implemented in the
  extern function EwBspSetFramebufferAddress().
*/
#ifndef EW_USE_DOUBLE_BUFFER
  #define EW_USE_DOUBLE_BUFFER 0
#endif

#if EW_USE_DOUBLE_BUFFER == 0
  #undef EW_USE_DOUBLE_BUFFER
#endif


/*
  EW_USE_SCRATCHPAD_BUFFER - Flag to switch on/off the usage of a small
  scratch-pad buffer used for the graphics composition instead of a framebuffer.
  As a result the screen of the display is updated in partial mode.
  This mode is used to reduce the memory footprint to a minimum, but it may cause
  some tearing or flickering effects. This mode is useful in combination with
  displays containing its own graphics memory (GRAM).
  This mode cannot be combined with double-buffering mode.
  Per default, the usage of scratch-pad buffer is disabled. To activate the
  scratch-pad buffer mode, please set the macro EW_USE_SCRATCHPAD_BUFFER to 1
  within your makefile. This can be achieved by using the compiler flag
  -DEW_USE_SCRATCHPAD_BUFFER=1
*/
#ifndef EW_USE_SCRATCHPAD_BUFFER
  #define EW_USE_SCRATCHPAD_BUFFER 0
#endif

#if EW_USE_SCRATCHPAD_BUFFER == 0
  #undef EW_USE_SCRATCHPAD_BUFFER
#endif


/*
  EW_USE_DMA2D_GRAPHICS_ACCELERATOR - Flag to switch on/off the usage of the
  graphics accelerator within the STM32 target (DMA2D / Chrom-ART).
  Per default, the usage of the DMA2D is enabled. To switch off the usage of
  the DMA2D, please set the macro EW_USE_DMA2D_GRAPHICS_ACCELERATOR to 0 within
  your makefile. This can be achieved by using the compiler flag
  -DEW_USE_DMA2D_GRAPHICS_ACCELERATOR=0
*/
#ifndef EW_USE_DMA2D_GRAPHICS_ACCELERATOR
  #define EW_USE_DMA2D_GRAPHICS_ACCELERATOR 1
#endif

#if EW_USE_DMA2D_GRAPHICS_ACCELERATOR == 0
  #undef EW_USE_DMA2D_GRAPHICS_ACCELERATOR
#endif


/* The following macros override the default color channel allocation to the
   order (bit31) A..R..G..B (bit0). If your graphics hardware supports other
   color channel order, you can define the following macros in your make file. */
#ifndef EW_COLOR_CHANNEL_BIT_OFFSET_RED
  #define EW_COLOR_CHANNEL_BIT_OFFSET_RED    16
#endif

#ifndef EW_COLOR_CHANNEL_BIT_OFFSET_GREEN
  #define EW_COLOR_CHANNEL_BIT_OFFSET_GREEN   8
#endif

#ifndef EW_COLOR_CHANNEL_BIT_OFFSET_BLUE
  #define EW_COLOR_CHANNEL_BIT_OFFSET_BLUE    0
#endif

#ifndef EW_COLOR_CHANNEL_BIT_OFFSET_ALPHA
  #define EW_COLOR_CHANNEL_BIT_OFFSET_ALPHA  24
#endif


/* STM32 operates with premultiplied colors - but bitmap formats are NOT premultiplied */
#define EW_PREMULTIPLY_COLOR_CHANNELS         0


/* The RGB565 Platform Package uses a screen color format when drawing into the
   framebuffer - internally created buffers will use the RGBA8888 color format
   in order to achive best quality and to support alpha channel. */
#define EW_USE_PIXEL_FORMAT_SCREEN


/* The following macros override the default color channel allocation to the
   order (bit15) R..G..B (bit0). If your graphics hardware supports other
   color channel order, you can define the following macros in your make file. */
#ifndef EW_SCREEN_COLOR_CHANNEL_BIT_OFFSET_RED
  #define EW_SCREEN_COLOR_CHANNEL_BIT_OFFSET_RED    11
#endif

#ifndef EW_SCREEN_COLOR_CHANNEL_BIT_OFFSET_GREEN
  #define EW_SCREEN_COLOR_CHANNEL_BIT_OFFSET_GREEN   5
#endif

#ifndef EW_SCREEN_COLOR_CHANNEL_BIT_OFFSET_BLUE
  #define EW_SCREEN_COLOR_CHANNEL_BIT_OFFSET_BLUE    0
#endif


/*******************************************************************************
* FUNCTION:
*   STM32InitGfx
*
* DESCRIPTION:
*   The function STM32InitGfx is called from the Graphics Engine during the
*   initialization in order to make target specific configurations of the
*   Graphics Engine
*
* ARGUMENTS:
*   aArgs - Optional argument passed to the Graphics Engine init function.
*
* RETURN VALUE:
*   If successful, returns != 0.
*
*******************************************************************************/
int STM32InitGfx
(
  void*             aArgs
);


/*******************************************************************************
* FUNCTION:
*   STM32InitViewport
*
* DESCRIPTION:
*   The function STM32InitViewport is called from the Graphics Engine,
*   to create a new viewport on the target. The function uses the given
*   buffers passed in the arguments aDisplay1, aDisplay2 and aDisplay3.
*
* ARGUMENTS:
*   aWidth,
*   aHeight       - Size of the application in pixel.
*   aExtentX,
*   aExtentY      - not used.
*   aExtentWidth,
*   aExtentHeight - Size of the physical or virtual framebuffer in pixel.
*   aOrient       - not used.
*   aOpacity      - not used.
*   aDisplay1     - Address of the framebuffer / front-buffer.
*   aDisplay2     - Address of the back-buffer in case of double-buffering.
*   aDisplay3     - Address of the scratch-pad buffer.
*
* RETURN VALUE:
*   Handle of the surface descriptor (viewport).
*
*******************************************************************************/
unsigned long STM32InitViewport
(
  int               aWidth,
  int               aHeight,
  int               aExtentX,
  int               aExtentY,
  int               aExtentWidth,
  int               aExtentHeight,
  int               aOrient,
  int               aOpacity,
  void*             aDisplay1,
  void*             aDisplay2,
  void*             aDisplay3
);


/*******************************************************************************
* FUNCTION:
*   STM32DoneViewport
*
* DESCRIPTION:
*   The function STM32DoneViewport is called from the Graphics Engine, to
*   release a previously created viewport on the STM32 target.
*
* ARGUMENTS:
*   aHandle - Handle of the surface descriptor (viewport).
*
* RETURN VALUE:
*   None
*
*******************************************************************************/
void STM32DoneViewport
(
  unsigned long     aHandle
);


/*******************************************************************************
* FUNCTION:
*   STM32BeginUpdate
*
* DESCRIPTION:
*   The function STM32BeginUpdate is called from the Graphics Engine, to
*   initiate the screen update cycle.
*
* ARGUMENTS:
*   aHandle - Handle of the surface descriptor (viewport).
*
* RETURN VALUE:
*   Handle of the destination surface, used for all drawing operations.
*
*******************************************************************************/
unsigned long STM32BeginUpdate
(
  unsigned long     aHandle
);


/*******************************************************************************
* FUNCTION:
*   STM32BeginUpdateArea
*
* DESCRIPTION:
*   The function STM32BeginUpdateArea is called from the Graphics Engine, to
*   initiate a partial screen update cycle.
*
* ARGUMENTS:
*   aHandle - Handle of the surface descriptor (viewport).
*   aX,
*   aY,
*   aWidth,
*   aHeight - Position and size of the area affected by the screen update
*     (dirty rectangle).
*
* RETURN VALUE:
*   Handle of the destination surface, used for all drawing operations.
*
*******************************************************************************/
unsigned long STM32BeginUpdateArea
(
  unsigned long     aHandle,
  int               aX,
  int               aY,
  int               aWidth,
  int               aHeight
);


/*******************************************************************************
* FUNCTION:
*   STM32EndUpdate
*
* DESCRIPTION:
*   The function STM32EndUpdate is called from the Graphics Engine, to
*   finalize the screen update cycle.
*
* ARGUMENTS:
*   aHandle - Handle of the surface descriptor (viewport).
*   aX,
*   aY,
*   aWidth,
*   aHeight - Position and size of the area affected from the screen update
*     (dirty rectangle).
*
* RETURN VALUE:
*   None
*
*******************************************************************************/
void STM32EndUpdate
(
  unsigned long     aHandle,
  int               aX,
  int               aY,
  int               aWidth,
  int               aHeight
);


/* Redirect the following operations to the functions within this module */
#define EwGfxInit            STM32InitGfx
#define EwGfxInitViewport    STM32InitViewport
#define EwGfxDoneViewport    STM32DoneViewport
#define EwGfxBeginUpdate     STM32BeginUpdate
#define EwGfxBeginUpdateArea STM32BeginUpdateArea
#define EwGfxEndUpdate       STM32EndUpdate


/*******************************************************************************
* FUNCTION:
*   STM32CreateSurface
*
* DESCRIPTION:
*   The function STM32CreateSurface() reserves pixel memory for a new surface
*   with the given size and color format. The function returns a handle to the
*   new surface.
*
* ARGUMENTS:
*   aFormat  - Color format of the surface. (See EW_PIXEL_FORMAT_XXX).
*   aWidth,
*   aHeight  - Size of the surface in pixel to create.
*
* RETURN VALUE:
*   The function returns a handle to the created surface. This can be a pointer
*   to a dynamically allocated data structure, an index in a list of surfaces,
*   or a handle returned by the lower level API.
*
*   If the creation is failed, the function should return 0.
*
*******************************************************************************/
unsigned long STM32CreateSurface
(
  int               aFormat,
  int               aWidth,
  int               aHeight
);


/*******************************************************************************
* FUNCTION:
*   STM32CreateConstSurface
*
* DESCRIPTION:
*   The function STM32CreateConstSurface() creates a surface structure
*   that refers to a constant pixel memory. The function returns a handle to the
*   new surface.
*
* ARGUMENTS:
*   aFormat - Color format of the surface. (See EW_PIXEL_FORMAT_XXX).
*   aWidth,
*   aHeight - Size of the surface in pixel.
*   aMemory - Pointer to constant pixel memory.
*
* RETURN VALUE:
*   The function returns a handle to the created surface.
*   If the creation is failed, the function should return 0.
*
*******************************************************************************/
unsigned long STM32CreateConstSurface
(
  int               aFormat,
  int               aWidth,
  int               aHeight,
  XSurfaceMemory*   aMemory
);


/*******************************************************************************
* FUNCTION:
*   STM32DestroySurface
*
* DESCRIPTION:
*   The function STM32DestroySurface() frees the resources of the given surface.
*   This function is a counterpart to STM32CreateSurface().
*
* ARGUMENTS:
*   aHandle - Handle to the surface to free.
*
* RETURN VALUE:
*   None
*
*******************************************************************************/
void STM32DestroySurface
(
  unsigned long     aHandle
);
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
