gustavowd/FreePMU/(commit log)

2018-05-18 Primeira versão do projeto no gitlab
    [.custom.cfg, MedidorCopel Debug.cfg, MedidorCopel.cfg]
2018-05-24 Inserção da tela de FFT e anotações dos métodos dentro do auto-objeto. Organização das cores dos fasores em constantes. Também foi inserido uma variante do Action Button, chamado ModifiedButton, que 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
2018-05-25 Inserida a adaptação do projeto para o STM32F769 e seus respectivos recursos de imagem.
2018-05-28 Adicionado projeto do STM32F769
    [STM32F769_EWizard Debug.cfg]
2018-05-28 Correção das inclusões de pastas de includes.
2018-05-28 Modificação do clock para 200 MHz. Habilitados somente 3 canais de ADC. Mudança do TIM1 para o TIM2 no trigger do ADC.
2018-05-28 Corrigido temporizador TIM2 para o clock correto.
    [main.c]
2018-05-28 Corrigidas mensagens e ações do servidor de dados para o PDC
    [dhcp_client.c, main.c, tarefasPMU.c, tcp_server.c, vnc_app.c]
2018-05-28 Corrigido tamanho da tela para o 769, os textos do servidor no 746 e o texto inferior da parte do servidor para ambos.
2018-05-28 Desfeita a correção do tamanho da tela. Ao invés disso, seu conteúdo foi movido 8 pixels para baixo.
2018-05-29 Acerto da interface na tela de 800x472. Volta do timer para TIM1 / trigger PA12
2018-05-29 Correção para 256 amostras em 60 Hz
2018-05-30 Corrigidos problemas de sincronização do ADC. Primeira versão funcional da PMU no 769.
    [main.c, tarefasPMU.c]
2018-05-30 Modificação dos valores de exibição de fase e magnitude.
2018-05-30 USART1 configurada para funcionar com interrupção. Transmissão dos dados adquiridos pela serial.
2018-05-30 Correção da interface gráfica para a FFT e para mostrar as fases de -180 a 180 graus.
2018-05-30 Modificações no código do STM32F746 para receber o pulso por ETR.
2018-06-06 Pequenos testes na PMU com o STM32F769
2018-06-07 Adicionado suporte a porta serial pela USB no kit STM32F746
2018-06-12 Atualização dos gráficos atualizada para 100ms
2018-06-13 Mudança de endereço da SDRAM utilizada para framebuffer de 0xC0000000 para 0x60000000, pois essa faixa de endereço é cacheable.
2018-06-13 Volta do endereço do framebuffer para o original.
2018-06-14 Atualização do servidor PDC para o 769 e aumento do heap do FreeRTOS
2018-06-14 Mais correções para o servidor PDC no STM32F769
2018-06-14 Mudanças para corrigir erros de conexão com o cliente PDC
    [ethernetif.c, ew_bsp_serial.c, tcp_server.c, vnc_app.c]
2018-06-19 Projeto de teste alterado com o TIM2 disparando a 30 Hz e suporte a porta serial adicionado.
2018-06-20 Mudança para disparar o TIM2 pelo pino PA0 (botão do kit) no 769
2018-06-20 Pequena correção na posição do código para troca de estado do LED na interrupção de DMA
2018-06-21 Testes para melhorar o desempenho da pmu com o timer de 30 hz
2018-06-21 Completando estrutura de dados na mudança de modo de operação do trigger
2018-06-21 Mudança da frequencia para 210 MHz na correção do clock
2018-06-21 Correção de um pequeno erro
2018-06-21 Habilitada interrupção da tim2 para avaliar o sincronismo. Corrigido clock do lcd.
    [ew_bsp_system.c, main.c, tarefasPMU.c]
2018-06-24 Atualização do projeto para o Embedded Wizard 9.00. Adicionado telas de configuração para os gráficos de frequência, magnitude e fase. Otimização da plotagem dos gráficos por meio de imagens vetoriai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
2018-06-24 Atualização dos arquivos de plataforma embedded wizard para a versão 9.0 no STM32F769
2018-06-24 Adicionado função ButtonStatus para alterar o estado dos botões Iniciar e Parar na tela de servidor.
2018-06-24 Atualizado arquivos de aplicação da interface e bibliotecas do Embedded Wizard para versão 9.0 para o 746.
2018-06-24 Atualização do projeto do STM32F769 com botão de configutação e versão 9.0 do embedded wizard
2018-06-25 Adicionados arquivos faltantes para compilar aplicação embedded wizard no projeto do STM32F769.
2018-06-25 Remoção de arquivos desnecessários
2018-06-25 Última versão da aplicação nos projetos dos STM32F7
2018-06-25 Adicionado teste de valor residual na taxa de amostragem para definir o valor mais próximo do idel. Adicionado controle do botão start e stop do servidor PDC pelo código.
2018-06-25 Correção no tamanho da pilha da tarefa DHCP. Remoção de estado inicial dos botão do servidor PDC do código da tarefa DHCP.
2018-06-29 Mudança no tim2 para fazer um deinit e depois inicializar novamente a cada 30 pulsos
2018-07-03 Icone de configuração aumentado.
2018-07-04 Correções na aquisição de dados da PMU (corrigido bug de pulsos na aquisição de fase e frequencia)
    [main.c, tarefasPMU.c]
2018-07-05 Sobreamostragem de 4x e média a cada 4 pontos para melhorar a resposta do ADC a erros aleatórios (distribuição normal)
2018-07-09 Adicionado buffer do ADC na memória DTCM. Remoção da sobreamostragem com média. Aumento do clock do ADC.
2018-07-09 As seguintes correções do 769 foram aplicadas no projeto do 746: - Clock da MCU de 200 para 210MHz - Timers para refletir a mudança de clock - Prioridade das interrupções - Clock do LCD
    Foi adicionado:
    - Valor residual taxa de amostragem
    - Sobreamostragem de 4 vezes
    - ADCBuffer na DTCM
2018-07-11 PMU com o STM32F769 com sobreamostragem de 4x e média para filtrar ruídos da aquisição.
2018-07-12 Correção na média dos pontos sobreamostrados. Aumento da sobreamostragem para 8 pontos.
2018-07-20 Adicionado suporte a 50 Hz na PMU com o STM32F769. Tela de frequencia mostrando centro em 50 Hz. Adicionadadas definições para alterar entre 50 e 60 Hz e para ligar a sobreamostragem.
    [STM32F769_EWizard Debug.cfg]
2018-07-20 Pequena correção para o TIM2 em 60 Hz
2018-07-23 Embedded Wizard: Botões para alterar a frequência base no gráfico de frequência - 50, 55 e 60Hz. Adicionada taxa de amostragem de 25Hz.
2018-07-24 Frequencia central padrão definida como 50 Hz. Taxa de atualização padrão 25 fps.
2018-07-25 Correção do bug de escala na inicialização do gráfico de frequência.
2018-07-25 Atualização da interface gráfica para a versão com correção de escala inicial.
2018-09-20 Implementação da estrutura de dados da fila de SOCs
2018-12-06 Correções no código do STM32F746.
2019-02-13 Refatorado trechos do código
    -> Função "MX_USART1_UART_Init() removida, não era utilizada pra nada.
    -> Haviam as funções "UARTPutString()" e "SerialSend()" declaradas em um #if 0 na main.c. Removidas
    -> Foram removidas declarações de "if EW_USE_FREE_RTO". Por padrão sempre usará FreeRTOS
    -> Removida a declaração da função "CalculaMediaADC(uint16*)", esta função não existe.
    -> Removida a declaração da função " SSL_Client(void const*), esta função existe no arquivo ssl_client.c, mas nunca é
    chamada. Quando for utilizar, chamar a biblioteca.
    -> O arquivo "vnc_app.c" foi atualizado para a versão em que o Gustavo Dernardin fez commit há um tempo atrás.
    [New_configuration.cfg, PMU-Debug.cfg]
2019-02-18 Adicionada Documentação
    Documentos importantes para o desenvovimento foram adicionados ao projeto, por facilidade
2019-04-02 Corrigida a recepção do SOC
    O GPS envia vários pacotes com dados. Anteriormente, era suposto que o GPS enviava um pacote com o dia da semana. Este pacote era usado para calcular o SOC. Porém, não havia qualquer verificação do pacote, fazendo a PMU calcular vários SOCs inválidos. Além disso, o pacote esperado não era nem recebido. Foi procurado na lista de pacotes recebidos um que permite o cálculo do SOC, feita a verificação, extraído os dados necessários e calculado o SOC correto. Este cálculo foi validade com alguns aplicativos online.
    [main.c, tarefasPMU.c]
2019-04-04 Correção de pequenos erros
    Alguns pequenos erros foram corrigidos. A PMU finalmente está enviando dados, os quais estão sendo recebidos pelo PMUConectionTester
    [frameDataQ.c, frameDataQ.h, tarefasPMU.c, tcp_server.c]
2019-04-16 Correção do Fraction of second
    Fraction of second era colocado de modo descincronizado nos dados enviados, de modo que o primeiro frame de cada SOC não necessarimente continha um Fraction of second=0.
    Corrigido.
    [tarefasPMU.c]
2019-04-30 Iniciando a portabilidade para o F769
    Iniciou-se a portabilidade para o STM32F769. O TIM2 utilizado neste projeto não era acessível pelo kit, por isso alterou-se para o TIM8. Porém, depois dessa alteração, entra na tarefa de erro mesmo antes de abrir a interface.
    Além disso, a lógica da fila e do envio dos frames foi portado.
    [PMU-Debug-F769.cfg]
2019-05-02 Correção do uso dos Timers pro 762
    O código tentava trigar o TIM1 pelo TIM8, porém isso não é possível. Agora o TIM8 triga o TIM1.
    Além disso, o pino usado para fazer o Trigger já estava sendo usado.
2019-05-27 Adicionados polinômios de interpolação para calibração da instrumentação. Usando novo formato e com dados de calibração das duas PMUs da UFSC.
2019-05-27 Modificado dhcp_client.c para suportar IP fixo. Para isso foi adicionado um #ifdef no arquivo.
    [dhcp_client.c]
2019-05-27 Correção na transmissão de dados para a plataforma de testes
2019-05-29 Adicionado suporta a PPS com 30 Hz. Substituição de valores por defines em alguns calculos.
2019-05-29 Modificação do controle do FracSec com uso de 30 pulsos por segundo
2019-05-29 Pequena correção no código de incremento do FracSec
2019-05-30 Correção no FracSec para sempre começar com valor 0 no primeiro pacote
2019-05-30 Adicionado suporte aos protocolos NMEA e UBX para o GPS com escolha por define.
2019-05-30 Correção no código de escolha dos protocolos do GPS
2019-05-30 Validação do pacote NMEA recebido
    Além de verificar se o pacote recebido é o GPRMC, verificou-se se foi recebido todas as informações necessárias para o cálculo do SOC. Caso a data não for recebida, usa-se a última data válida. Caso a hora não for recebida, não atualiza-se o SOC
2019-05-30 Código para decodificar NMEA corrigido.
    [tarefasPMU.c]
2019-05-30 Corrigido tamanho do buffer da mensagem GPS para nmea.
    [tarefasPMU.c]
2019-05-31 Adicionada possibilidade de desligar DFT (FFT como padrão); possibilidade de desligar o envio serial para a plataforma de testes;seleção de fatores de calibração da PMU
2019-05-31 Mudança do pino de trigger na versão com PPS de 30Hz para PA12 (D13)
2019-05-31 Correção na definicao de trigger por timer para o ADC com PPS de 30 Hz
2019-05-31 Modificados valores default dos gráficos da GUI para 60Hz e 220V.
2019-06-04 Adicionado pino para ligar o GPS
    O pino PJ1 foi utilizado para ligar o GPS. Quando o micro for reiniciado, os PPS podem não ser interrompidos. Isso acaba provocando uma desincronização da medição fasorial com os SOCs corretos.
2019-06-13 Corrigida soncronização do SOC com o PPS na versão de 30 Hz
    Verificou-se que quando o GPS está configurado para 30 Hz, o SOC é enviado antes do primeiro PPS.
    [main.c, main.h, tarefasPMU.c]
2019-06-18 Correcao no teste de envio de pacotes pela fila
2019-08-23 Corrigido variações na frequencia
    [main.c, main.h, tarefasPMU.c]
2019-08-23 Adicionados defines para configurar o ajuste de frequencia e do timer
2021-03-18 Pacote de dados agora transmite fundamental e 10 harmônicas.
2021-03-19 Removidos arquivos desnecessários 2.
    [.custom.cfg, MedidorCopel Debug.cfg, MedidorCopel.cfg, New_configuration.cfg, PMU-Debug.cfg]
2021-03-21 Corrigido tamanho de pacotes de mensagens na função de checksum para 16 bits
    [tarefasPMU.c]
2021-03-21 Corridiga declaração de variável como uint 16 bits
2021-03-22 Melhorias na tarefa de comunicação
2021-03-22 Correções para deixar o código da comunicação e GPS mais genérico para 50/60Hz e diferentes tamanhos de pacotes de dados.
2021-03-22 Correção de travamento com adição de mutex. Correção da transmissão de dados com fasores.
2021-03-22 Adicionados arquivos da PCI.
    [PCB_Instrumentação_v2.brd, PCB_Instrumentação_v2.sch]
2021-03-24 Adicionados ganhos para as harmônicas serem mostradas normalizadas em relação a 127 ou 220V
2021-03-24 Ganhos e curvas de ajuste são definidos no arquivo main.h
2021-03-24 Adicionada configuração para a tensão RMS padrão (127 ou 220V)
2021-03-24 Adicionadas as configurações .h das duas PMUs de teste. Suporte a 4 ganhos para a fase.
2021-03-26 Adicionado envio de harmônica nas três fases. Adicionado cálculo de THD. Adicionado reconhecimento automático do tipo de pacote do módulo GPS. Correção no tamanho do pacote de dados para a fila de me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
2021-03-26 Adicionada nova versão da interface gráfica para o kit STM32F769.
2021-03-29 Correção para enfileirar o tamanho correto de pacotes. Adicionada proteção contra estouro de memória ao enfileirar muitos pacotes sem newSOC.
2021-03-29 Retirado teste de pacote válido no protocolo NMEA, mensagem GPRMC.
2021-03-30 Corrigido erro de harmônicas superiores a 20% (imprimia um warning no terminal). Adicionada configuração para habilitar/desabilitar harmonicas na transferencia para o PDC.
    [frameDataQ.h, main.h, tarefasPMU.c, tcp_server.c]
2021-03-30 Correção de harmônicas fora do gráfico nas fases S e T.
2021-03-31 Adicionada possibilidade de simular o GPS com estampa de tempo e PPS
2021-03-31 Adicionado print de mensagens de erro no terminal para falha de malloc e estouro de pilha das tarefas.
2021-04-06 Corrigido o local de zerar a variável newSOC. Corrigido cálculo de CRC depois de alterar o SOC nos pacotes da fila.
    [frameDataQ.c, main.h, tarefasPMU.c]
2021-04-06 Alterada prioridade da tarefa DHCP. A tarefa do GPS deve ter maior prioridade que o DHCP e a comunicação.
2021-04-07 Adicionado configuração para transmitir somente os fasores das harmônicas da primeira fase. Compatibilidade para o openPDC
2021-04-07 Agora a PMU com harmônicas opera como 4 PMUs separadas, uma para as fundamentais e as outras 3 para as harmônicas de cada fase.
2021-04-15 Adicionada possibilidade de enviar dados de fasores pela porta serial.
2021-04-15 Adicionado código em python para receber os dados da PMU pela porta serial.
